rsenn/lc-meter/images/photos/DSC03275.png

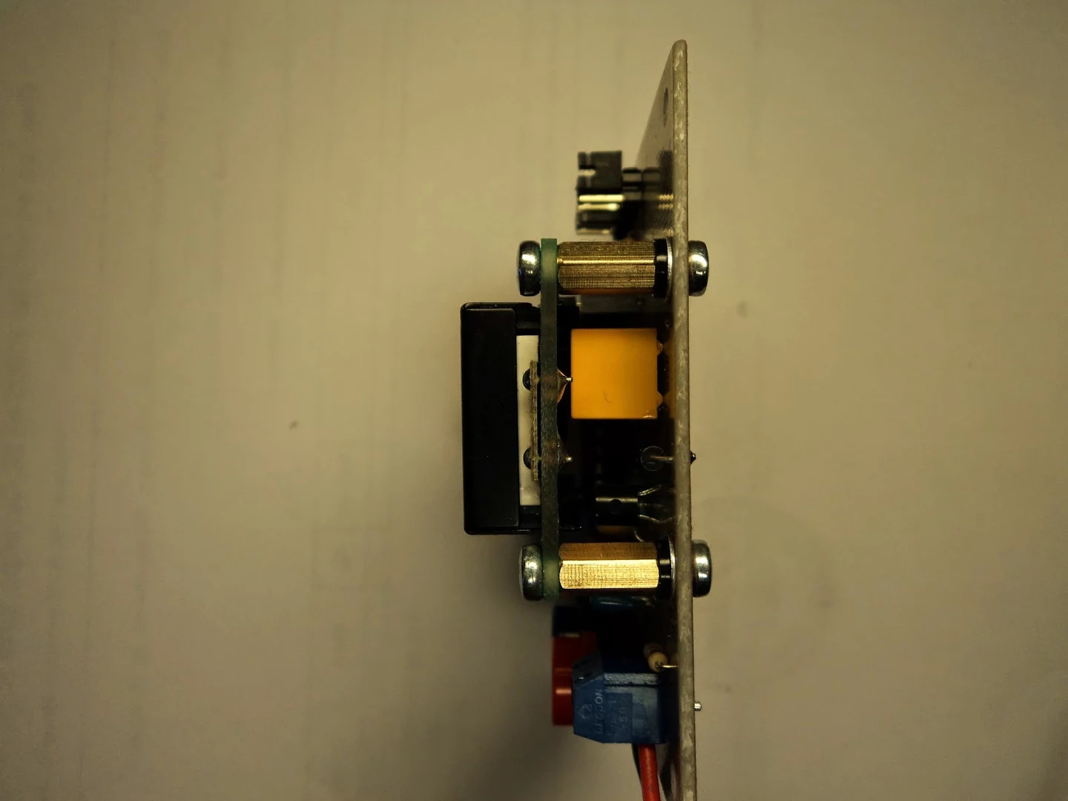
images/photos/DSC03275.png
