rsenn/lc-meter/images/lc-meter/Cardboard_Elsie_LC_meter.jpg

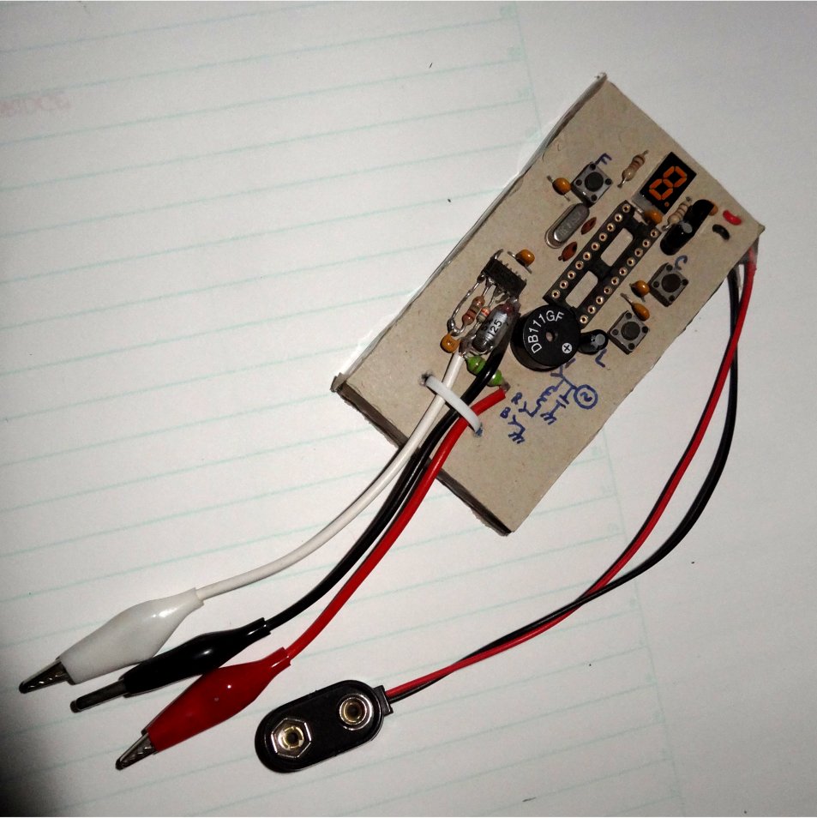
images/lc-meter/Cardboard_Elsie_LC_meter.jpg
