rsenn/lc-meter/807_lc_meter/pictures/P9010032_.JPG

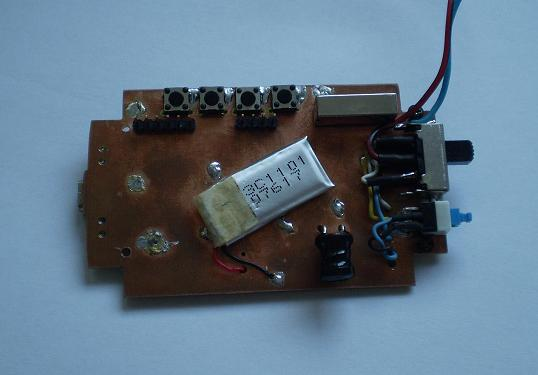
807_lc_meter/pictures/P9010032_.JPG
