rsenn/lc-meter/807_lc_meter/pictures/P9010042_.JPG

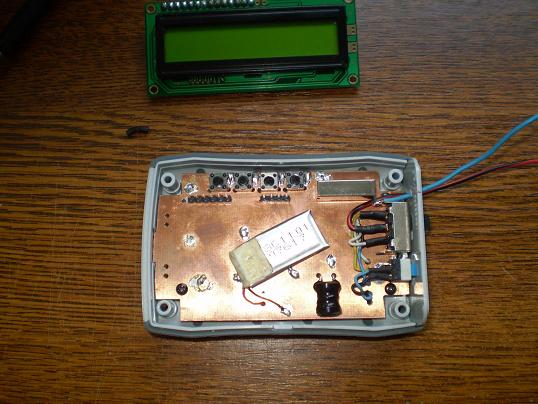
807_lc_meter/pictures/P9010042_.JPG
