rsenn/lc-meter/807_lc_meter/pictures/P9010051_.JPG

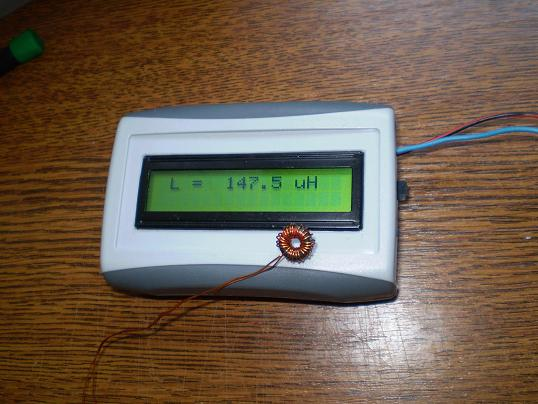
807_lc_meter/pictures/P9010051_.JPG
