rsenn/lc-meter/807_lc_meter/pictures/P9150070_.JPG

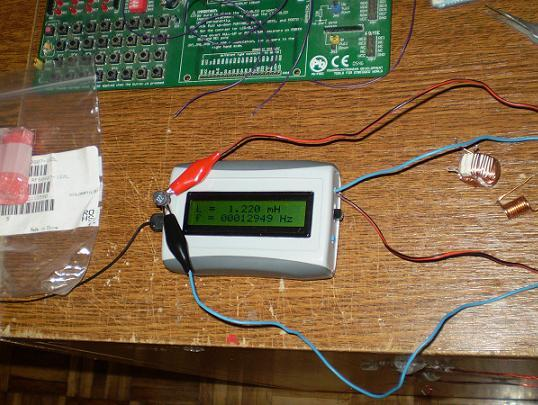
807_lc_meter/pictures/P9150070_.JPG
