rsenn/lc-meter/807_lc_meter/schematics-pcb/pcb.png

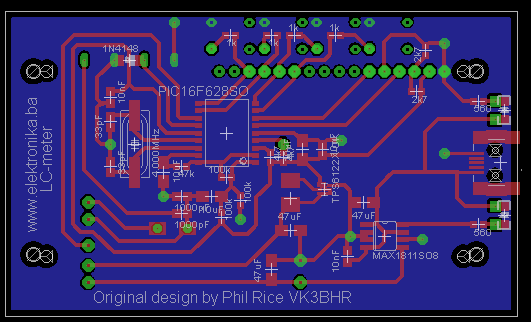
807_lc_meter/schematics-pcb/pcb.png
