rsenn/lc-meter/807_lc_meter/schematics-pcb/shema.png

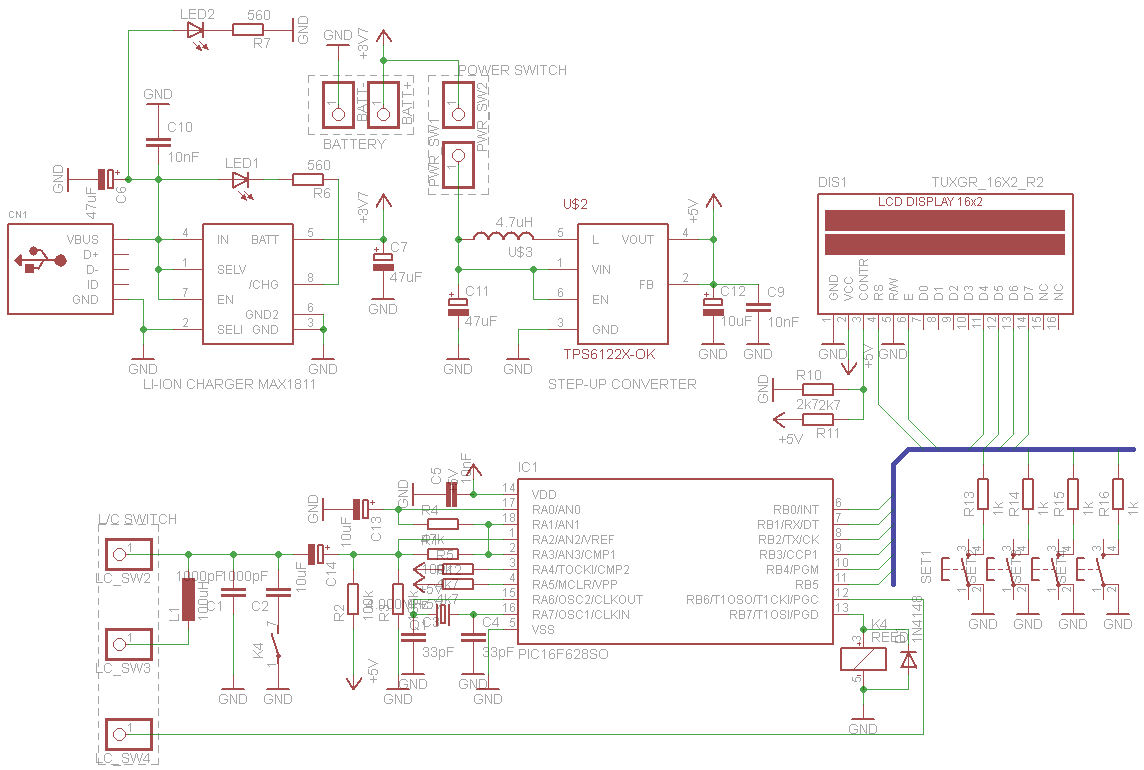
807_lc_meter/schematics-pcb/shema.png
