rsenn/lc-meter/doc/Bildschirmfoto_2019-12-28_08-31-02.png

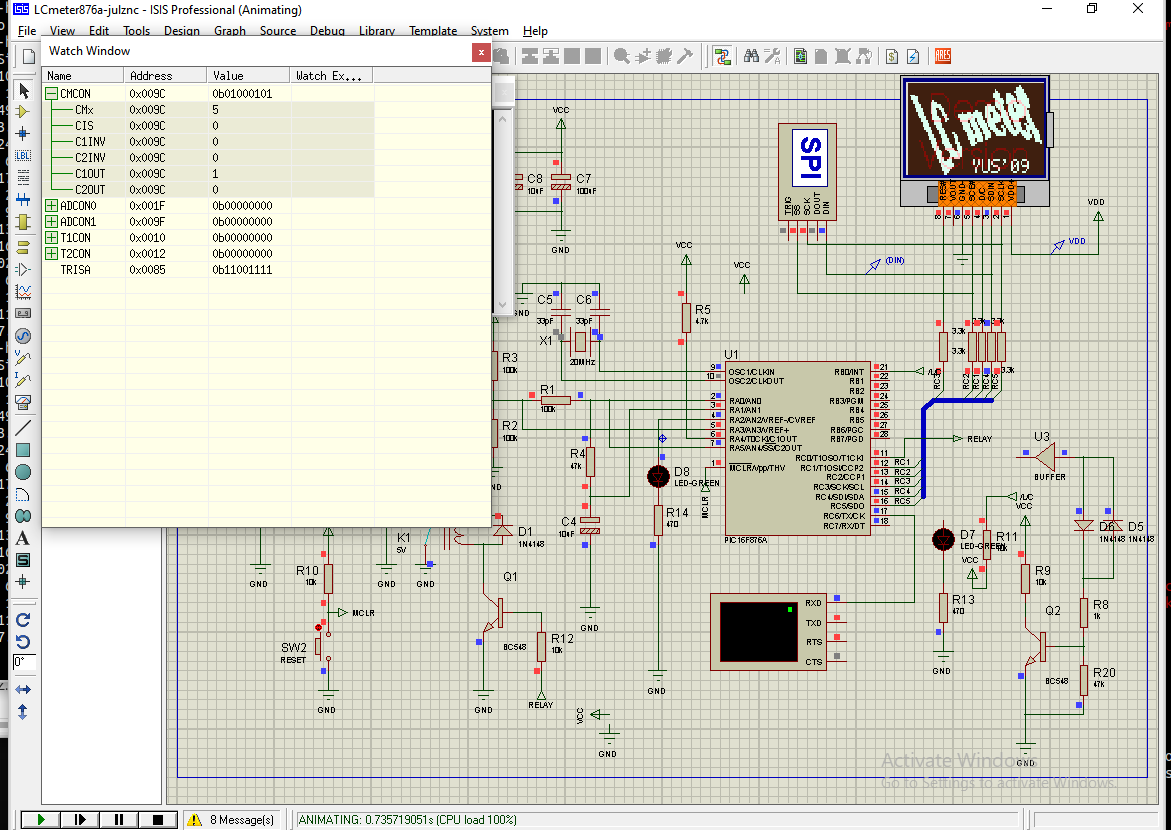
doc/Bildschirmfoto_2019-12-28_08-31-02.png
