rsenn/lc-meter/doc/Bildschirmfoto_2019-12-28_08-32-24.png

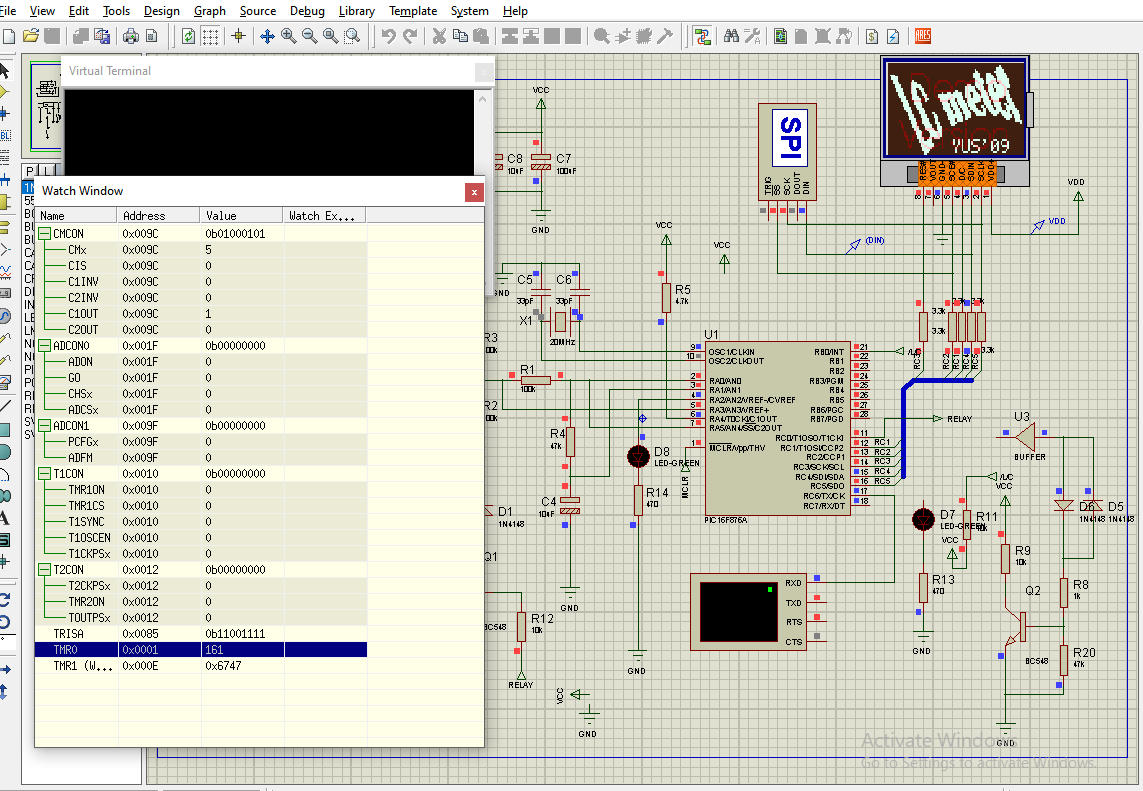
doc/Bildschirmfoto_2019-12-28_08-32-24.png
