rsenn/lc-meter/doc/LC meter pic16f876A (diagram and source code).jpg

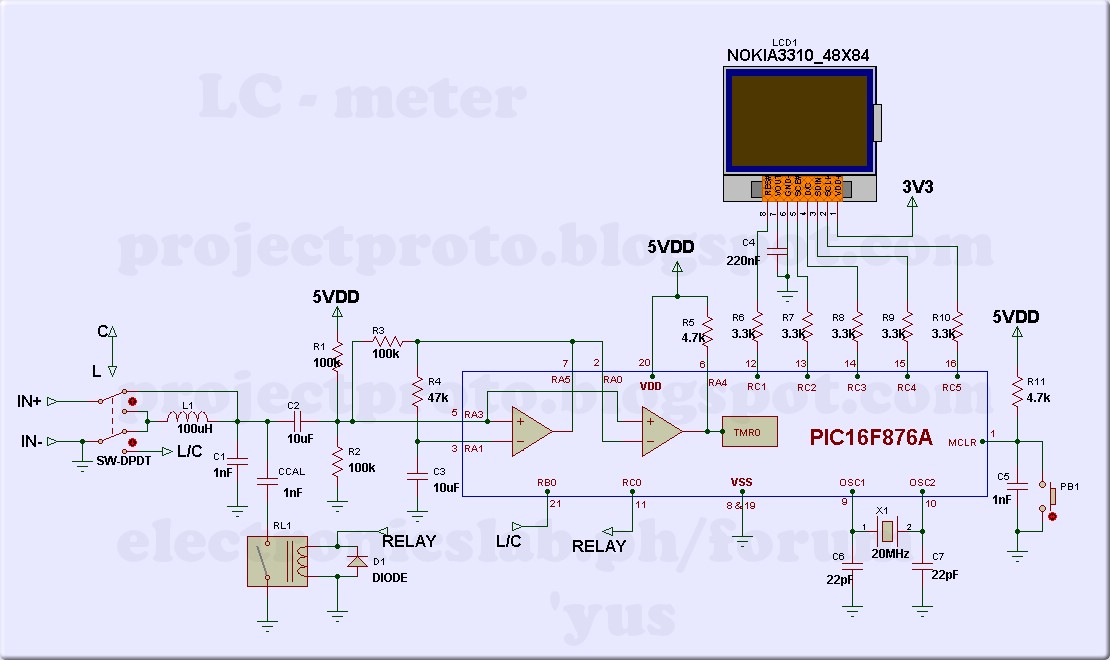
doc/LC meter pic16f876A (diagram and source code).jpg
