rsenn/lc-meter/doc/LC-meter-PCB.png

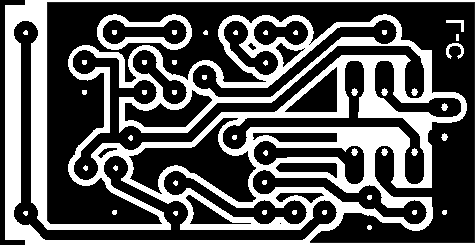
doc/LC-meter-PCB.png
