rsenn/lc-meter/doc/LCM_schematic.png

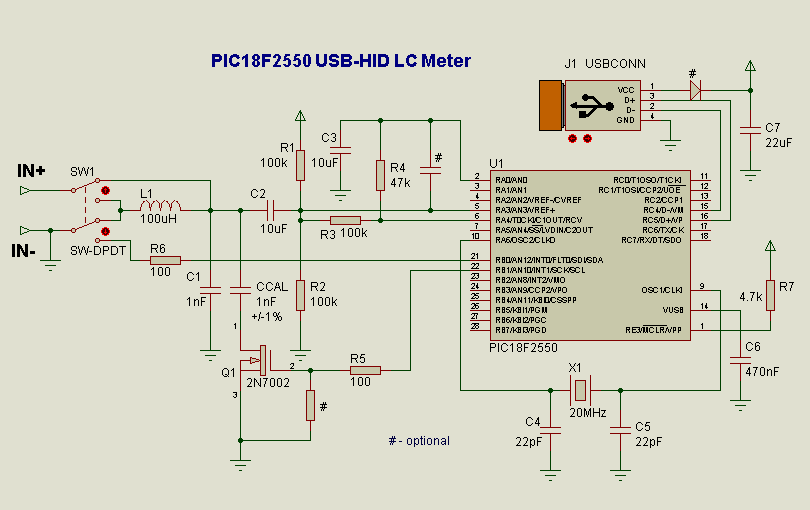
doc/LCM_schematic.png
