rsenn/lc-meter/doc/Main Board-LO.png

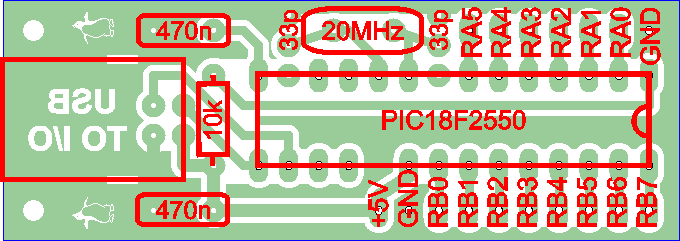
doc/Main Board-LO.png
