rsenn/lc-meter/doc/Main Board-PCB.png

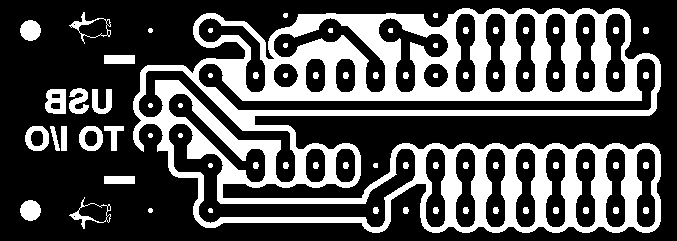
doc/Main Board-PCB.png
