rsenn/lc-meter/doc/nokia5510/Clipboard02.png

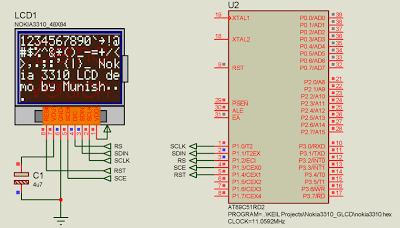
doc/nokia5510/Clipboard02.png
