rsenn/lc-meter/doc/nokia5510/microcontroller-based-true-rms-mains-voltage-frequency-mter-6.jpg

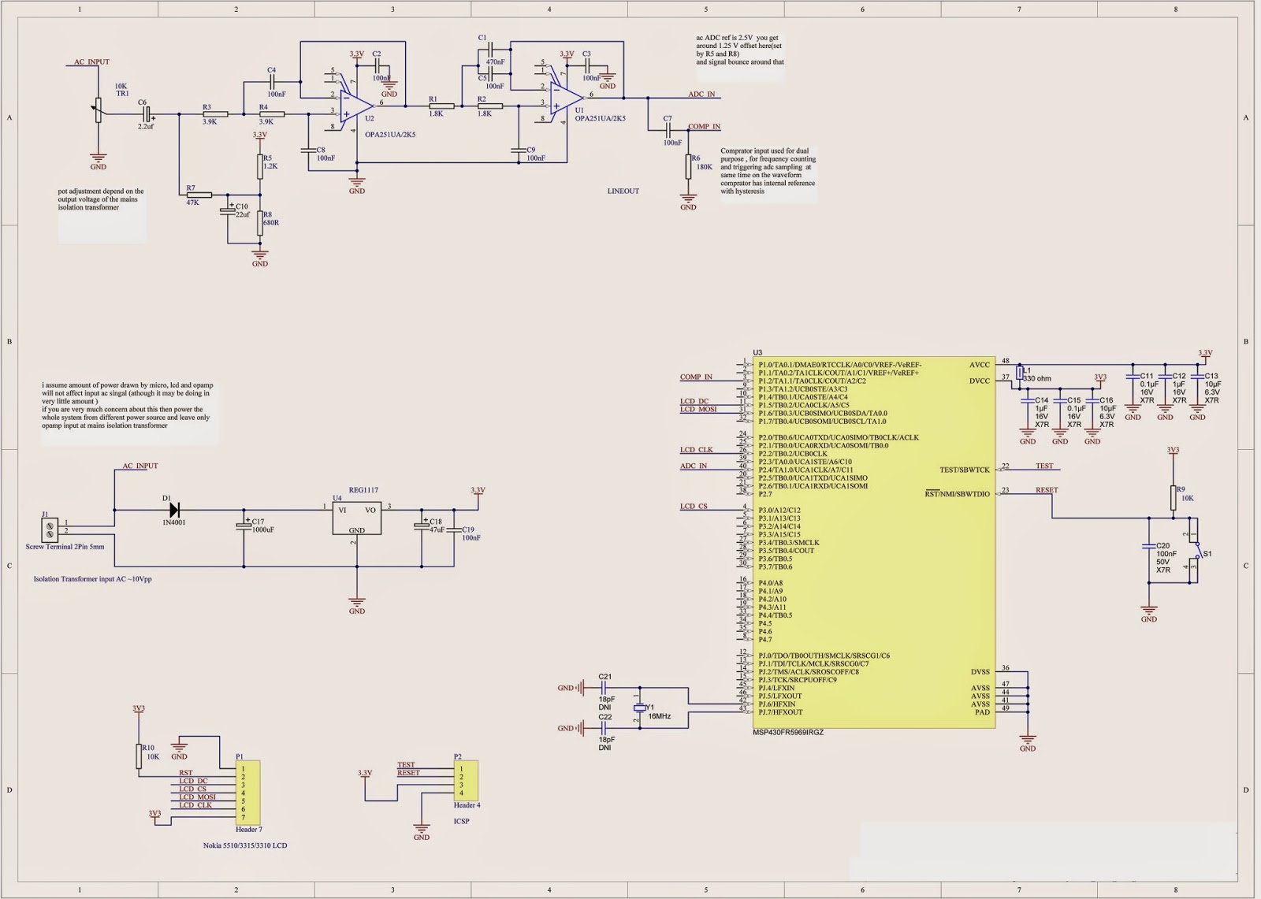
doc/nokia5510/microcontroller-based-true-rms-mains-voltage-frequency-mter-6.jpg
