rsenn/lc-meter/doc/nokia5510/Nokia 3315 3310 lcd interfaceing microcontroller.jpg

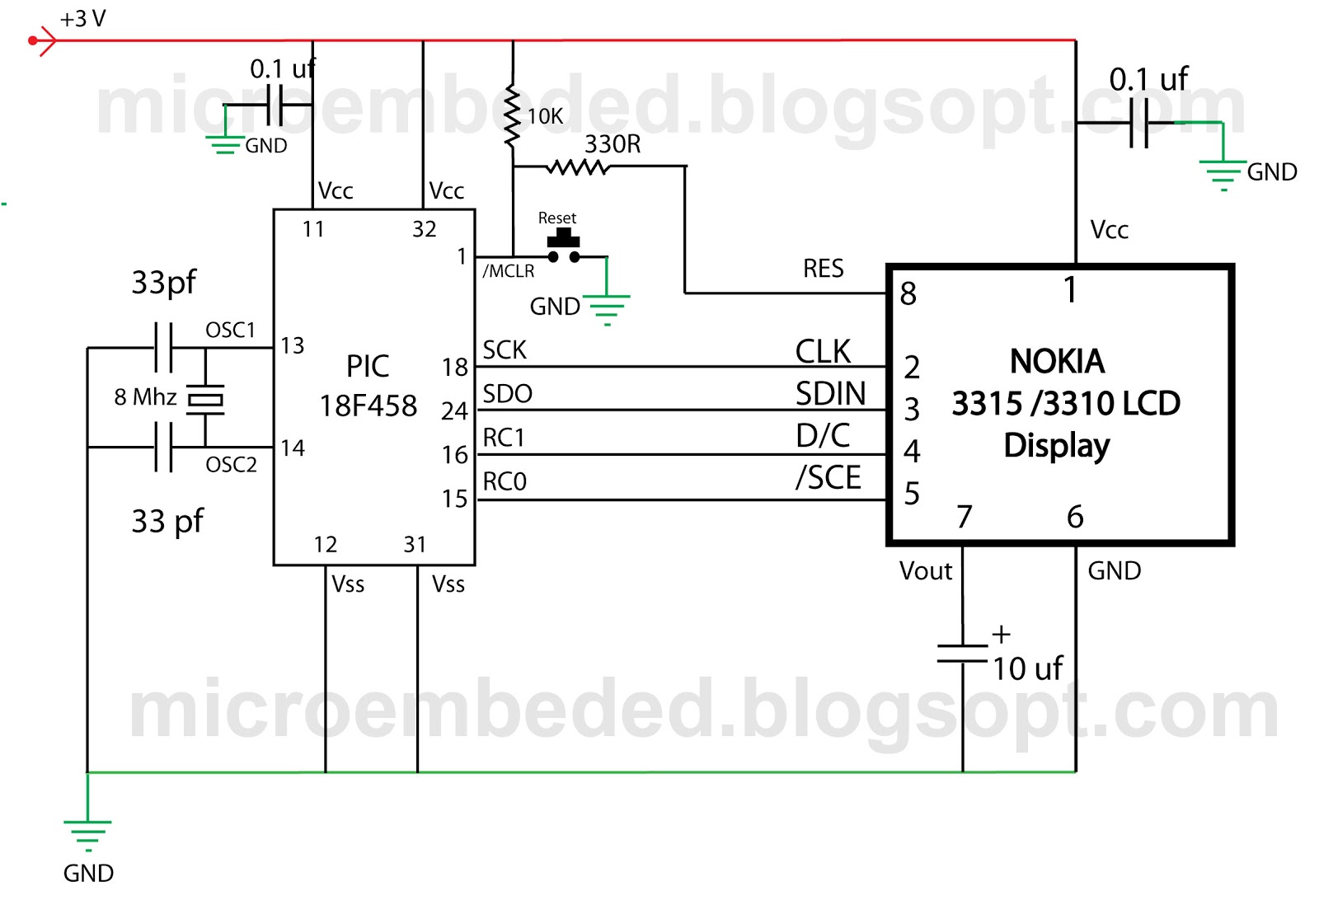
doc/nokia5510/Nokia 3315 3310 lcd interfaceing microcontroller.jpg
