rsenn/lc-meter/doc/nokia5510/Nokia-5110-LCD-Arduino-3-wire-control-fit-499x192.jpg

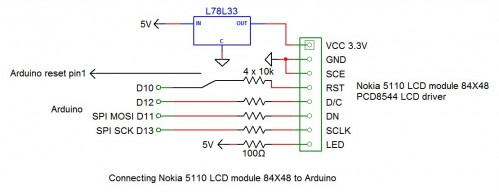
doc/nokia5510/Nokia-5110-LCD-Arduino-3-wire-control-fit-499x192.jpg
