rsenn/lc-meter/doc/nokia5510/nokia_pin.bmp

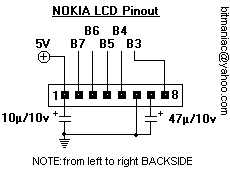
doc/nokia5510/nokia_pin.bmp
