rsenn/lc-meter/doc/nokia5510/nokialcd1.jpg

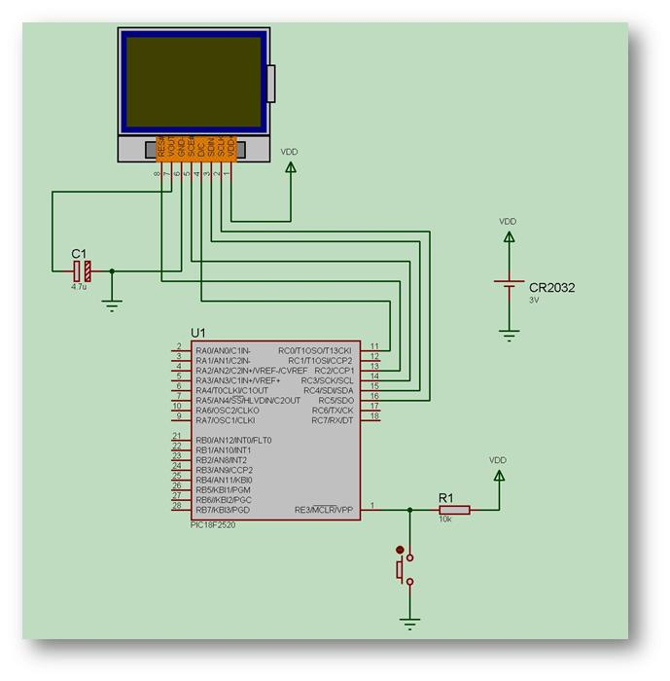
doc/nokia5510/nokialcd1.jpg
