rsenn/lc-meter/doc/nokia5510/pinout_5110.jpg

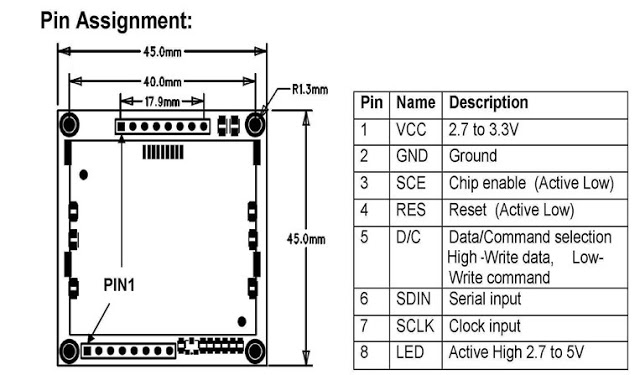
doc/nokia5510/pinout_5110.jpg
