rsenn/lc-meter/doc/nokia5510/schematic.JPG

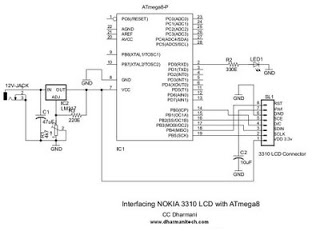
doc/nokia5510/schematic.JPG
