rsenn/lc-meter/doc/state-julznc.png

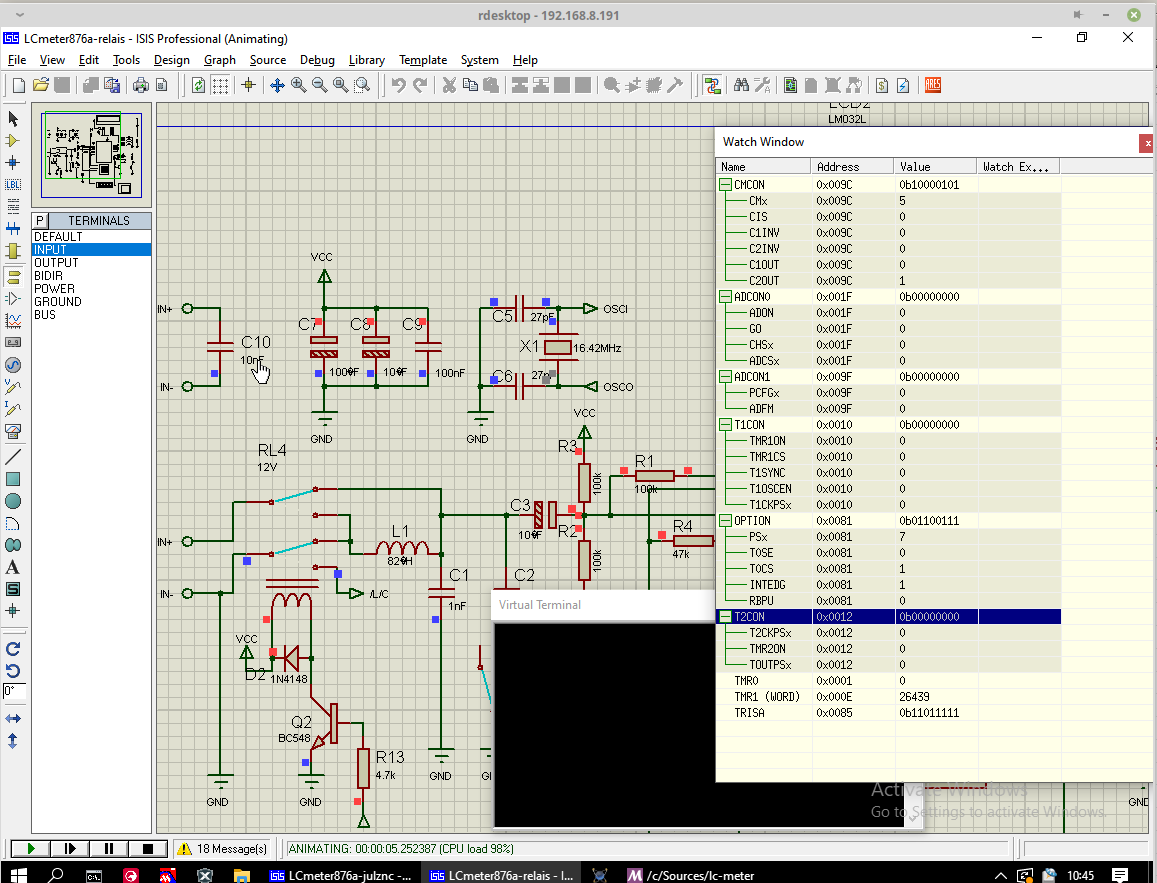
doc/state-julznc.png
