rsenn/lc-meter/doc/state-mylcmeter.png

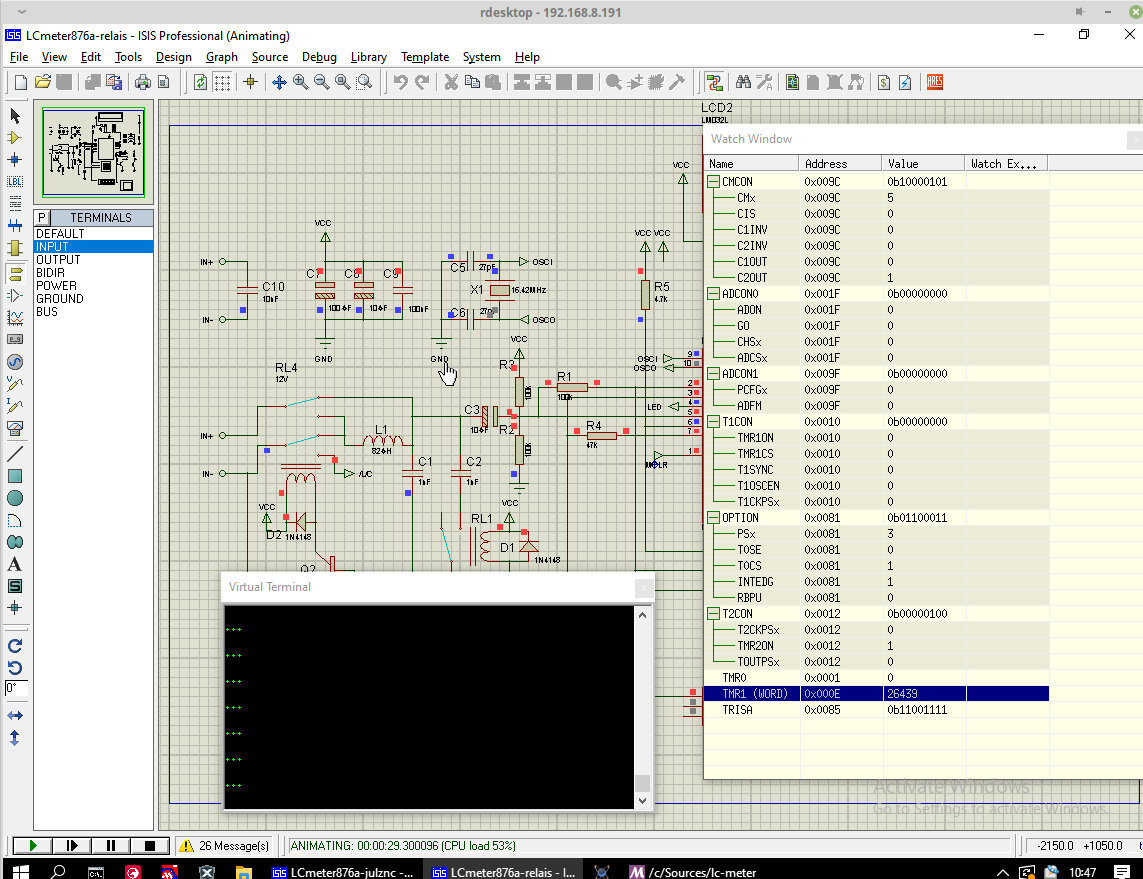
doc/state-mylcmeter.png
