rsenn/lc-meter/images/diagram_876A.jpg

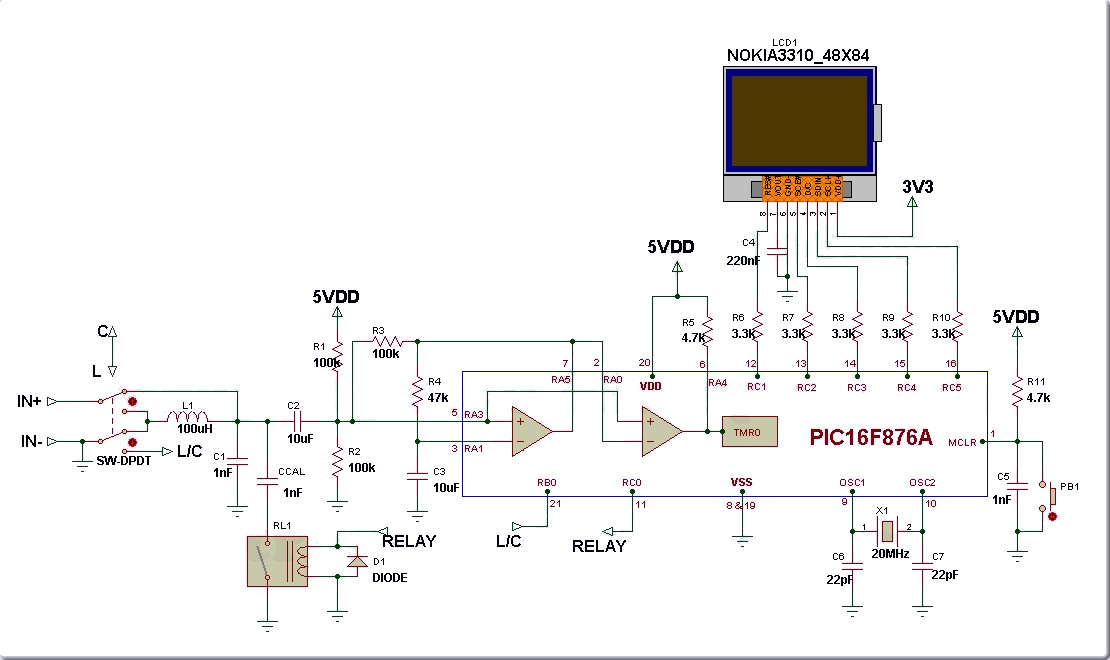
images/diagram_876A.jpg
