rsenn/lc-meter/images/Eqs.JPG

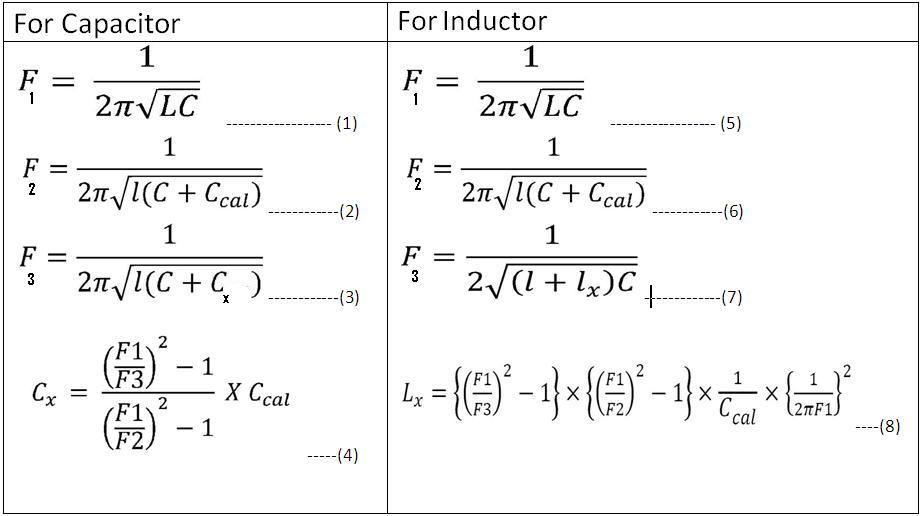
images/Eqs.JPG
