rsenn/lc-meter/images/lc-meter/75_1338304507_thumb.jpg

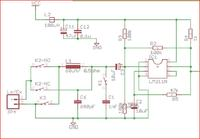
images/lc-meter/75_1338304507_thumb.jpg
