rsenn/lc-meter/images/lc-meter/315d69d17d779b38c8db49fd7d542553.png

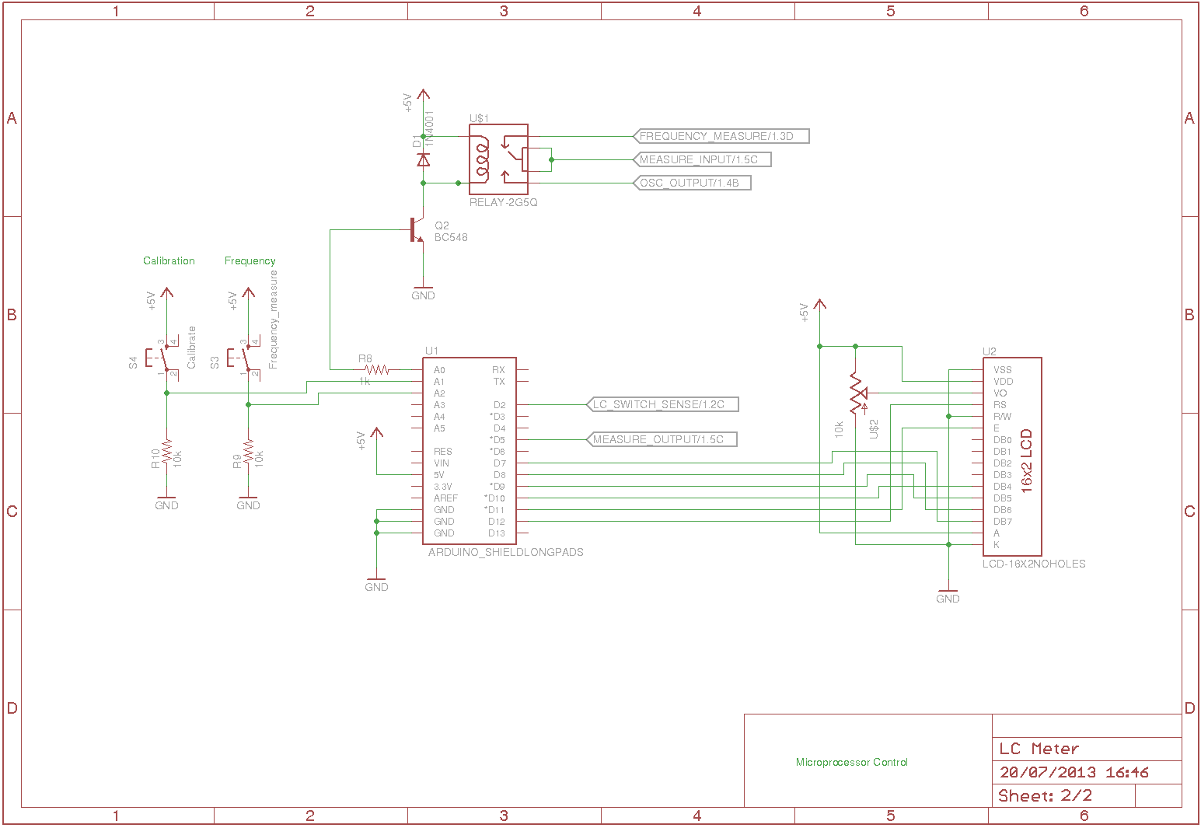
images/lc-meter/315d69d17d779b38c8db49fd7d542553.png
