rsenn/lc-meter/images/lc-meter/1310820125_20897_FT49373_diagram.png

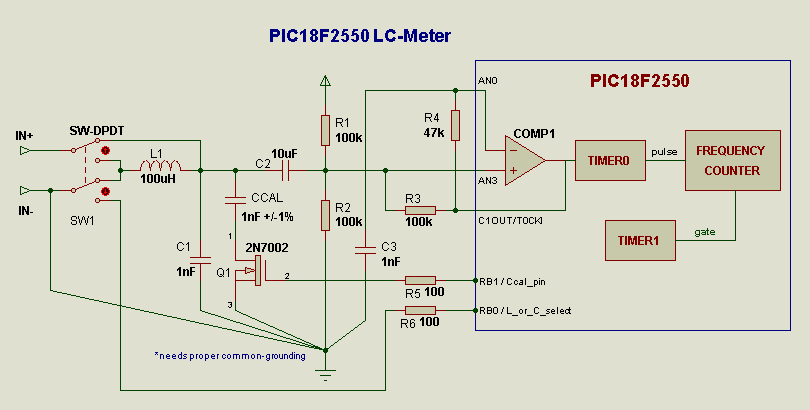
images/lc-meter/1310820125_20897_FT49373_diagram.png
