rsenn/lc-meter/images/lc-meter/3660040649_gPn5AtaT_lc-meter-4.jpg

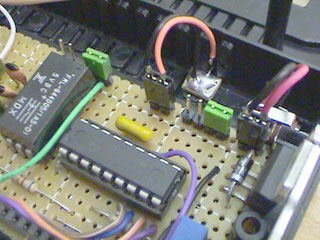
images/lc-meter/3660040649_gPn5AtaT_lc-meter-4.jpg
