rsenn/lc-meter/images/lc-meter/diagram_876A.jpg

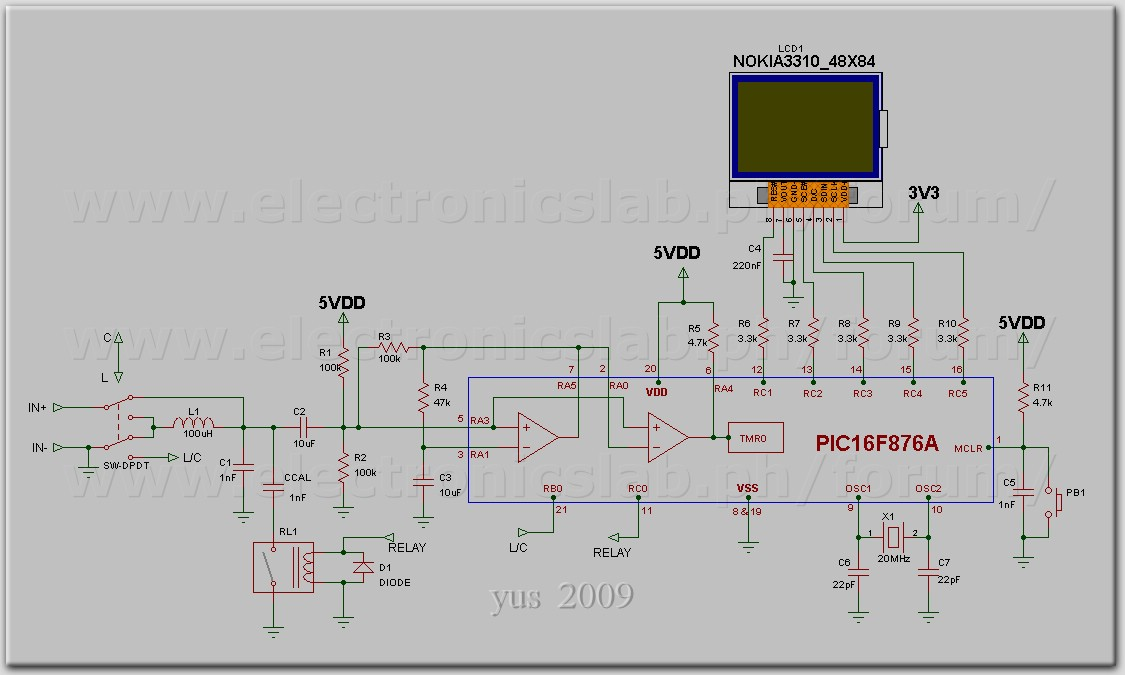
images/lc-meter/diagram_876A.jpg
