rsenn/lc-meter/images/lc-meter/Fig_2.gif

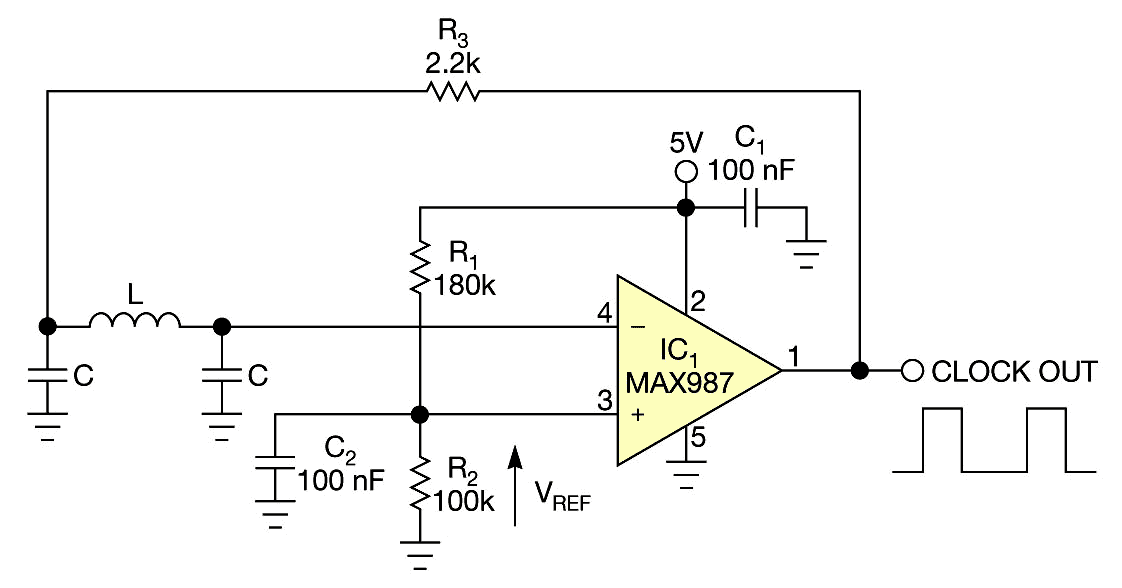
images/lc-meter/Fig_2.gif
