rsenn/lc-meter/images/lc-meter/form5.png

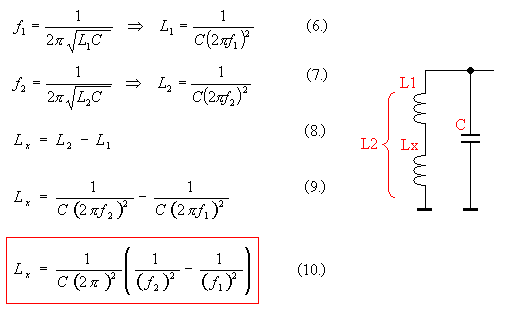
images/lc-meter/form5.png
