rsenn/lc-meter/images/lc-meter/foto3.jpg

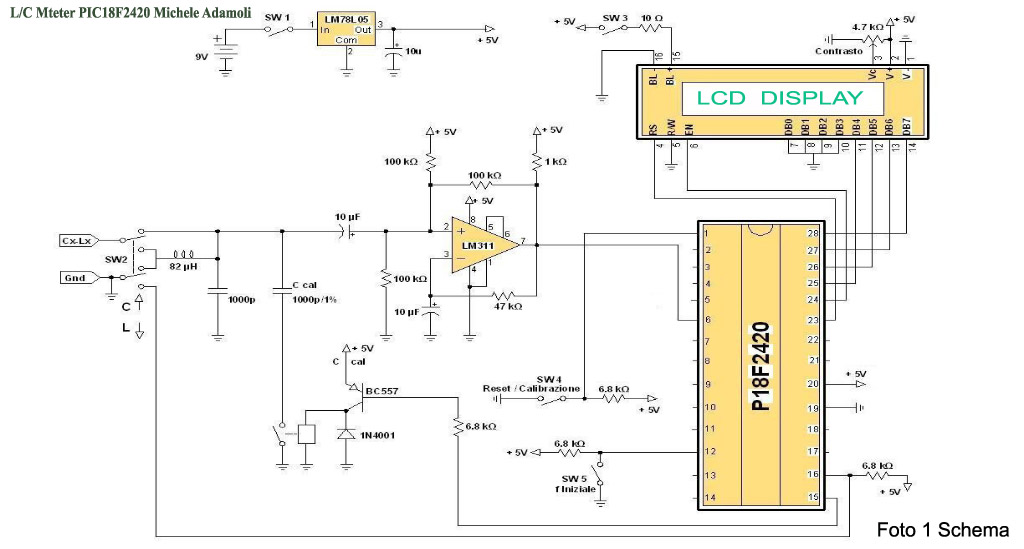
images/lc-meter/foto3.jpg
