rsenn/lc-meter/images/lc-meter/images.png

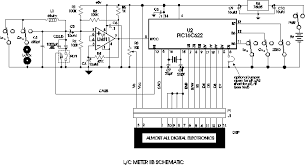
images/lc-meter/images.png
