rsenn/lc-meter/images/lc-meter/LC meter analogue section.png

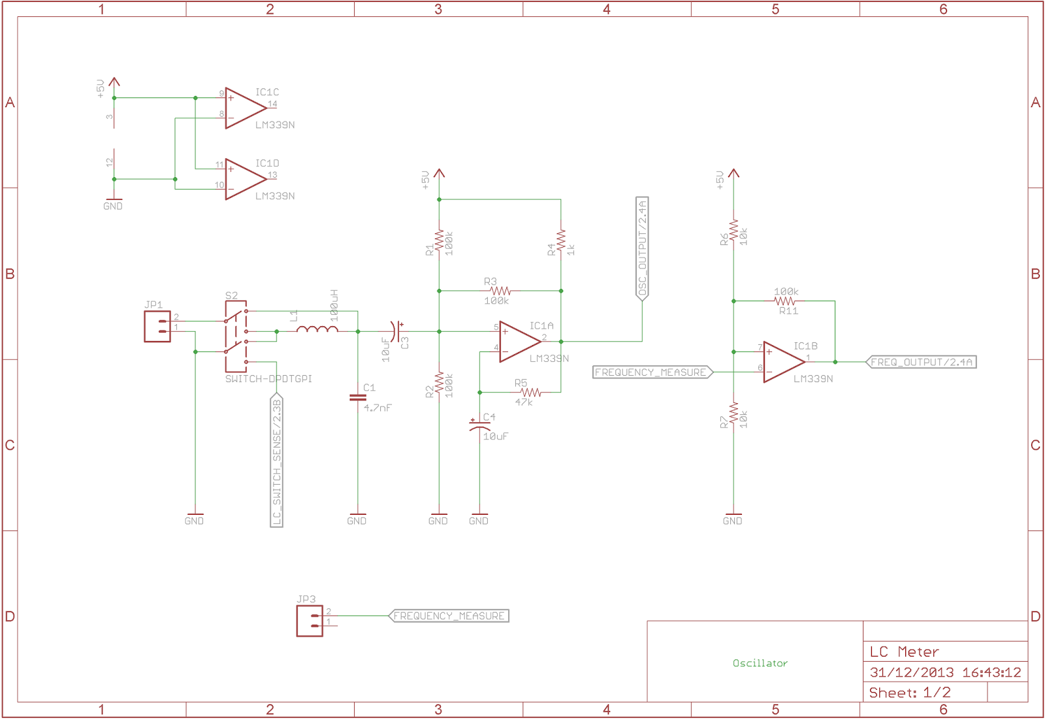
images/lc-meter/LC meter analogue section.png
