rsenn/lc-meter/images/lc-meter/LC Meter Sheet.jpg

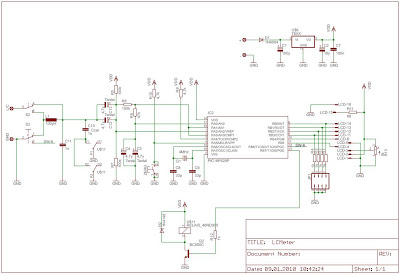
images/lc-meter/LC Meter Sheet.jpg
