rsenn/lc-meter/images/lc-meter/lc-meter-circuit.jpg

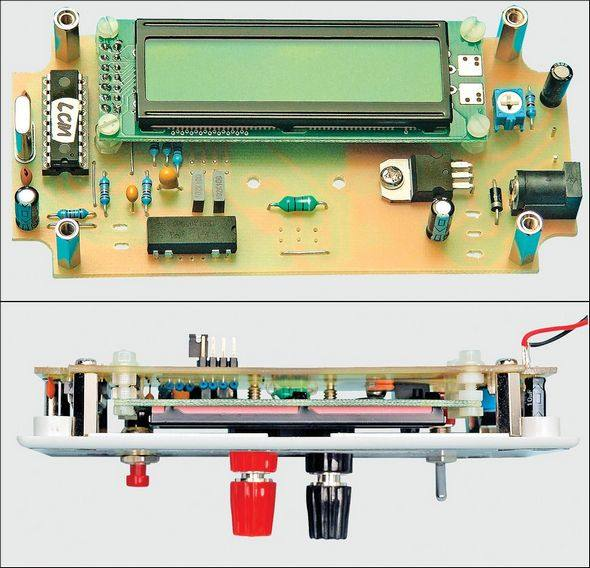
images/lc-meter/lc-meter-circuit.jpg
