rsenn/lc-meter/images/lc-meter/LC-meter-LO.png

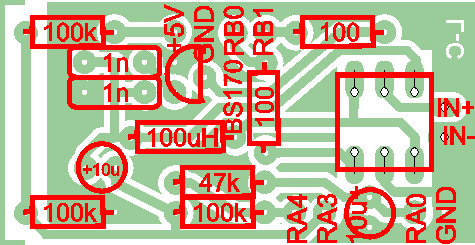
images/lc-meter/LC-meter-LO.png
