rsenn/lc-meter/images/lc-meter/LCM3 (schem).png

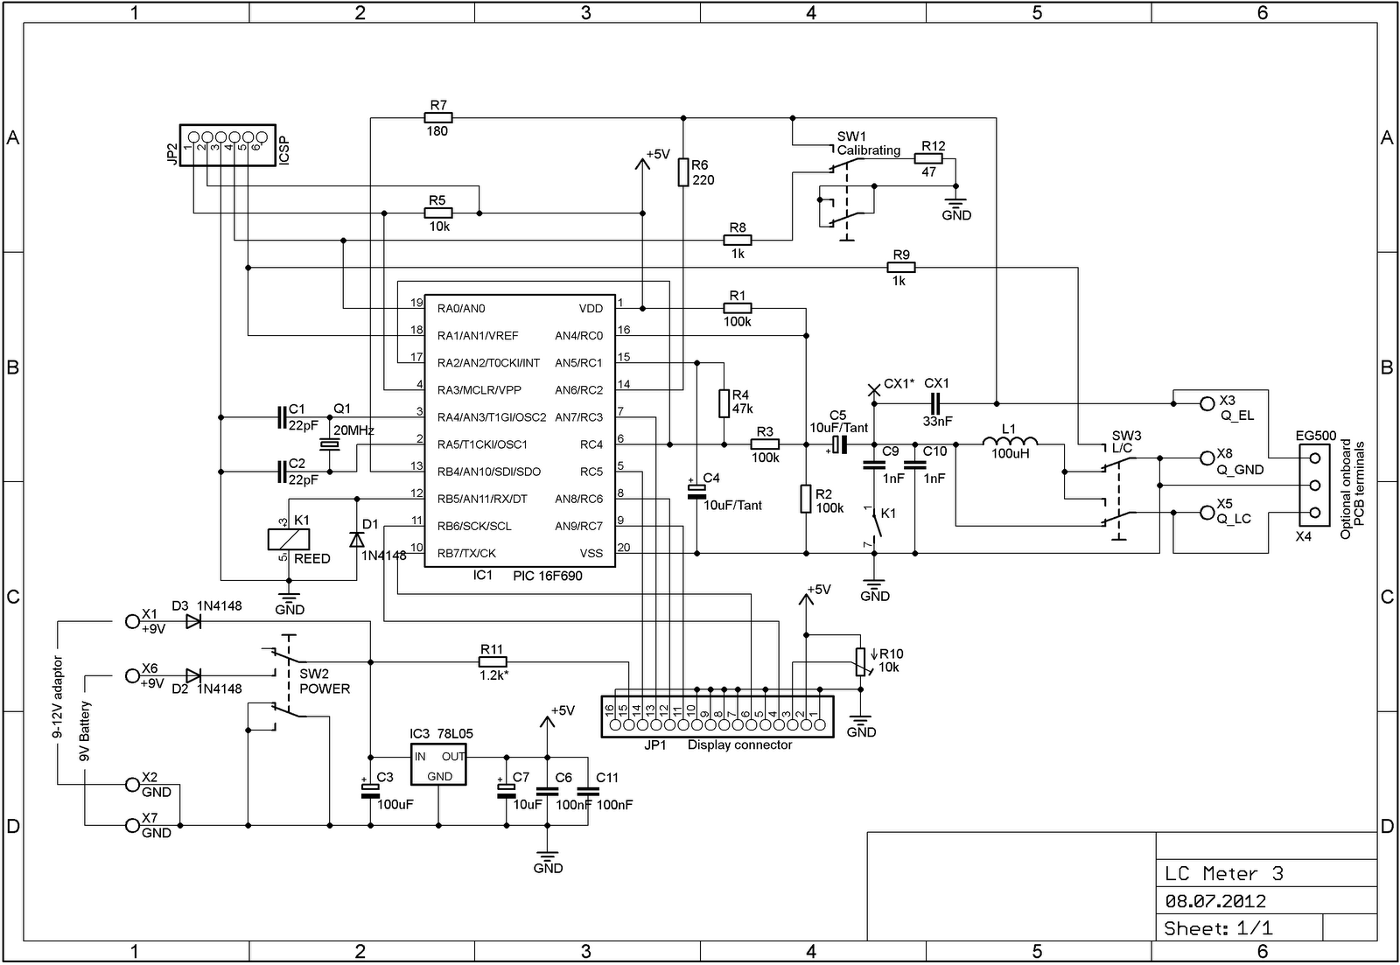
images/lc-meter/LCM3 (schem).png
