rsenn/lc-meter/images/lc-meter/lcm-fig1.gif

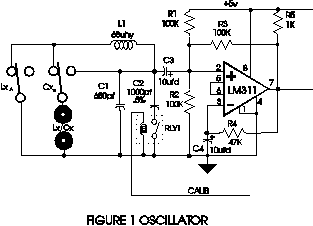
images/lc-meter/lcm-fig1.gif
