rsenn/lc-meter/images/lc-meter/LCmeter0.png

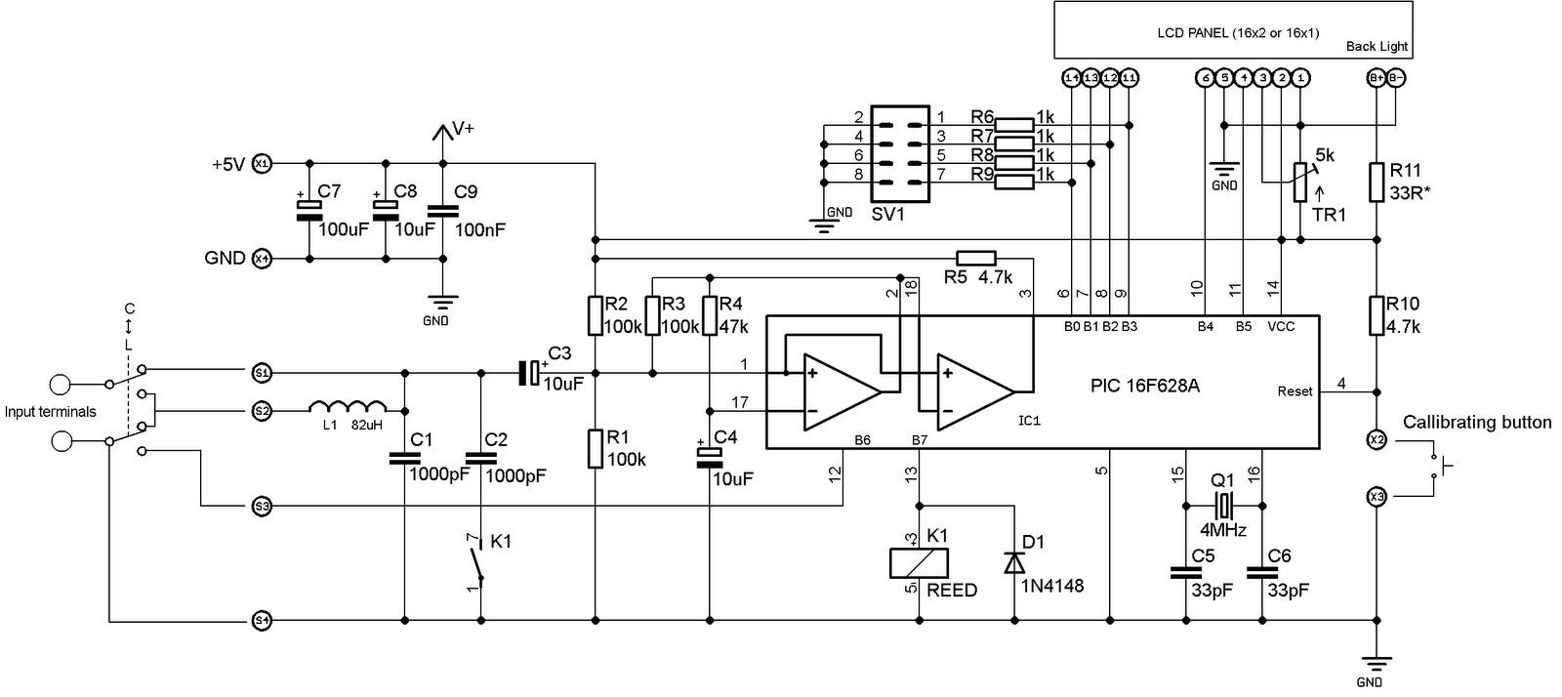
images/lc-meter/LCmeter0.png
