rsenn/lc-meter/images/lc-meter/lcmeter1-3.jpeg

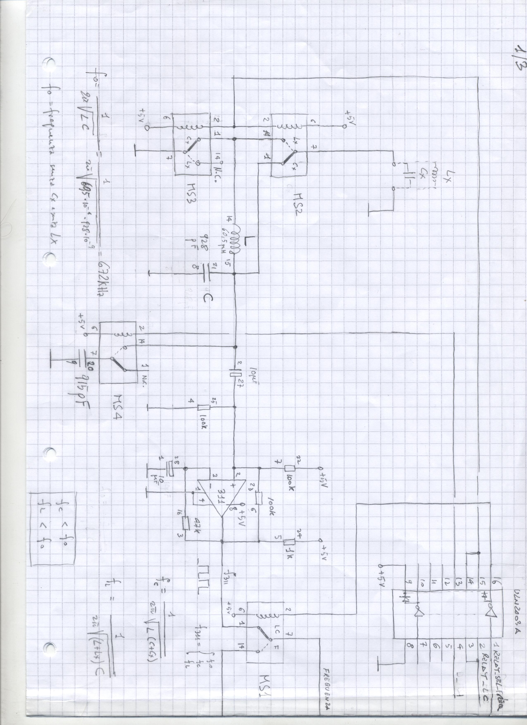
images/lc-meter/lcmeter1-3.jpeg
