rsenn/lc-meter/images/lc-meter/lcmeter.gif

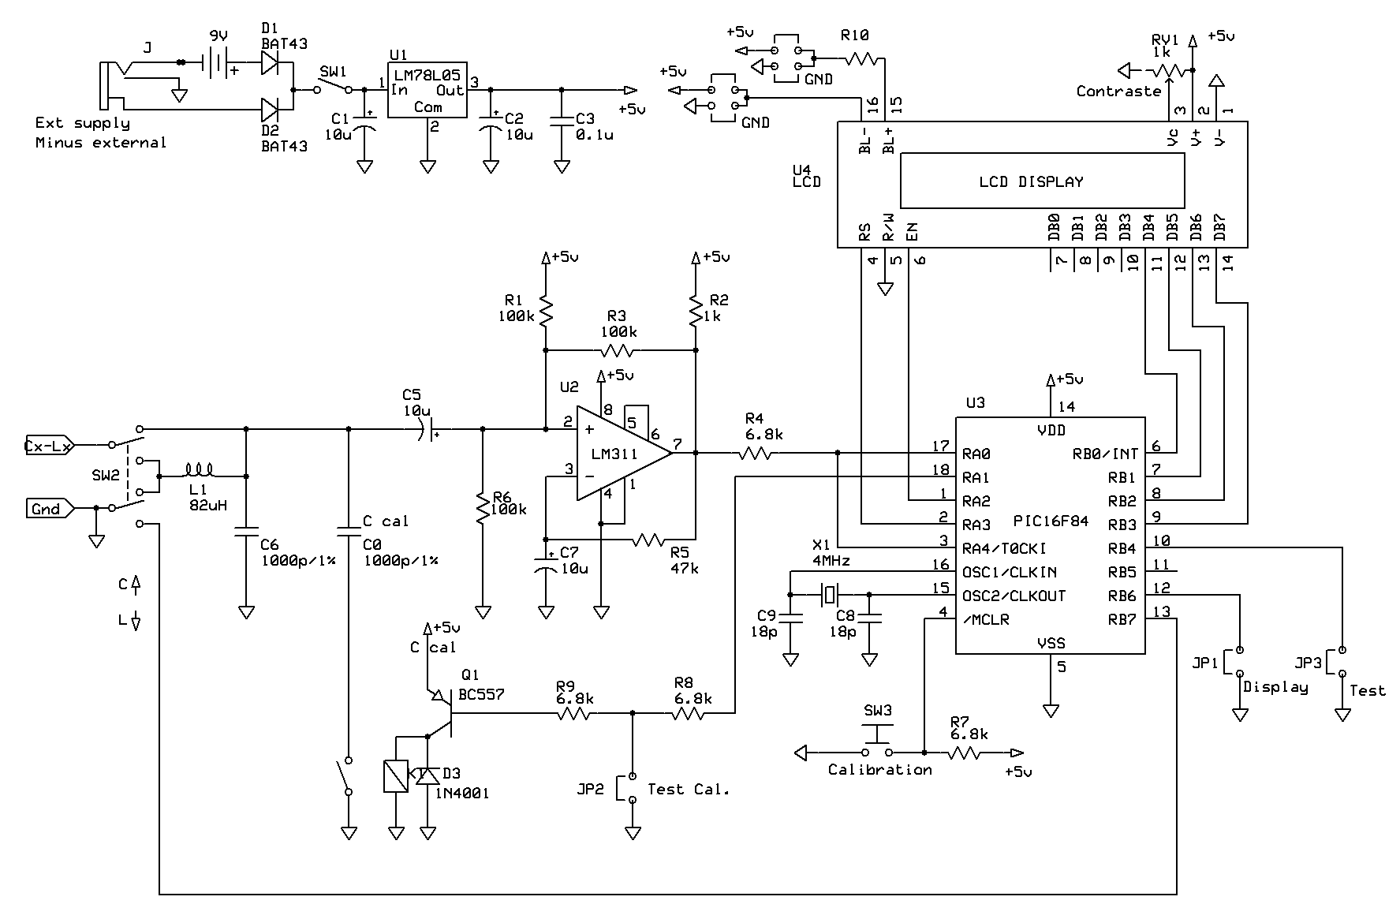
images/lc-meter/lcmeter.gif
