rsenn/lc-meter/images/lc-meter/lcmeter_schematic-465x236.jpg

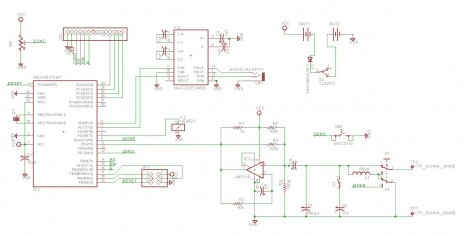
images/lc-meter/lcmeter_schematic-465x236.jpg
