rsenn/lc-meter/images/lc-meter/Lmeter_schem.gif

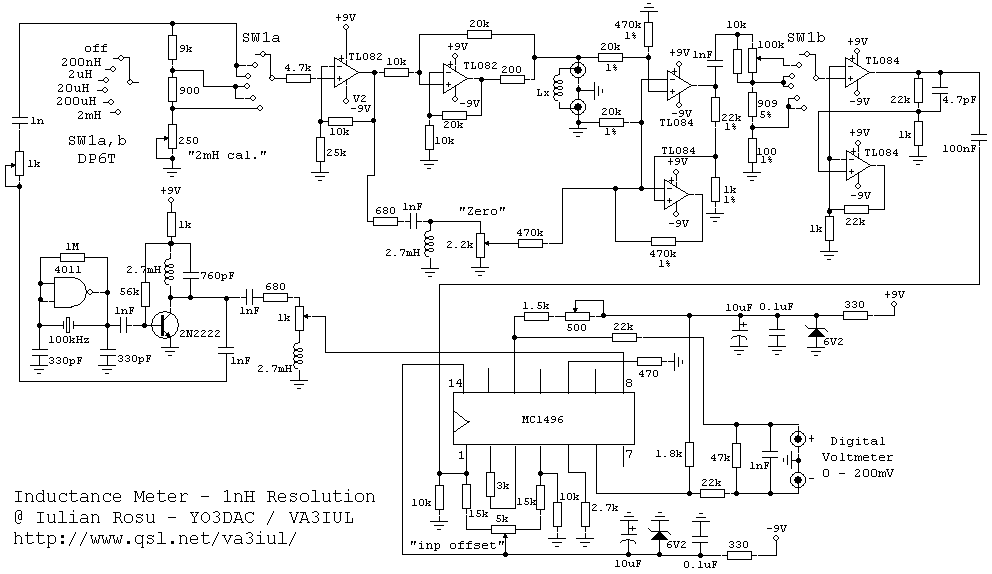
images/lc-meter/Lmeter_schem.gif
