rsenn/lc-meter/images/lc-meter/mg_1146.jpg

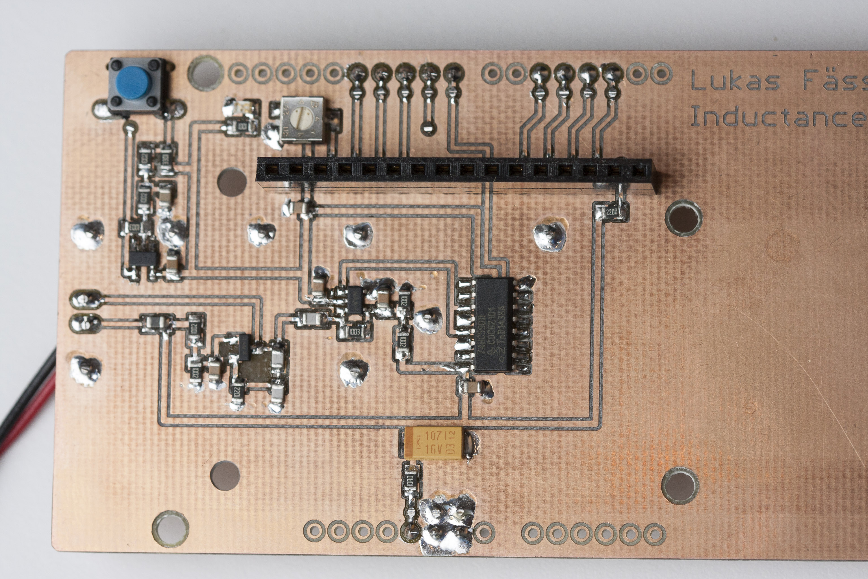
images/lc-meter/mg_1146.jpg
