rsenn/lc-meter/images/lc-meter/mg_1183-600.jpg

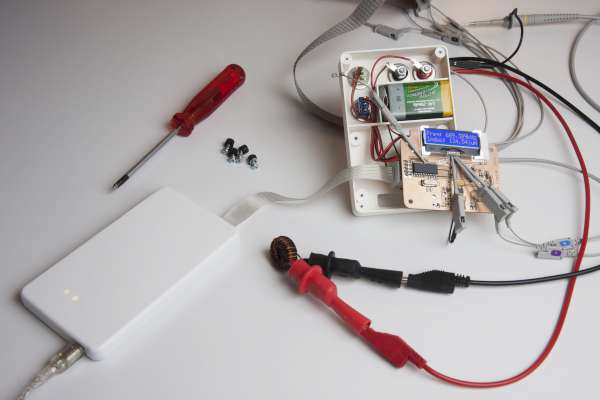
images/lc-meter/mg_1183-600.jpg
