rsenn/lc-meter/images/lc-meter/My_LC_meter.png

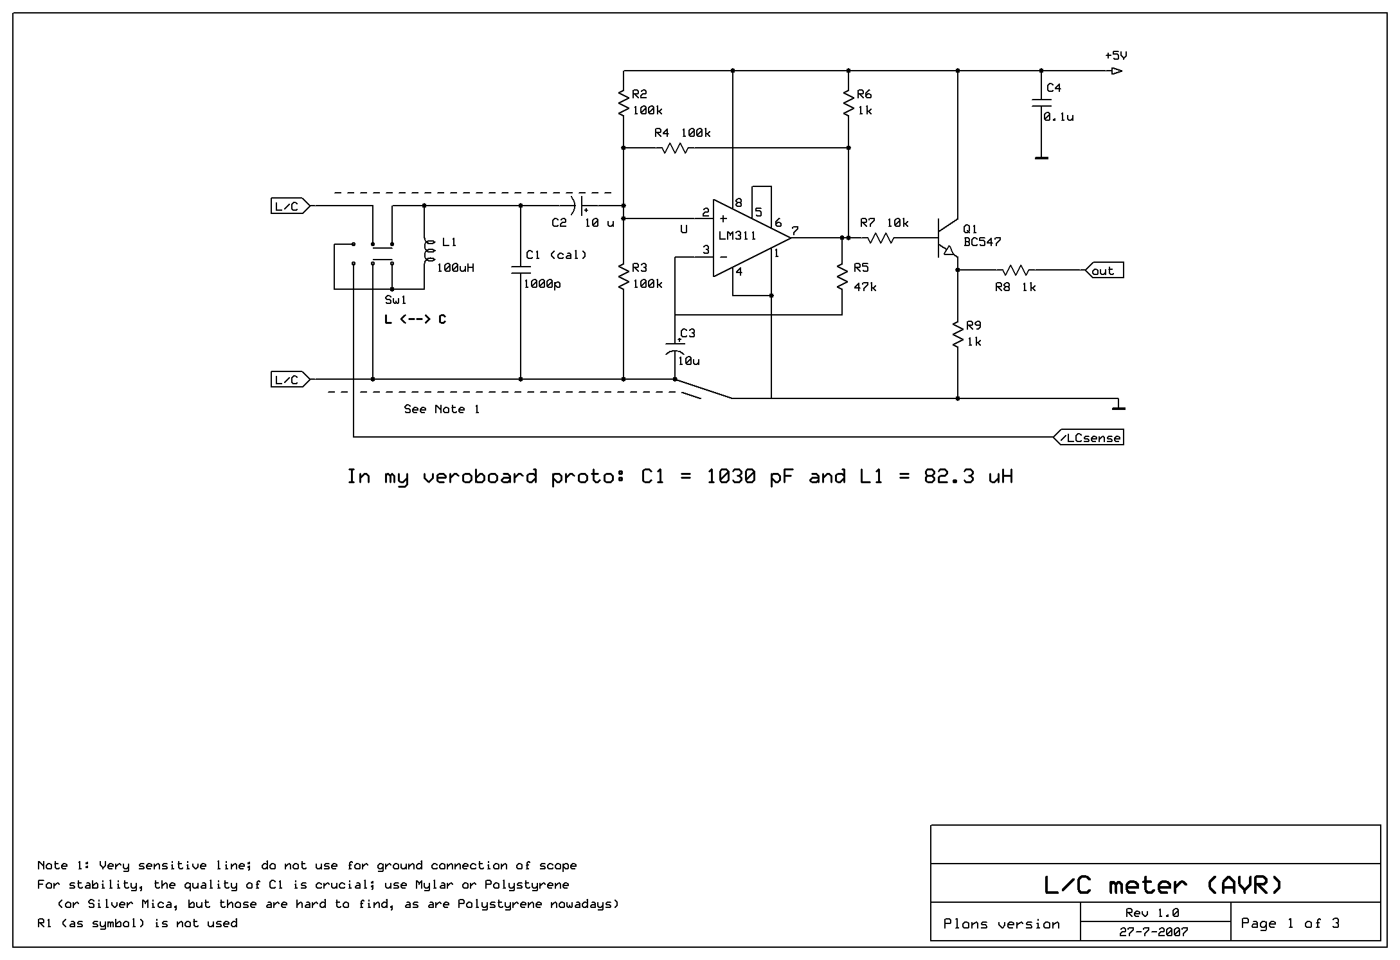
images/lc-meter/My_LC_meter.png
