rsenn/lc-meter/images/lc-meter/MyPCB-LC-Chematic.jpg

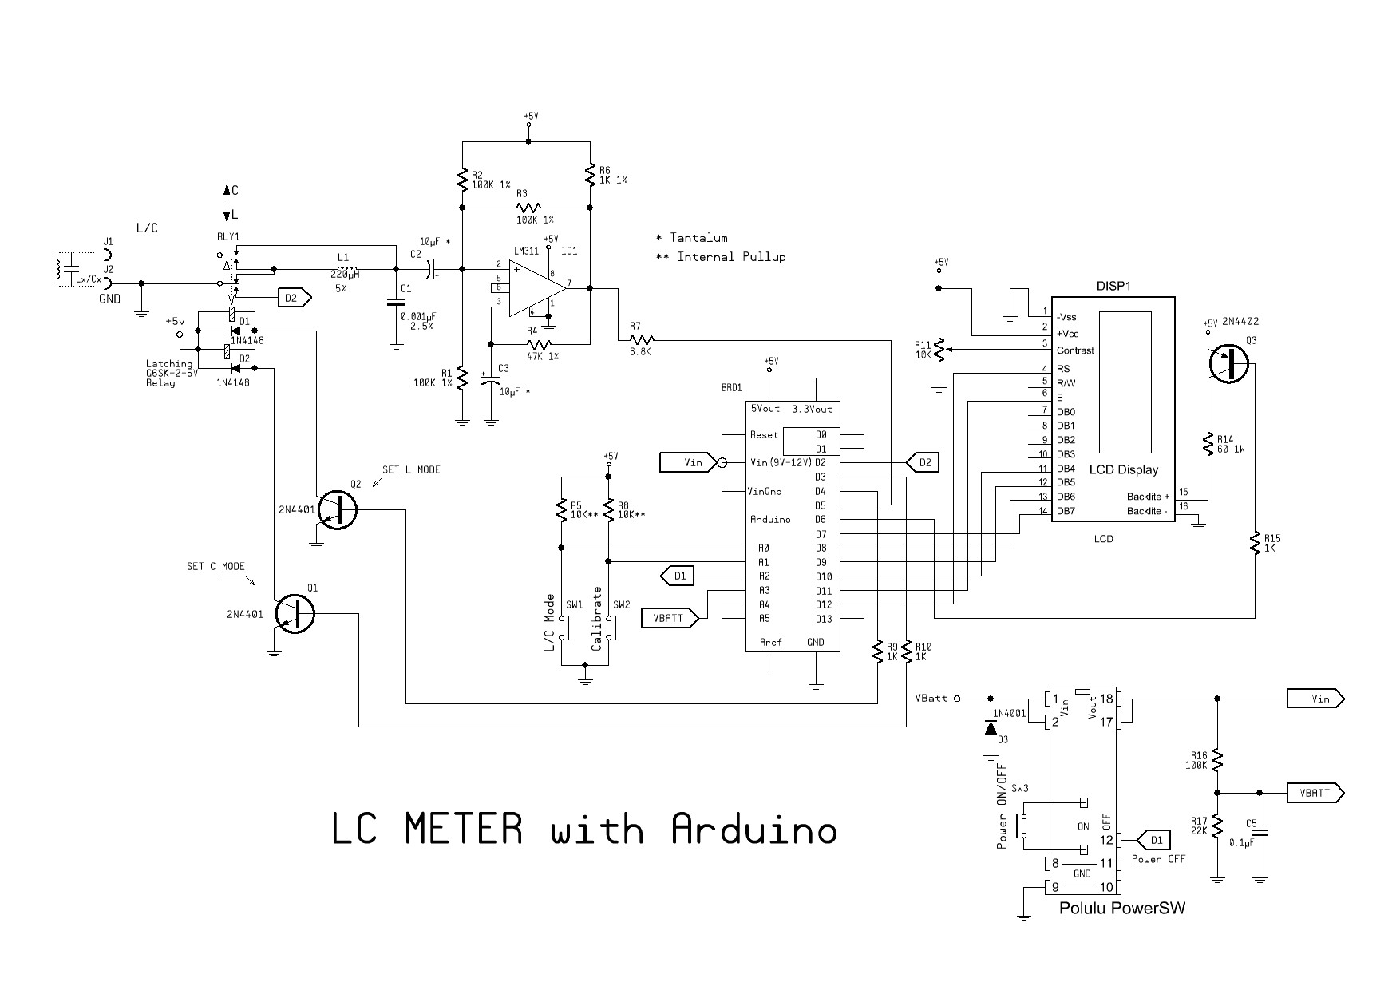
images/lc-meter/MyPCB-LC-Chematic.jpg
