rsenn/lc-meter/images/lc-meter/nH-meter-circuit.jpg

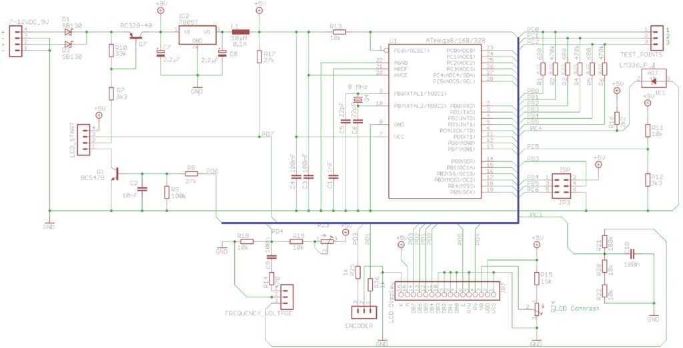
images/lc-meter/nH-meter-circuit.jpg
