rsenn/lc-meter/images/lc-meter/p121-f4.gif

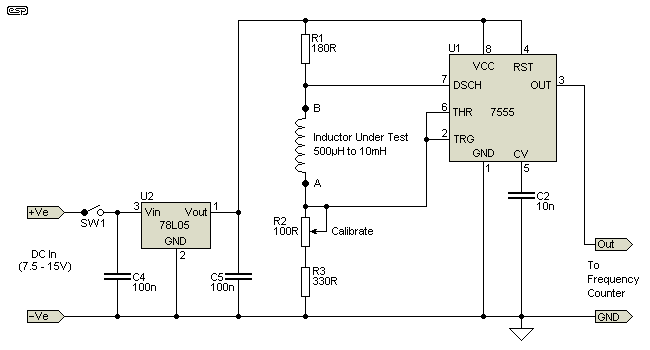
images/lc-meter/p121-f4.gif
