rsenn/lc-meter/images/lc-meter/p3030450.jpg

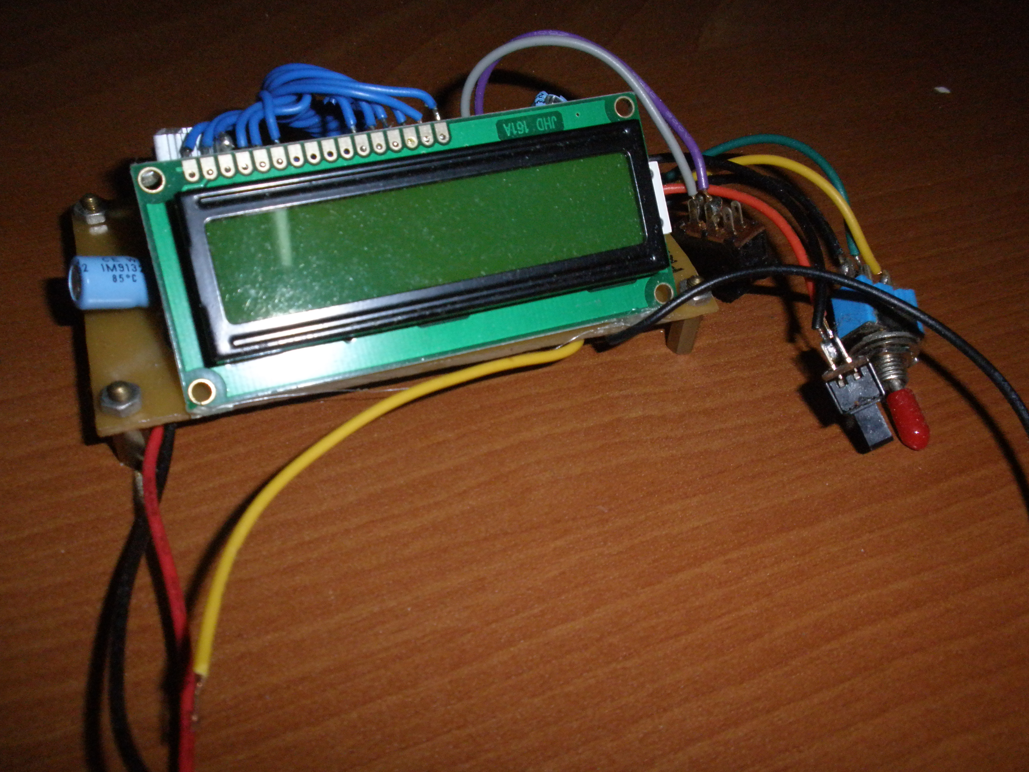
images/lc-meter/p3030450.jpg
