rsenn/lc-meter/images/lc-meter/PIC18F%A4%F2%BB%C8%A4%C3%A4%BFLC%A5%E1%A1%BC%A5%BF%A1%BC%A4%CE%C0%BD%BA%EE.pic18f%5Flc%2Dmeter%5Fpcbe.png

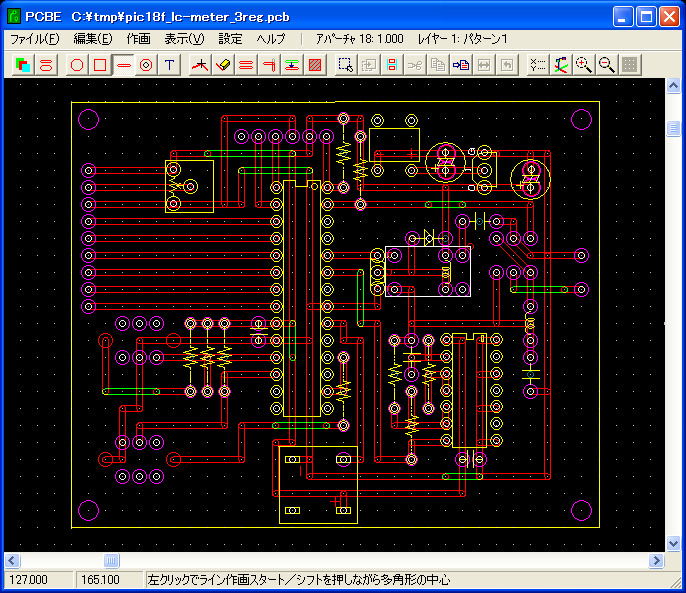
images/lc-meter/PIC18F%A4%F2%BB%C8%A4%C3%A4%BFLC%A5%E1%A1%BC%A5%BF%A1%BC%A4%CE%C0%BD%BA%EE.pic18f%5Flc%2Dmeter%5Fpcbe.png
