rsenn/lc-meter/images/lc-meter/pic-cookbook.jpg

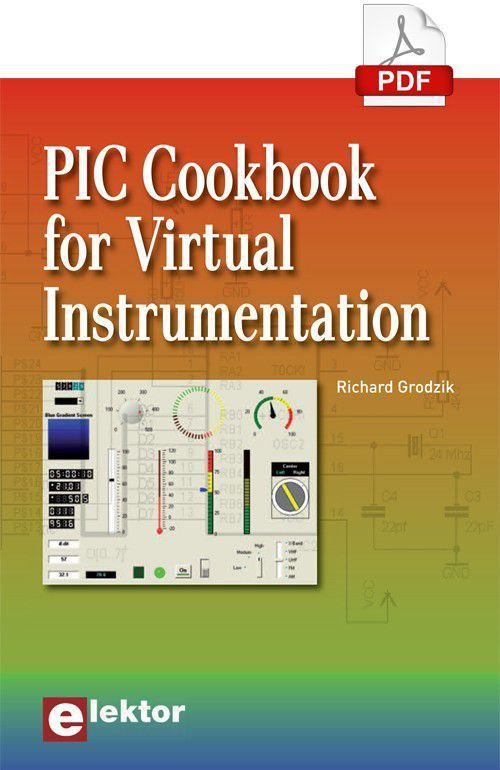
images/lc-meter/pic-cookbook.jpg
