rsenn/lc-meter/images/lc-meter/Schaltplan-LCM-V2-klein.jpg

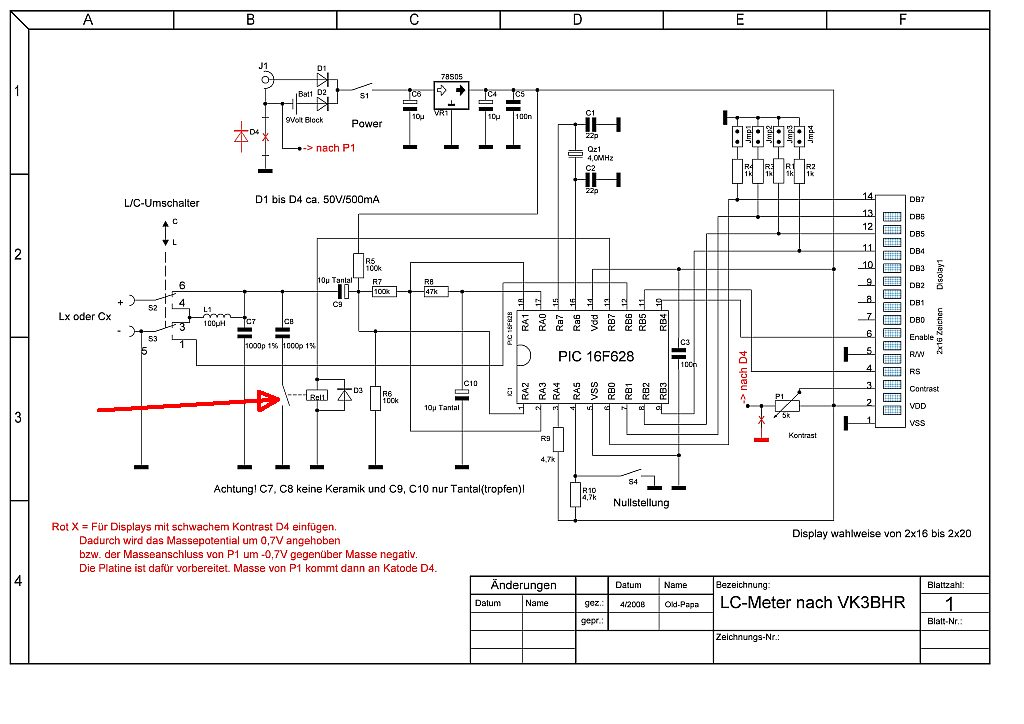
images/lc-meter/Schaltplan-LCM-V2-klein.jpg
