rsenn/lc-meter/images/lc-meter/Very-Accurate-LC-Meter-based-on-PIC16F628A-schematich-150x150.jpg

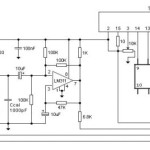
images/lc-meter/Very-Accurate-LC-Meter-based-on-PIC16F628A-schematich-150x150.jpg
