rsenn/lc-meter/images/LC-PANELG.gif

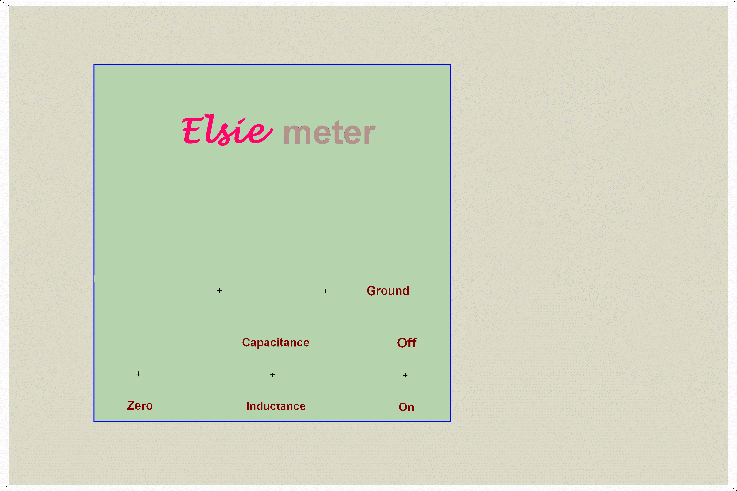
images/LC-PANELG.gif
