rsenn/lc-meter/images/LC-PCB2.bmp

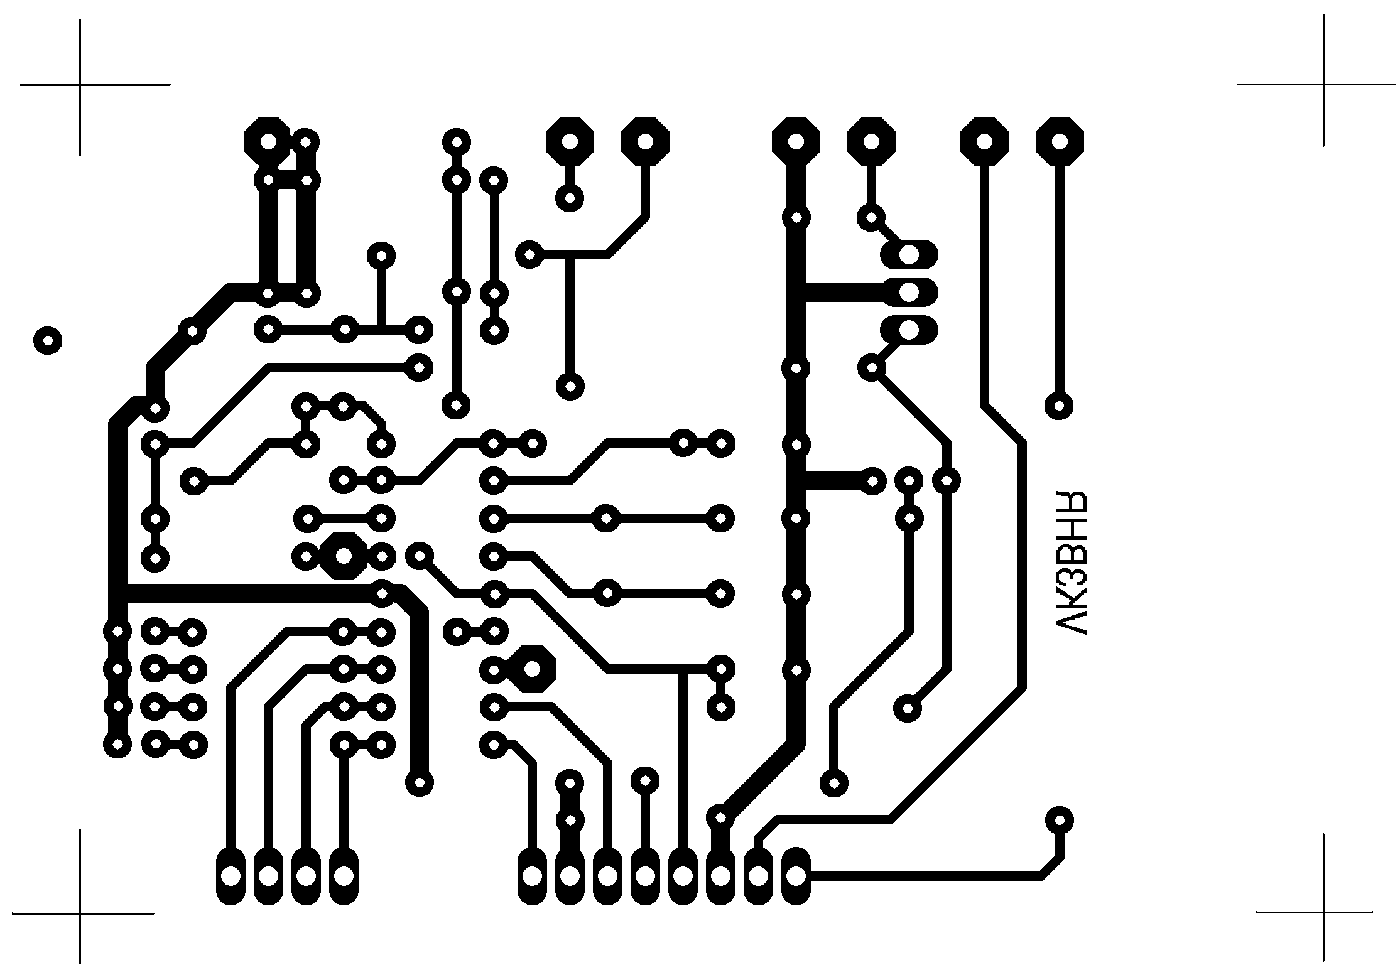
images/LC-PCB2.bmp
