rsenn/lc-meter/images/lcmetre.JPG

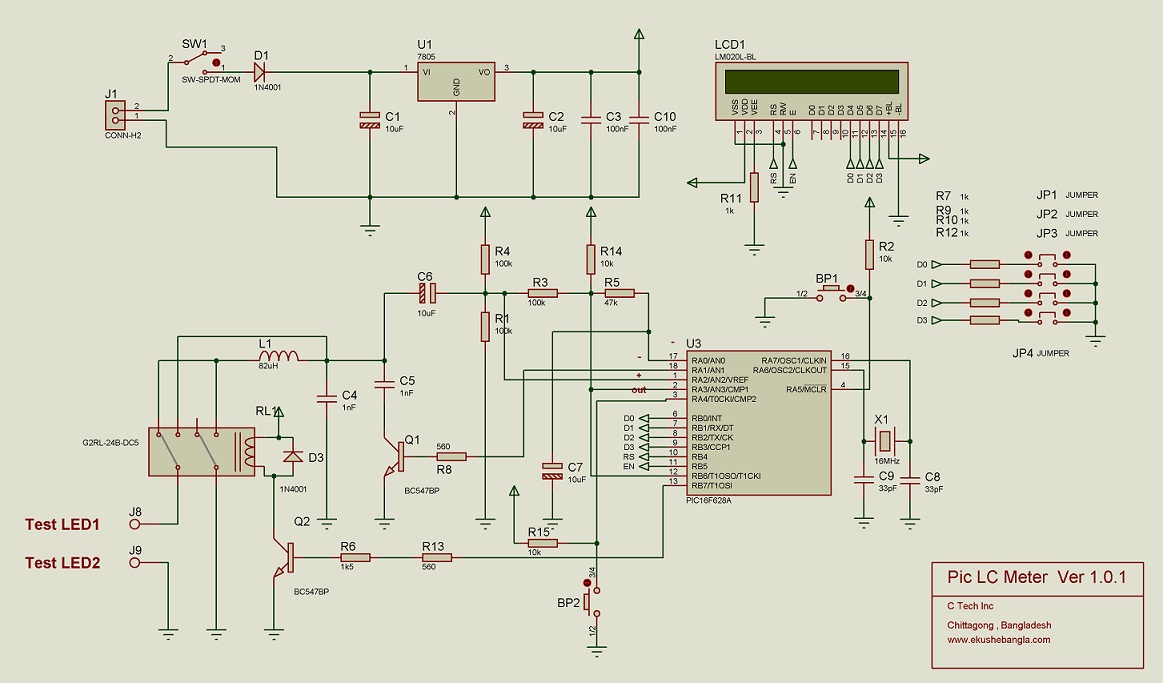
images/lcmetre.JPG
