rsenn/lc-meter/images/photos/DSC03265.png

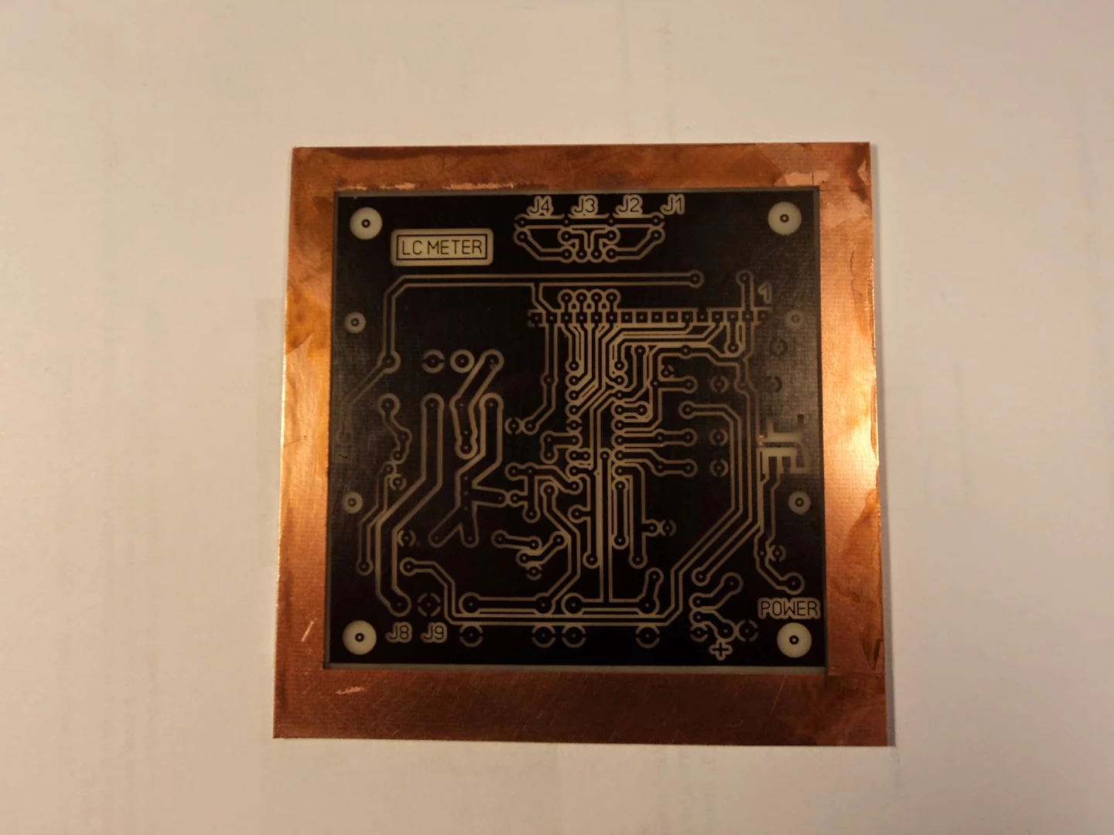
images/photos/DSC03265.png
