rsenn/lc-meter/images/photos/DSC03266.png

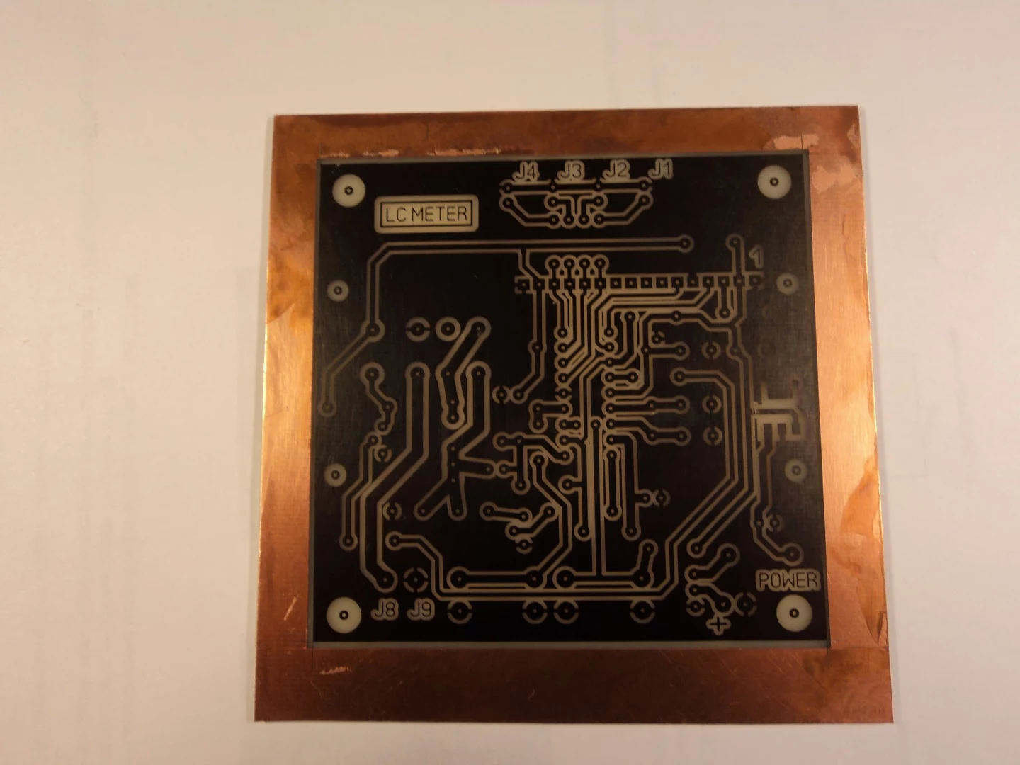
images/photos/DSC03266.png
