rsenn/lc-meter/images/photos/DSC03267.png

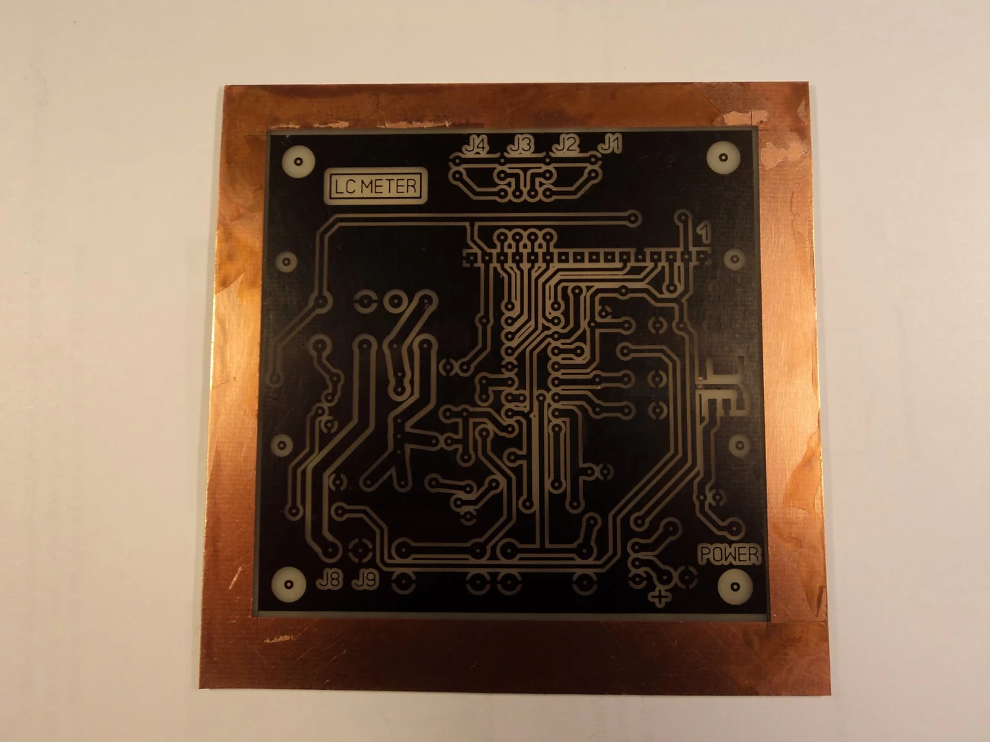
images/photos/DSC03267.png
