rsenn/lc-meter/images/photos/DSC03268.png

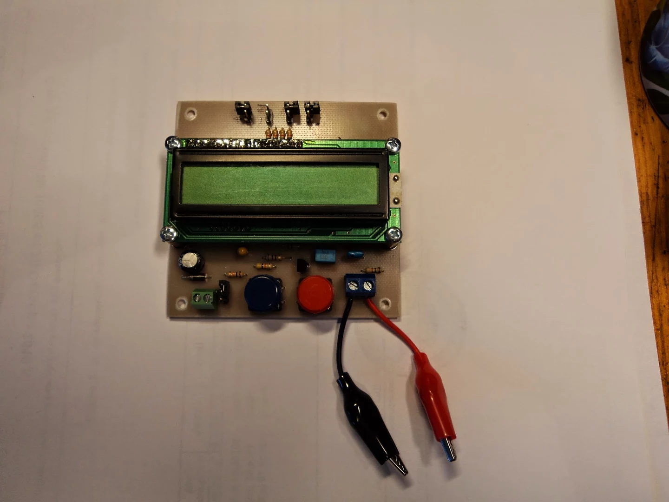
images/photos/DSC03268.png
