rsenn/lc-meter/images/photos/DSC03270.png

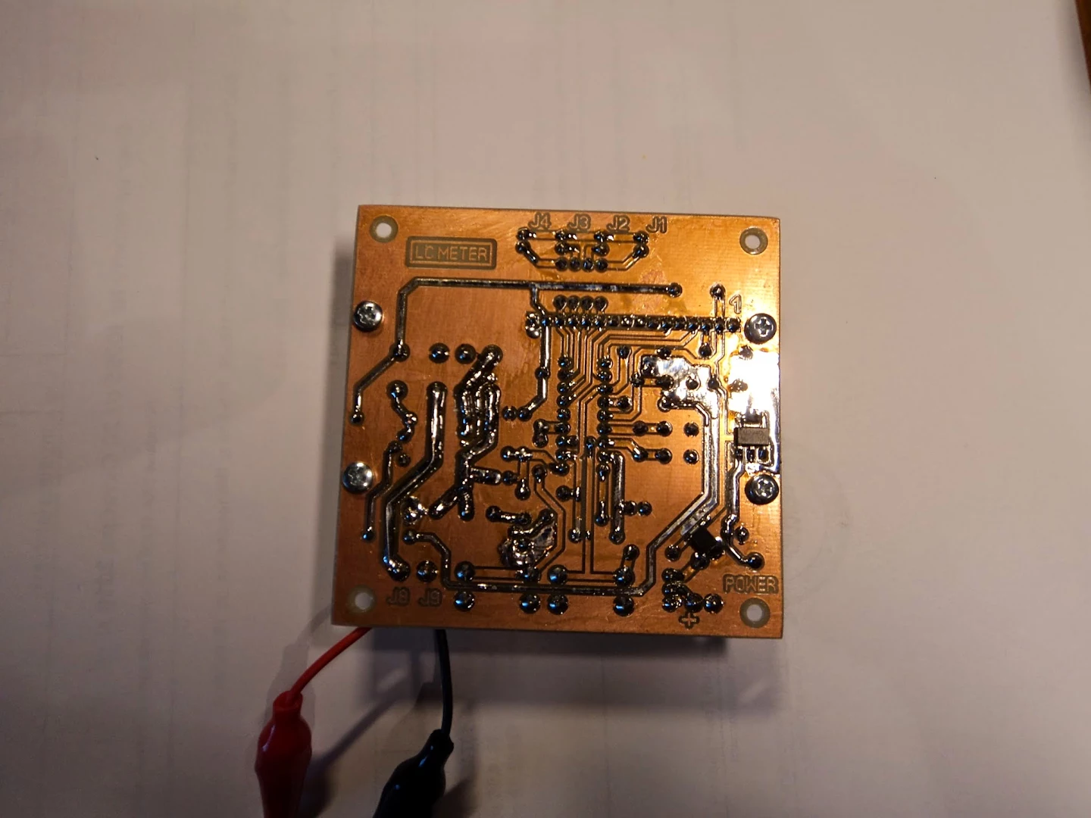
images/photos/DSC03270.png
