rsenn/lc-meter/images/photos/DSC03272.png

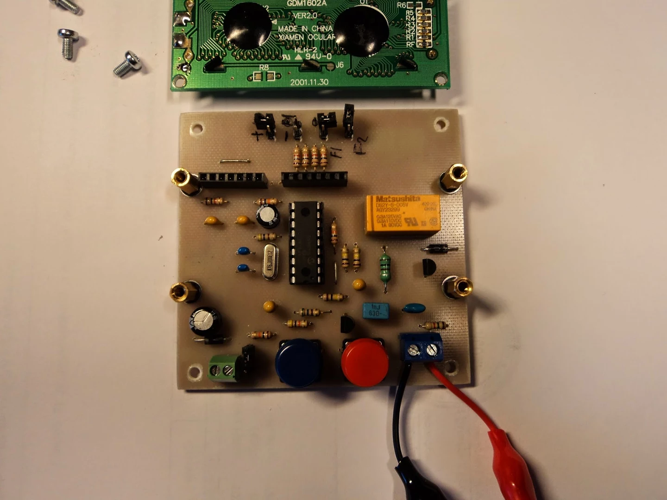
images/photos/DSC03272.png
