rsenn/lc-meter/images/photos/DSC03273.png

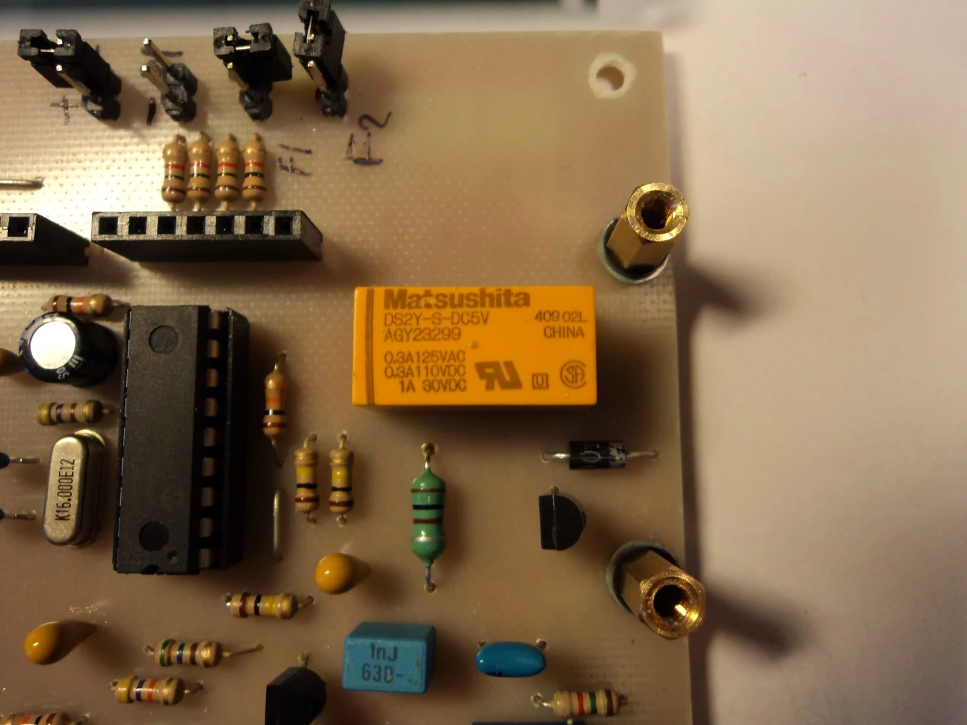
images/photos/DSC03273.png
