rsenn/lc-meter/images/photos/DSC03274.png

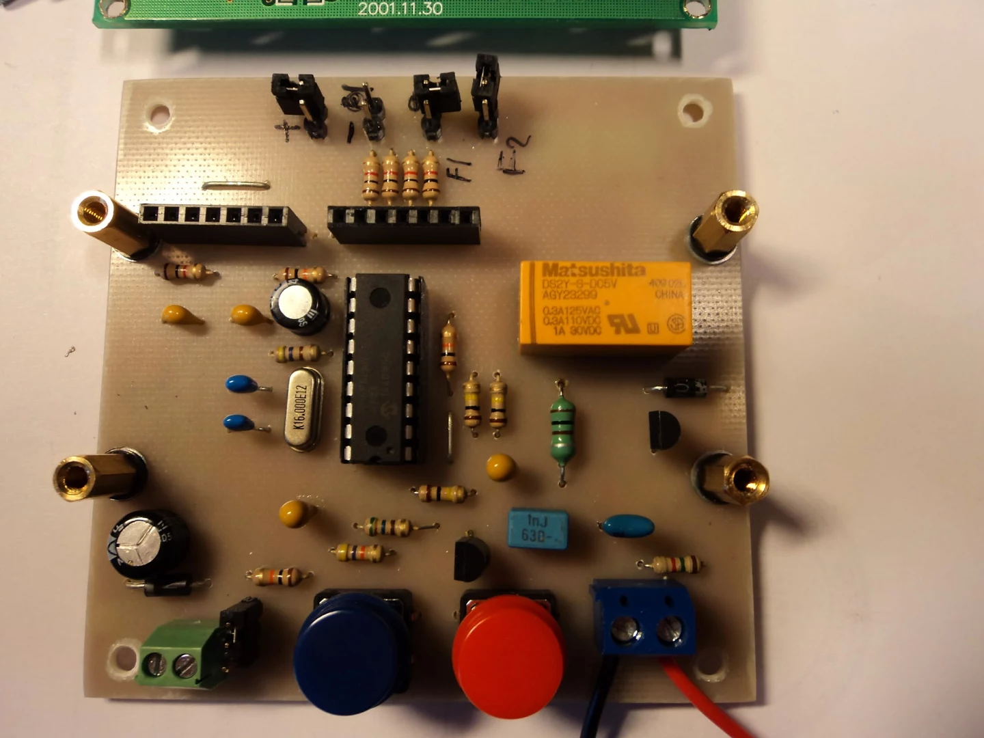
images/photos/DSC03274.png
