rsenn/lc-meter/images/photos/DSC03276.png

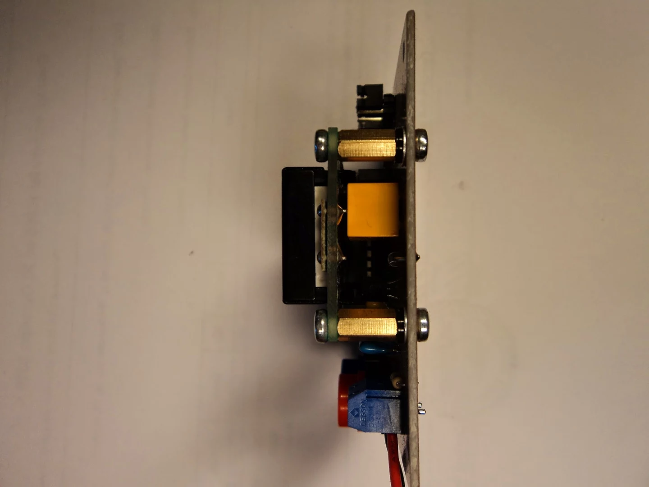
images/photos/DSC03276.png
