rsenn/lc-meter/images/photos/DSC03277.png

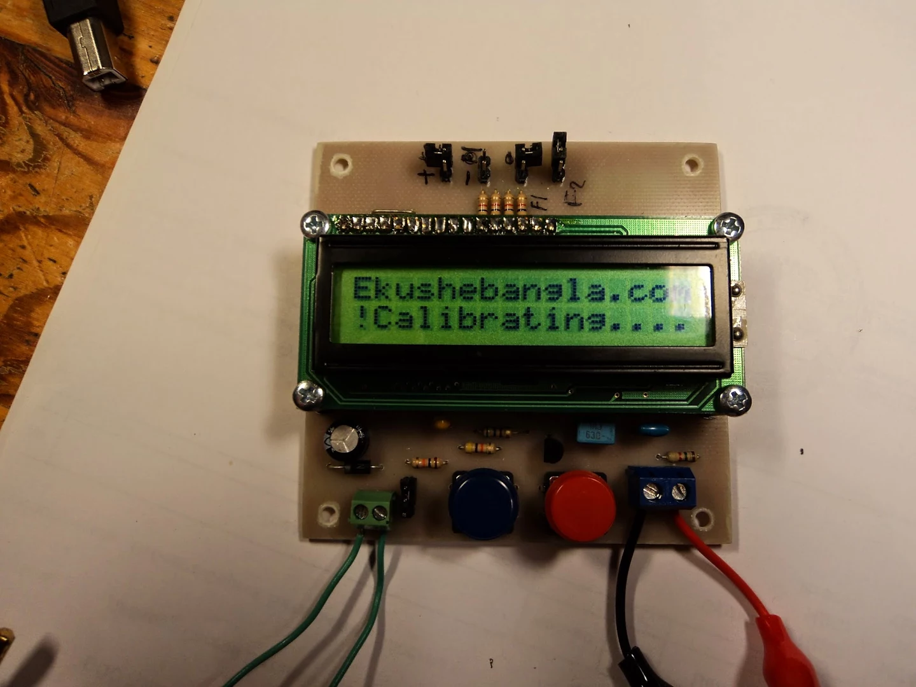
images/photos/DSC03277.png
