rsenn/lc-meter/images/photos/DSC03278.png

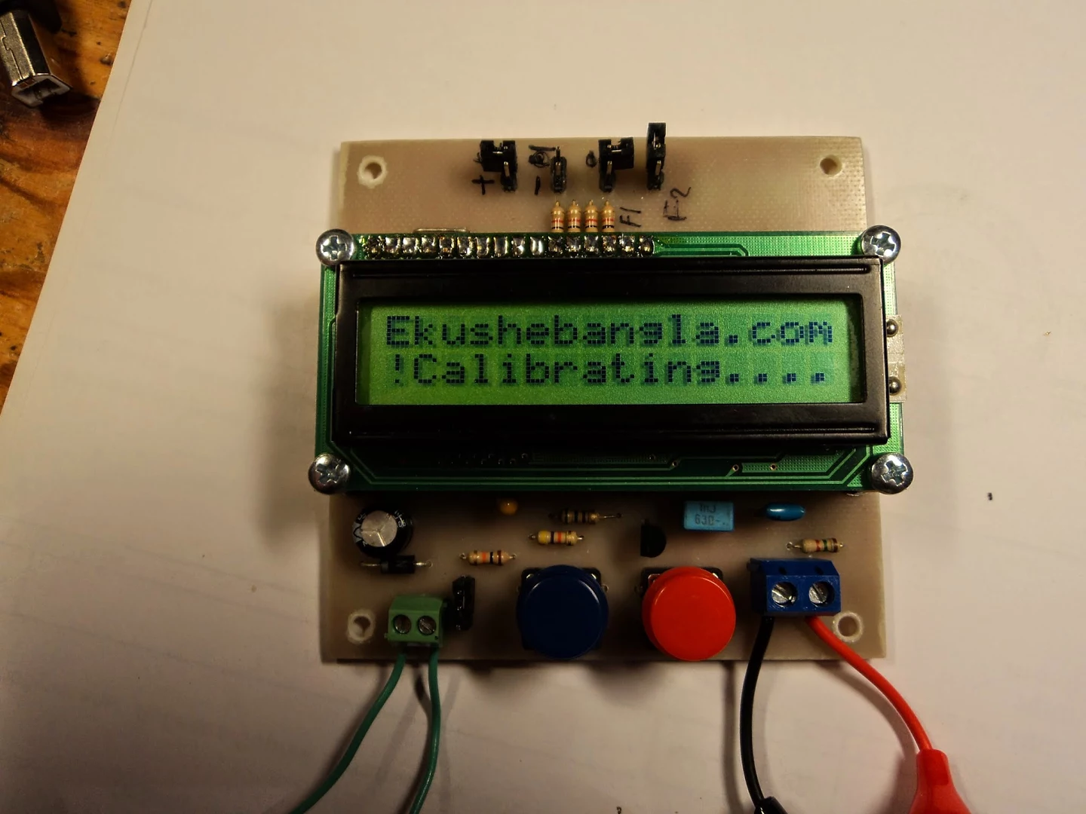
images/photos/DSC03278.png
