rsenn/lc-meter/images/photos/DSC03279.png

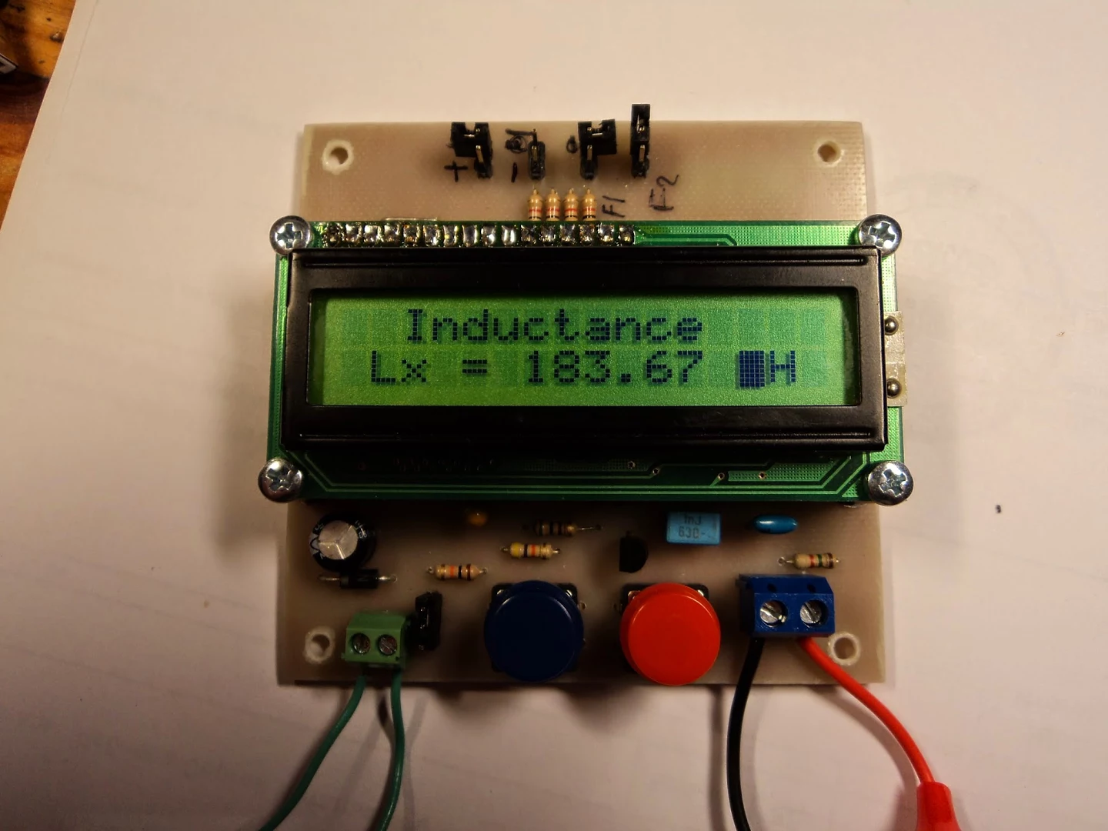
images/photos/DSC03279.png
