rsenn/lc-meter/images/photos/DSC03280.png

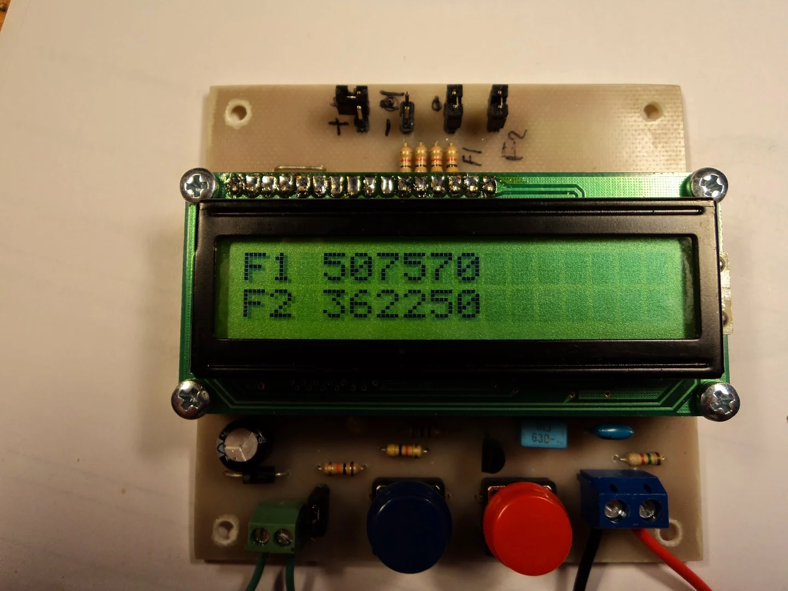
images/photos/DSC03280.png
