rsenn/lc-meter/images/photos/DSC03281.png

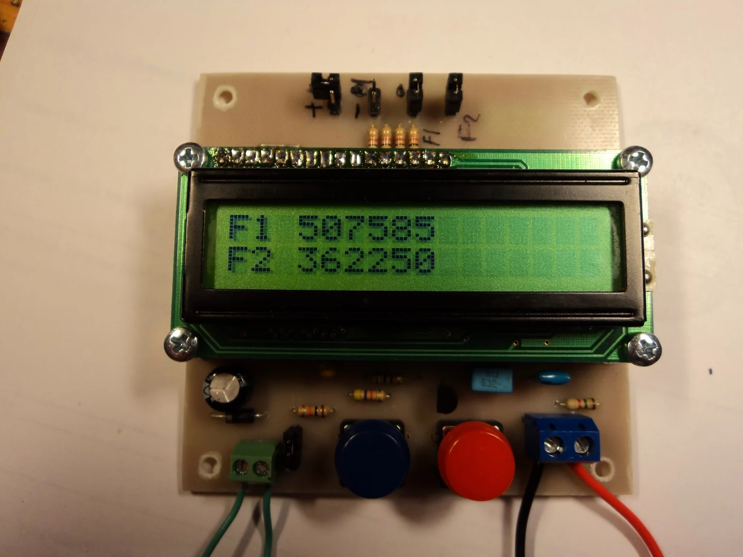
images/photos/DSC03281.png
