rsenn/lc-meter/images/photos/DSC03282.png

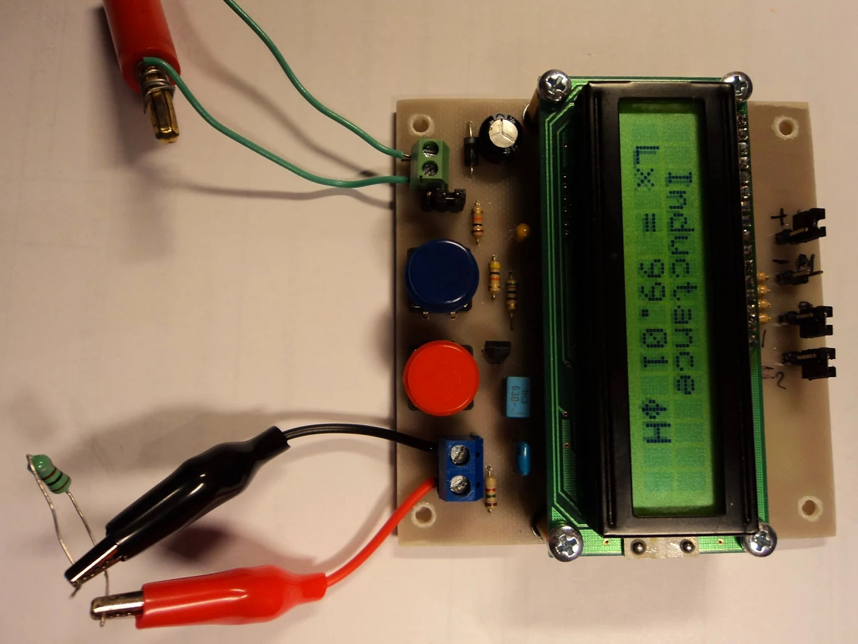
images/photos/DSC03282.png
