rsenn/lc-meter/images/photos/DSC03283.png

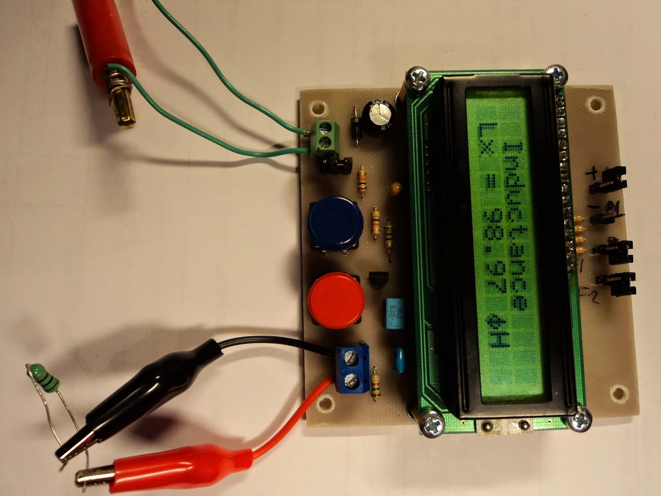
images/photos/DSC03283.png
