rsenn/lc-meter/images/photos/DSC03284.png

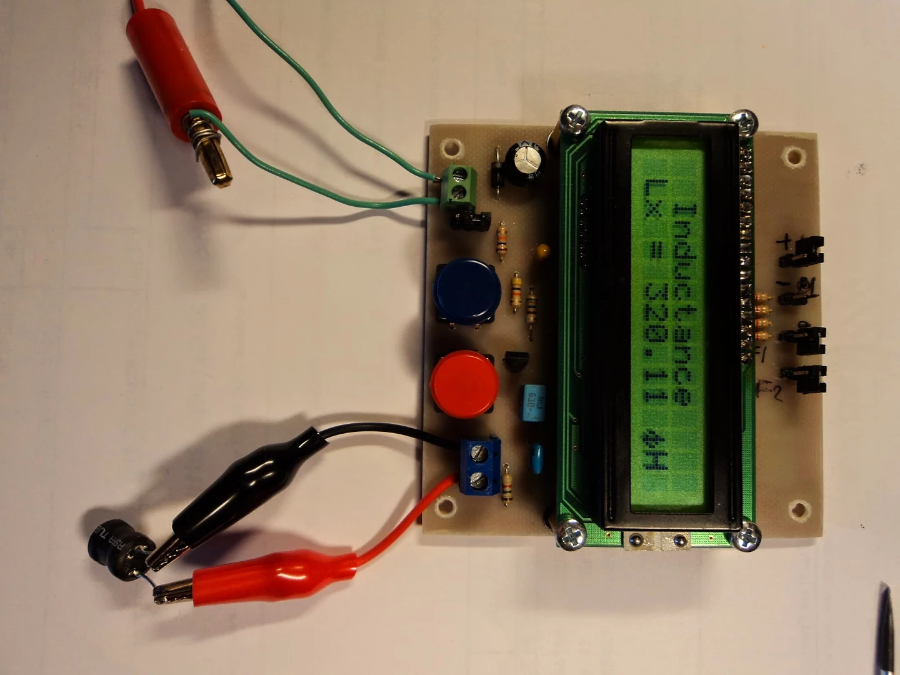
images/photos/DSC03284.png
