rsenn/lc-meter/images/photos/DSC03285.png

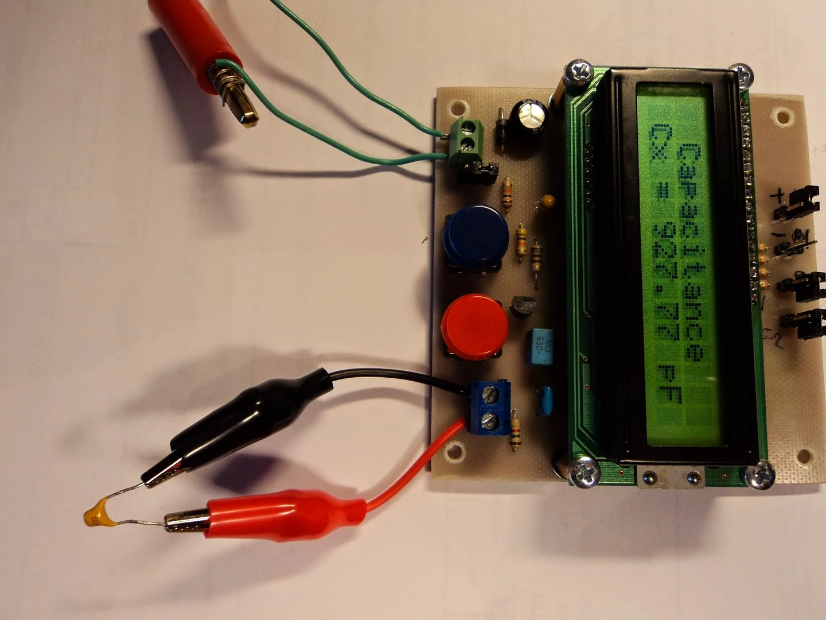
images/photos/DSC03285.png
