rsenn/lc-meter/images/photos/DSC03286.png

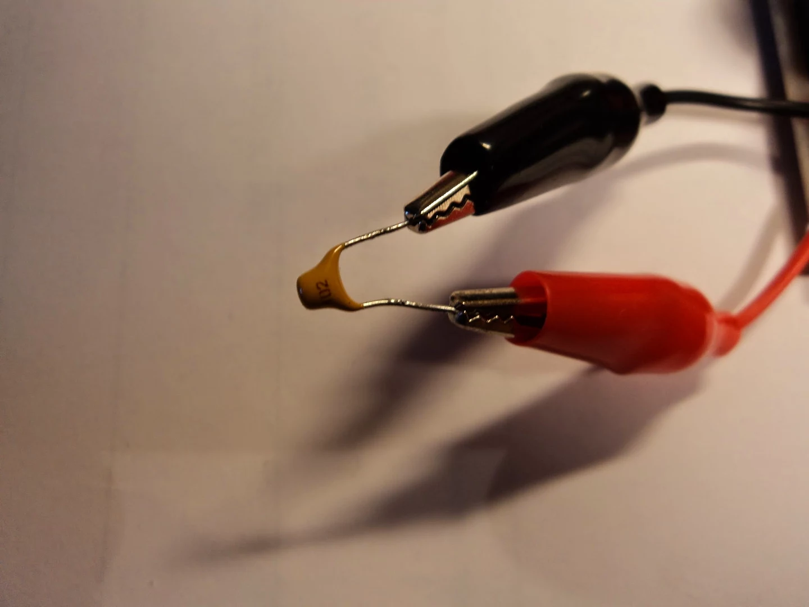
images/photos/DSC03286.png
