rsenn/lc-meter/images/photos/DSC03287.png

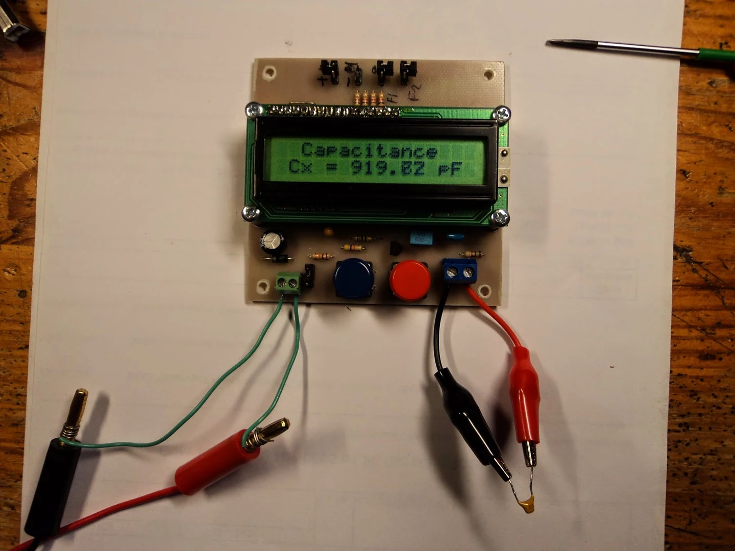
images/photos/DSC03287.png
