rsenn/lc-meter/images/photos/DSC03288.png

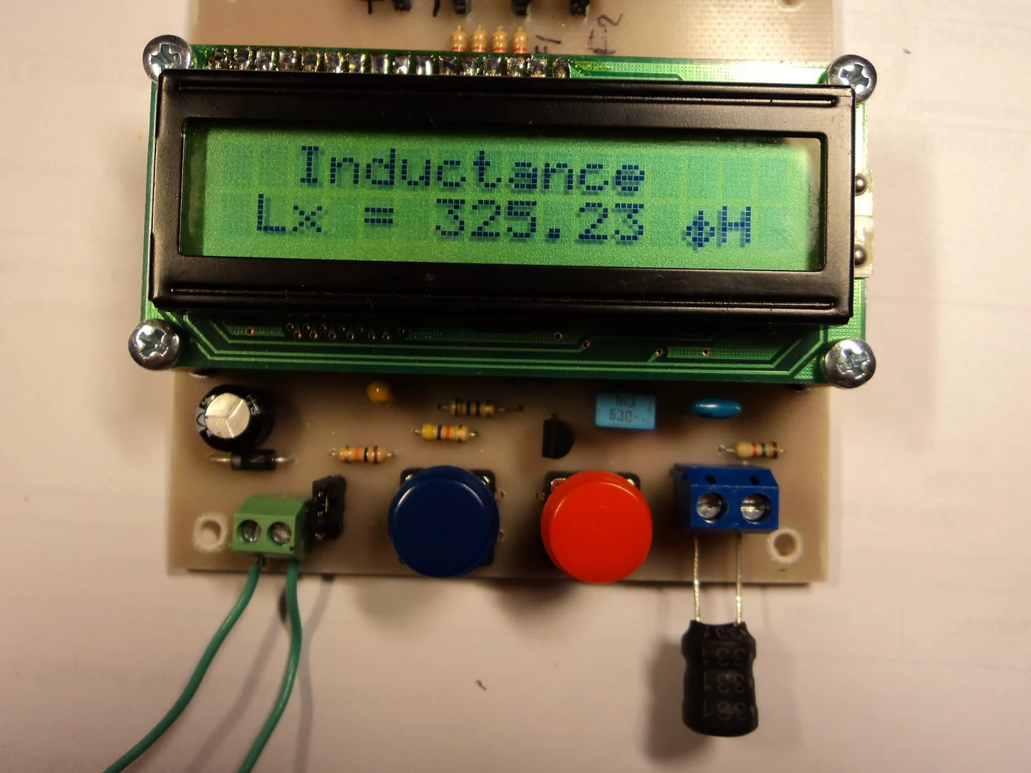
images/photos/DSC03288.png
