rsenn/lc-meter/images/photos/DSC03289.png

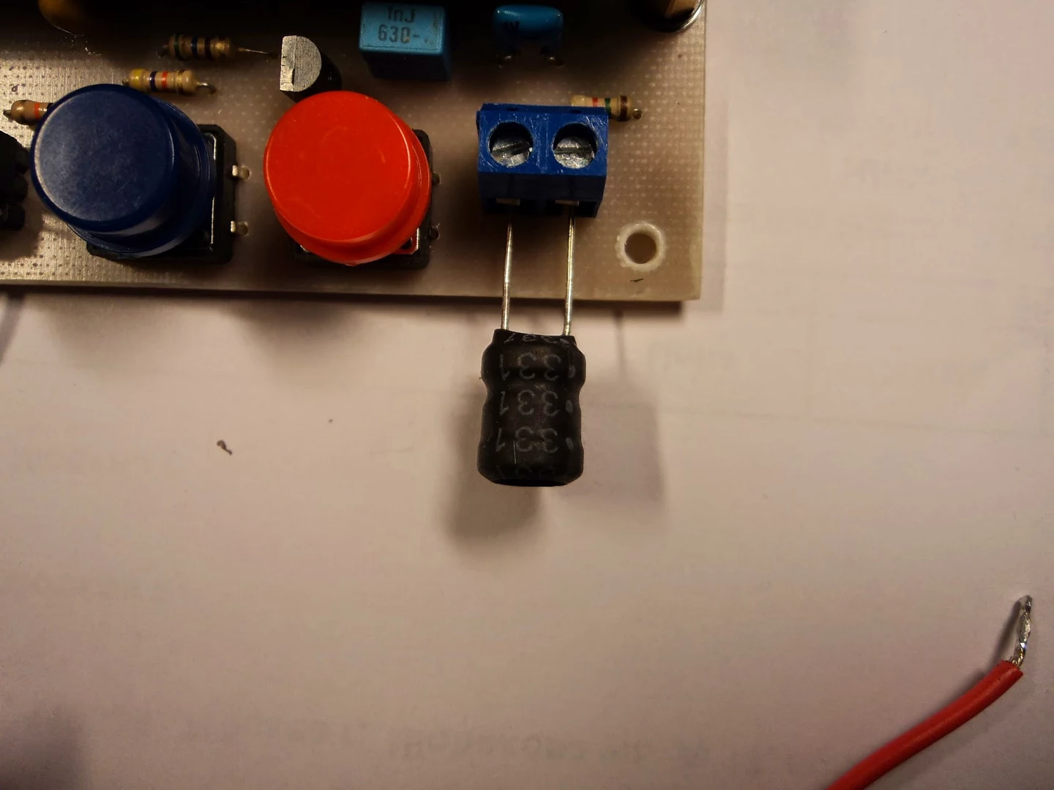
images/photos/DSC03289.png
