rsenn/lc-meter/images/photos/DSC03290.png

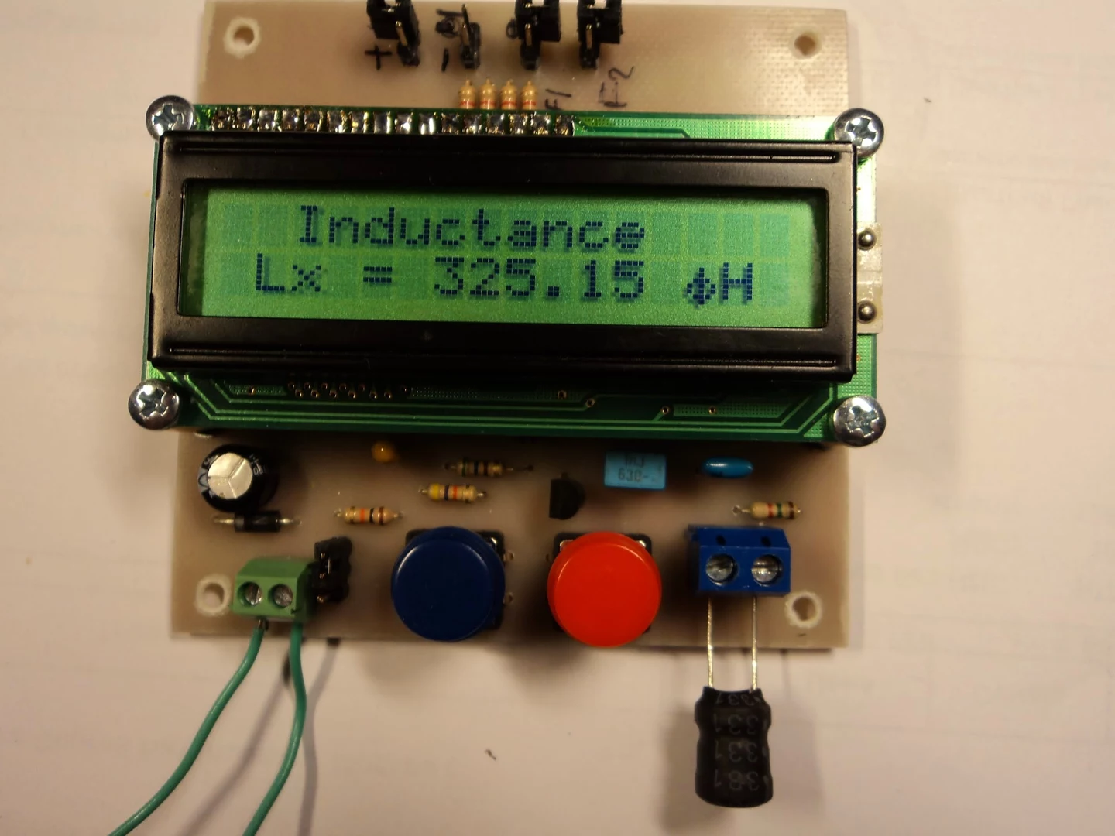
images/photos/DSC03290.png
