rsenn/lc-meter/images/photos/IMG_0965.JPG

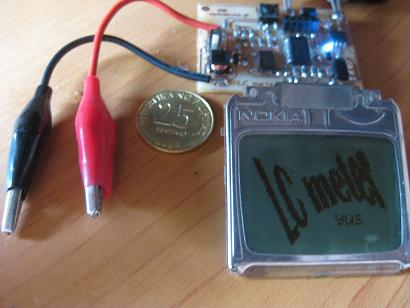
images/photos/IMG_0965.JPG
