rsenn/lc-meter/images/photos/IMG_0974.JPG

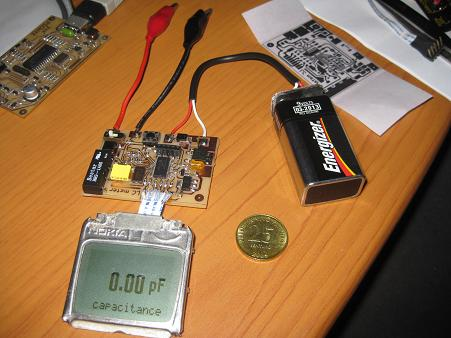
images/photos/IMG_0974.JPG
