rsenn/lc-meter/images/photos/IMG_0979.JPG

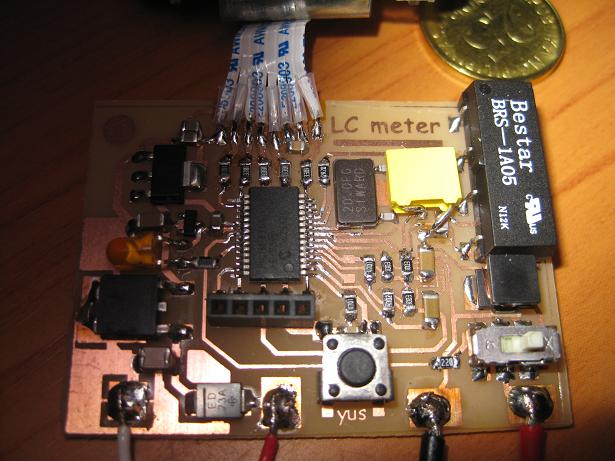
images/photos/IMG_0979.JPG
