rsenn/lc-meter/src/PIC18F2550_USB-HID_LC-Meter/lcmeter_screenshot.PNG

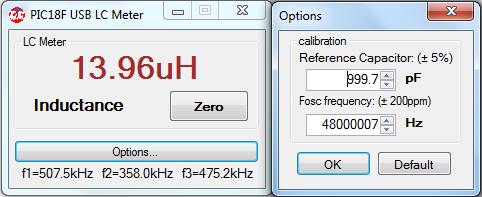
src/PIC18F2550_USB-HID_LC-Meter/lcmeter_screenshot.PNG
