rsenn/lc-meter/doc/pdf/LCmeter0-LCD-mounted-PIC-COMP-schematic.pdf

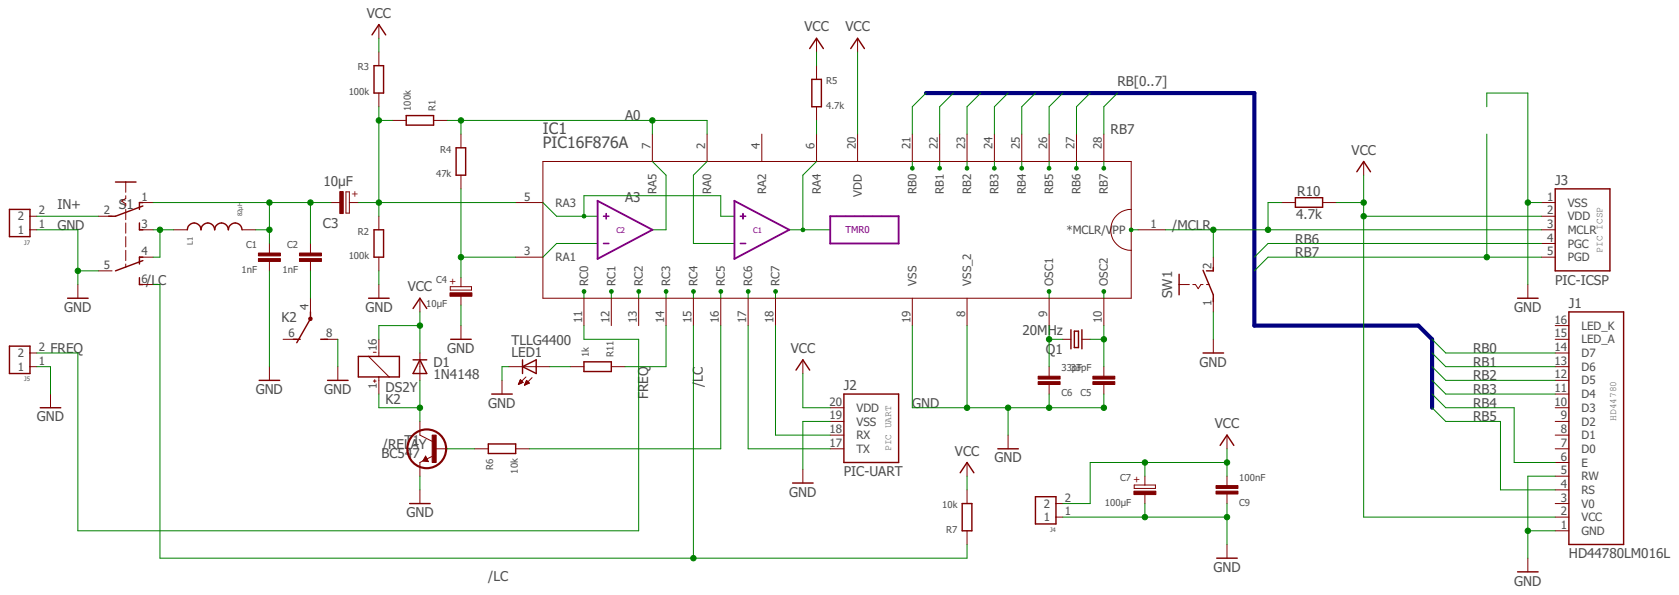
[picture p108: page 1]

PIC ICSP PIC UART HD44780 100k 100k 100k 47k 4.7k 1nF 1nF 10μF 10μF 333p3FpF 100μF 100nF GND GND GND GND 1N4148 82μH 20MHz VCC VCC GND 4.7k VCC GND DS2Y VCC BC547GND VCC GND 10k PIC-ICSP TLLG4400 GND GND PIC-UART GND VCC VCC VCC PIC16F876A 10k 1k GND GND HD44780LM016L GND R1 R2R3 R4 R10 C1 C2 C3 C4 C6 C5 C7 C9 D1 L1 Q1 R5 K2 16 1 T1 K26 8 4 2 31 5 64 S1 R7 VDD 2 VSS 1 PGC 4 PGD 5 J3MCLR 3 LED1 2 2 1 1 J4 VDD 20 VSS 19 RX 18 TX 17 J2 SW1 1 2 *MCLR/VPP 1 OSC1 9 OSC2 10 RA0 2 RA1 3 RA3 5 RA4 6 RA5 7 RB0 21 RB2 23 RB3 24 RB4 25 RB5 26 RB6 27 VDD 20 VSS 19 VSS_2 8 IC1 RC0 11 RB7 28 RC1 12 RC2 13 RC3 14 RC4 15 RC5 16 RB1 22 RC6 17 RC7 18 RA2 4 R6 R11 2 2 1 1 J7 2 2 1 1 J5 D5 12 D4 11 RS 4 GND 1 J1E 6 VCC 2 D6 13 D7 14 RW 5 V0 3 D0 7 D1 8 D2 9 D3 10 LED_A 15 LED_K 16 RB[0..7] A3A0 GND GND /LC /LC /LC /RELAY /MCLR IN+ FREQ FREQRB2 RB3 RB4 RB5 RB6 RB7 RB7 RB0 RB1 + + + C2 C1 TMR0
