rsenn/lc-meter/doc/pdf/LCMeter-LCD4BitDirect-18F2550-CMP-NoRelay-schematic.pdf

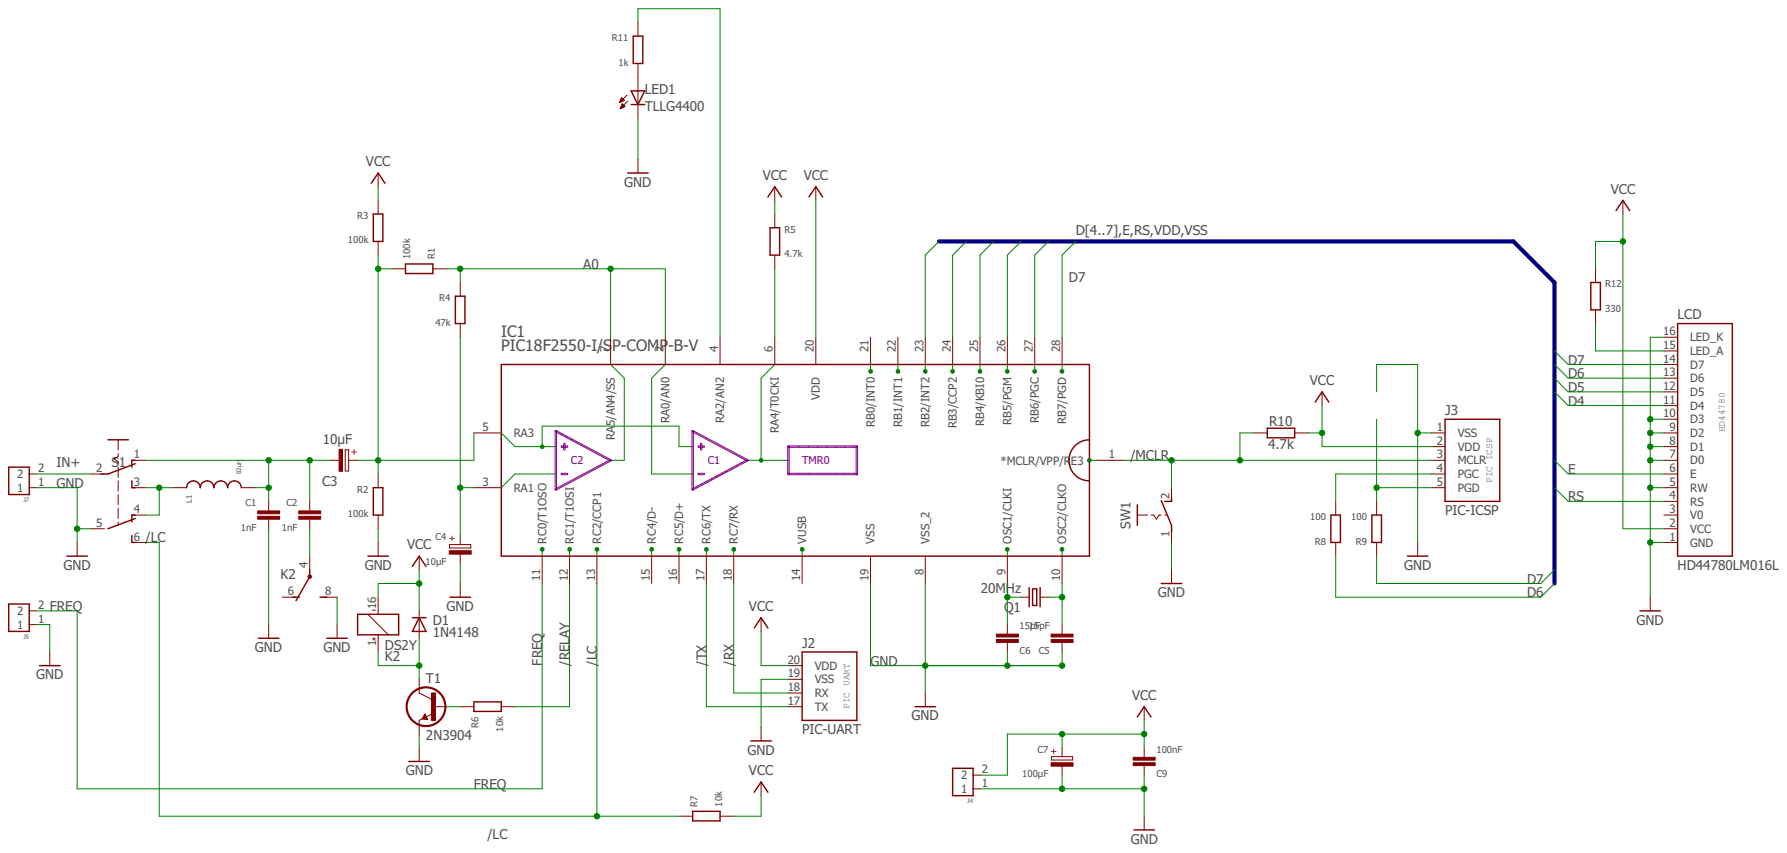
[picture p109: page 1]

PIC ICSP PIC UART HD44780 100k 100k 100k 47k 4.7k 1nF 1nF 10μF 10μF 151p5FpF 100μF 100nF GND GND GND GND 1N4148 82μH 20MHz VCC VCC GND 4.7k VCC GND DS2Y VCC GND VCC GND 10k PIC-ICSP 100 100 TLLG4400 GND GND PIC-UART GND VCC VCC VCC 10k 1k GND GND PIC18F2550-I/SP-COMP-B-V HD44780LM016L GND VCC 330 2N3904 R1 R2R3 R4 R10 C1 C2 C3 C4 C6 C5 C7 C9 D1 L1 Q1 R5 K2 16 1 K26 8 4 2 31 5 64 S1 R7 VDD 2 VSS 1 PGC 4 PGD 5 J3MCLR 3 R8 R9 LED1 2 2 1 1 J4 VDD 20 VSS 19 RX 18 TX 17 J2 SW1 1 2 R6 R11 2 2 1 1 J7 2 2 1 1 J5 *MCLR/VPP/RE3 1 OSC1/CLKI 9 OSC2/CLKO 10 RA0/AN0 2 RA1 3 RA3 5 RA4/T0CKI 6 RA5/AN4/SS 7 RB0/INT0 21 RB2/INT2 23 RB3/CCP2 24 RB4/KBI0 25 RB5/PGM 26 RB6/PGC 27 VDD 20 VSS 19 VSS_2 8 IC1 RC0/T1OSO 11 RB7/PGD 28 RC1/T1OSI 12 RC2/CCP1 13 VUSB 14 RC4/D- 15 RC5/D+ 16 RB1/INT1 22 RC6/TX 17 RC7/RX 18 RA2/AN2 4 D5 12 D4 11 RS 4 GND 1 LCDE 6 VCC 2 D6 13 D7 14 RW 5 V0 3 D0 7 D1 8 D2 9 D3 10 LED_A 15 LED_K 16 R12 T1 D[4..7],E,RS,VDD,VSS A0 GND GND D4ERS /LC /LC /LC /MCLR D5D6 D6 D7 D7 D7 IN+ FREQ FREQ FREQ /RELAY /RX /TX + + + C2 C1 TMR0
