rsenn/lc-meter/images/LCMeter_v1.2.pdf

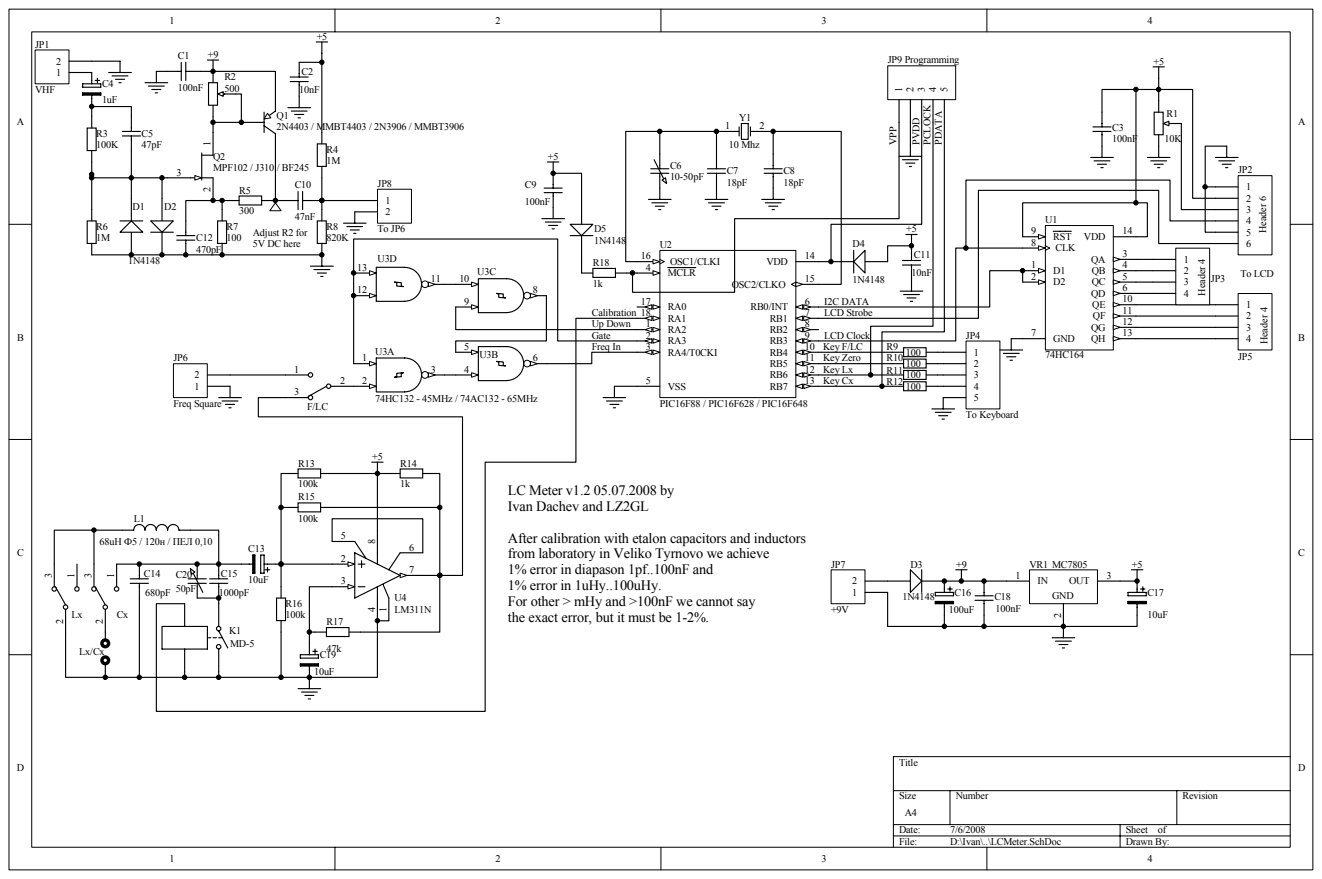
[picture p110: page 1]

+5 | JP9 Programming | +5

After calibration with etalon capacitors and inductors
from laboratory in Veliko Tyrnovo we achieve
1% error in diapason 1pf..100nF and
1% error in 1uHy..100uHy.
For other > mHy and >100nF we cannot say

Title

Size A4 | Number | | Revision

Date: 7/6/2008 | | Sheet of
File: D:\Ivan\..\LCMeter.SchDoc | | Drawn By:
