rsenn/lc-meter/doc/pdf/LCmeter0-LCD-mounted-PIC-COMP-board-mirrored.pdf

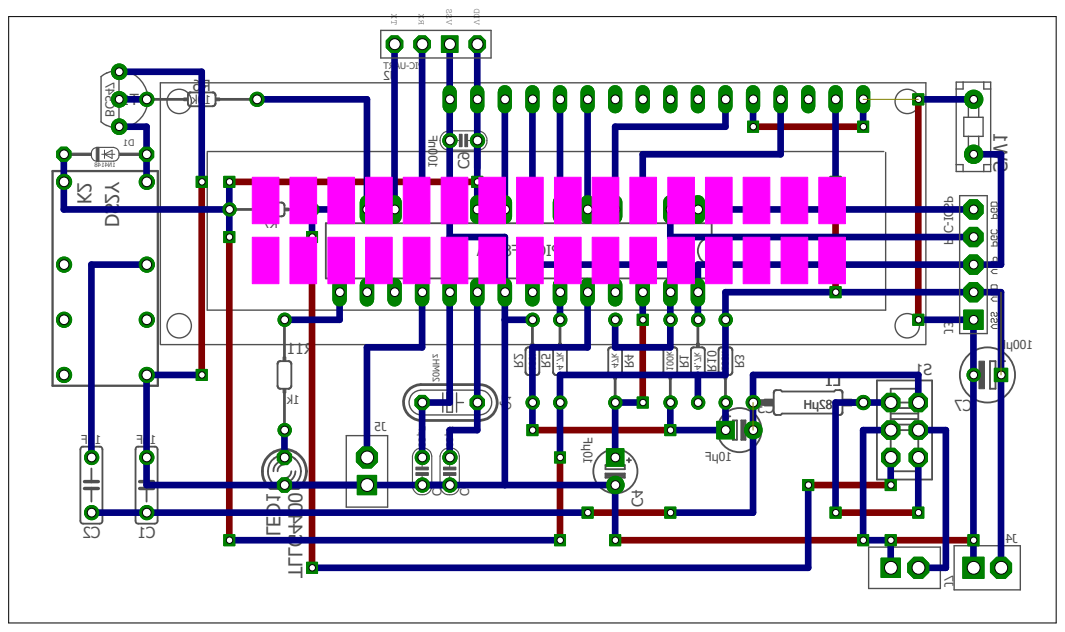
[picture p111: page 1]

Fn1 Fn1 1Fμ01 0μ33FpF 33pF Fμ001 100nF 8414N1 A678F61CI P TRAU- CI P PIC-ICSP DS2Y Hμ28 TLLG4400 20MHz 100k 4.7k k1 100k 100k 47k 4.7k k01 k01 BC547 2C 1C 3C CC45C6 7C C9 1D IC1 2J J3 4J 5J J7 K2 1L LED1 Q1 R1 R1 11R 0 R2R3R4R5 6R 7R 1S 1T TXRXVSS VDD SW1
