rsenn/lc-meter/doc/pdf/LCmeter0-LCD-mounted-PIC-COMP-board.pdf

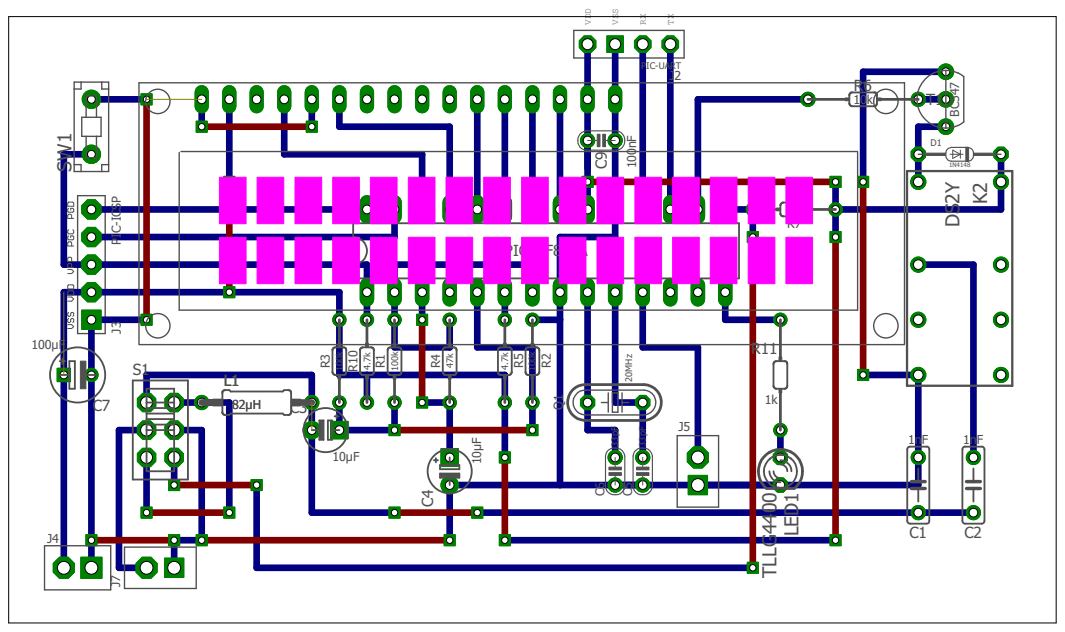
[picture p112: page 1]

TXRXVSS VDD SW1 C1 C2 C3 C4C5C6 C7 C9 D1 IC1 J2 J3 J4 J5 J7 K2 L1 LED1 Q1 R1 R10R11 R2R3R4R5 R6 R7 S1 T1 1nF 1nF 10μF 10μF33pF 33pF 100μF 100nF 1N4148 PIC16F876A PIC-UART PIC-ICSP DS2Y 82μH TLLG4400 20MHz 100k 4.7k 1k 100k 100k 47k 4.7k 10k 10k BC547
