rsenn/lc-meter/doc/pdf/LCmeter0-LCD-8pinlcd-PIC18F2550-COMP-board-mirrored.pdf

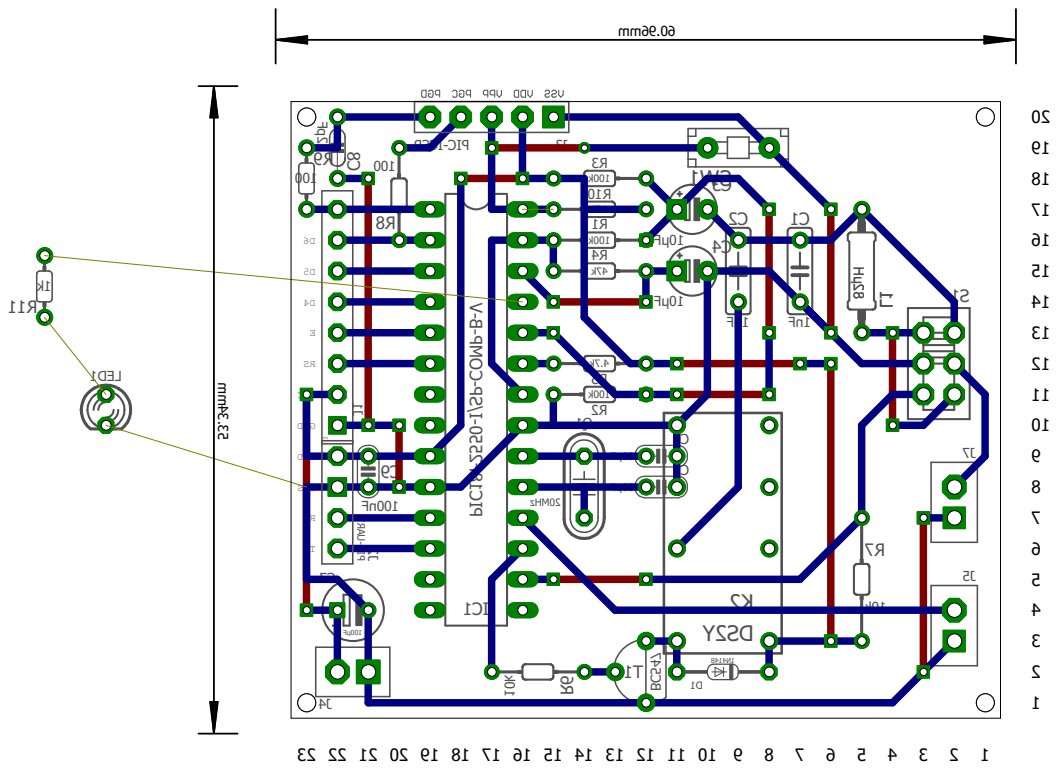
[picture p113: page 1]

Fn1 Fn1 Fμ01 Fμ01 Fp33 Fp33 Fμ001 Fn001 8414N1 82μH z HM02 k001 k7. 4 k001 k001 k74 k7. 4 Y2SD BC547 k01 PSCI- CI P 001 001 PIC-UART 10k k1 22pF PIC18F2550-I/SP-COMP-B-V 2C 1C 3C4C 5C6C 7C 9C 1D L1 1 Q1R 01R 2R3R4R5R 2K 1T 1S 7R 3J 8R 9R J1 1DEL 4J J2 R6 11R 7J5J C8 1CI DNG CCVSRE4D5D6D7DXTXR SSV DDV 1 WS 1234567890111213141516171819102 32 22 12 02 91 81 71 61 51 41 31 21 11 01 9 8 7 6 5 4 3 2 1 53.34mm mm69. 06 1
