rsenn/lc-meter/doc/pdf/CapMeter-LCD-16F628A-schematic.pdf

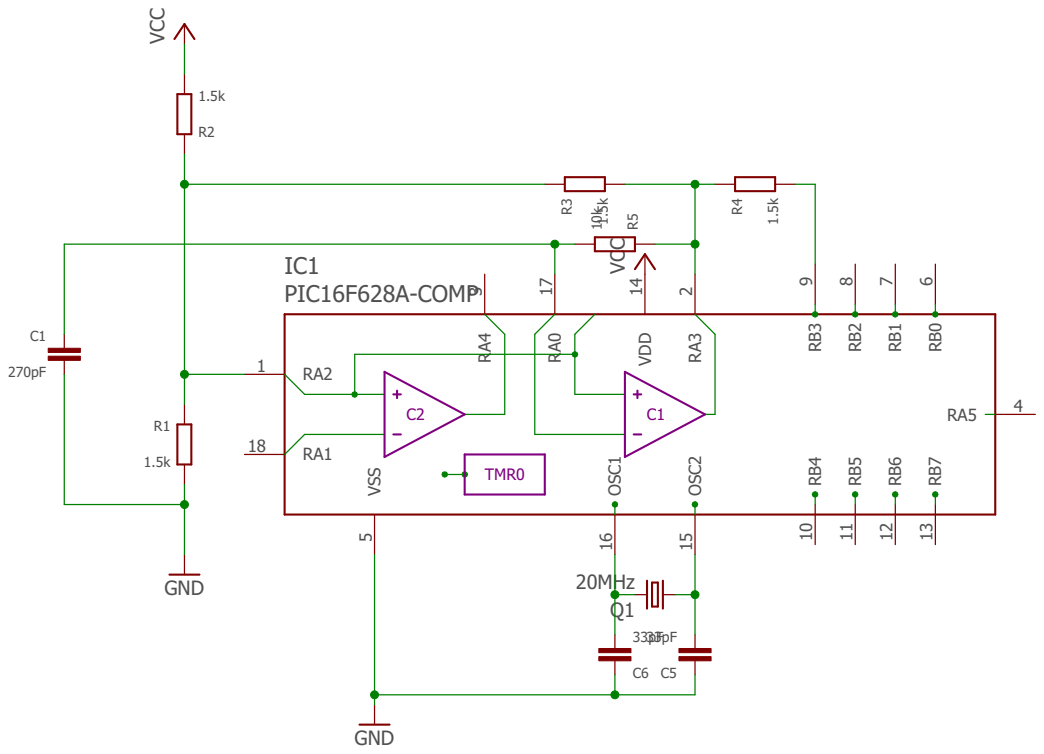
[picture p114: page 1]
