rsenn/lc-meter/doc/pdf/CapMeter-LCD-16F876A-schematic.pdf

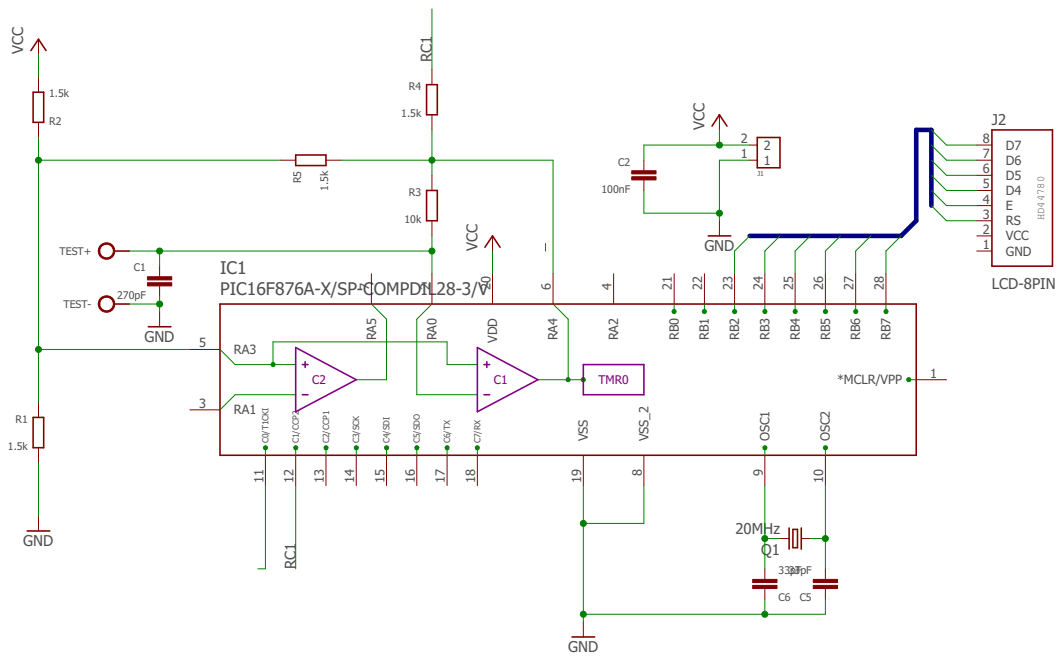
[picture p115: page 1]
