rsenn/lc-meter/doc/pdf/LCMeter-LCD4Bit-18F2550-CMP-schematic.pdf

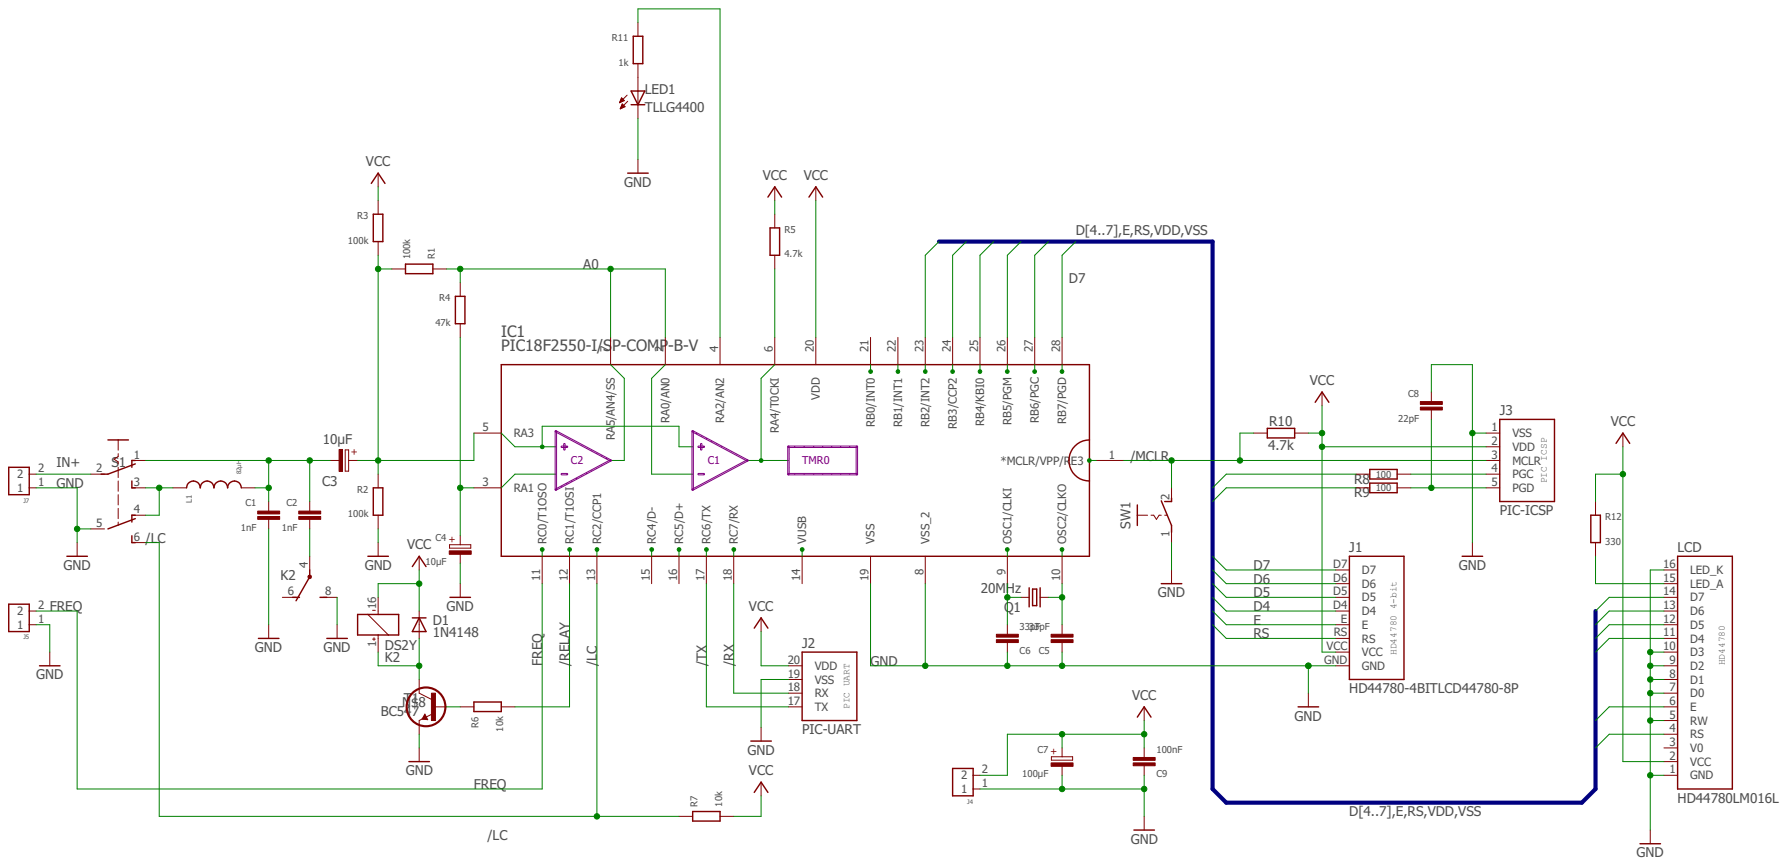
[picture p116: page 1]
