rsenn/lc-meter/doc/pdf/LCmeter0-LCD-8pinlcd-PIC18F2550-COMP-schematic.pdf

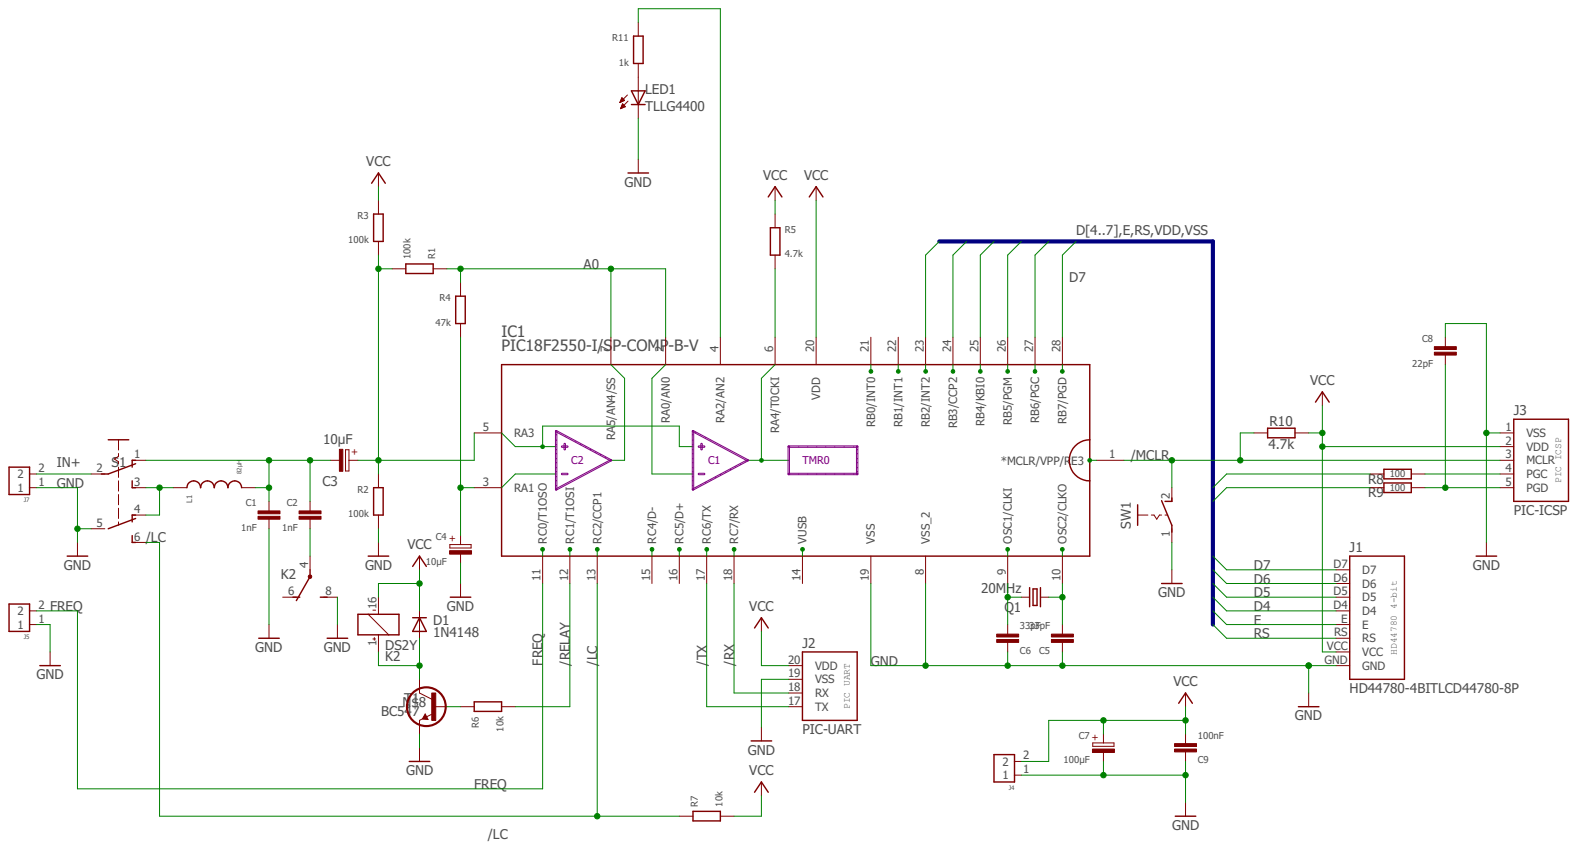
[picture p117: page 1]
