rsenn/lc-meter/doc/pdf/PIC18F2550-USB-HID-LC-Meter-schematic.pdf

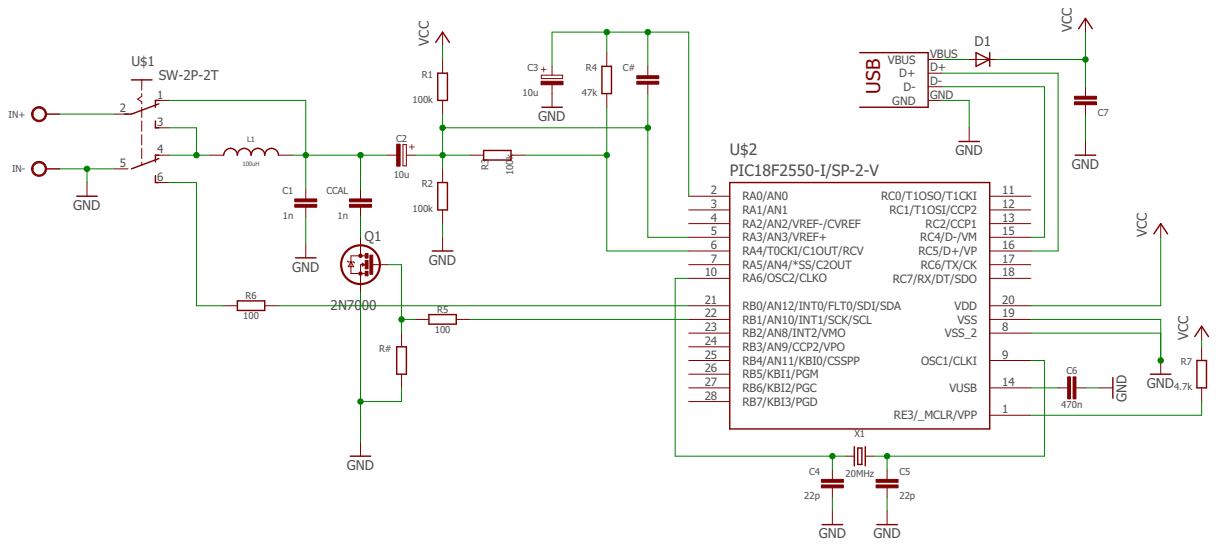
[picture p118: page 1]
