rsenn/lc-meter/doc/LCmeter0-LCD-8pinlcd-PIC_COMP.pdf

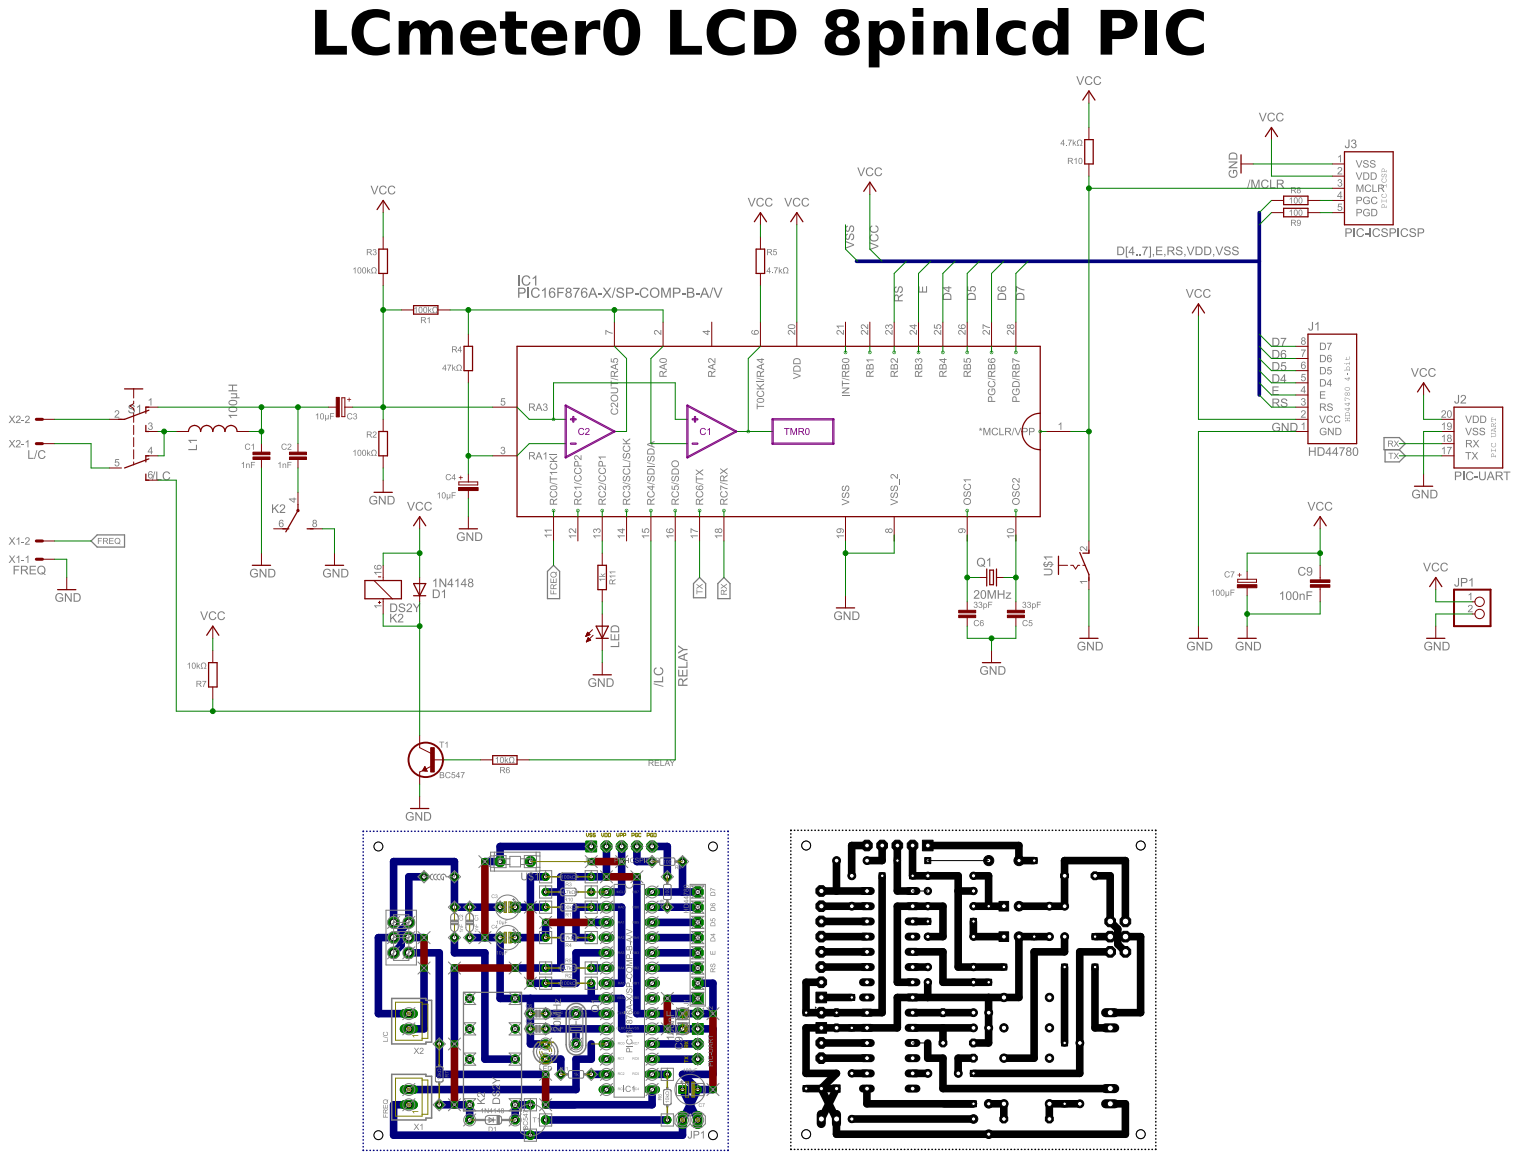
[picture p119: page 1]
