rsenn/lc-meter/images/LCMx1.pdf

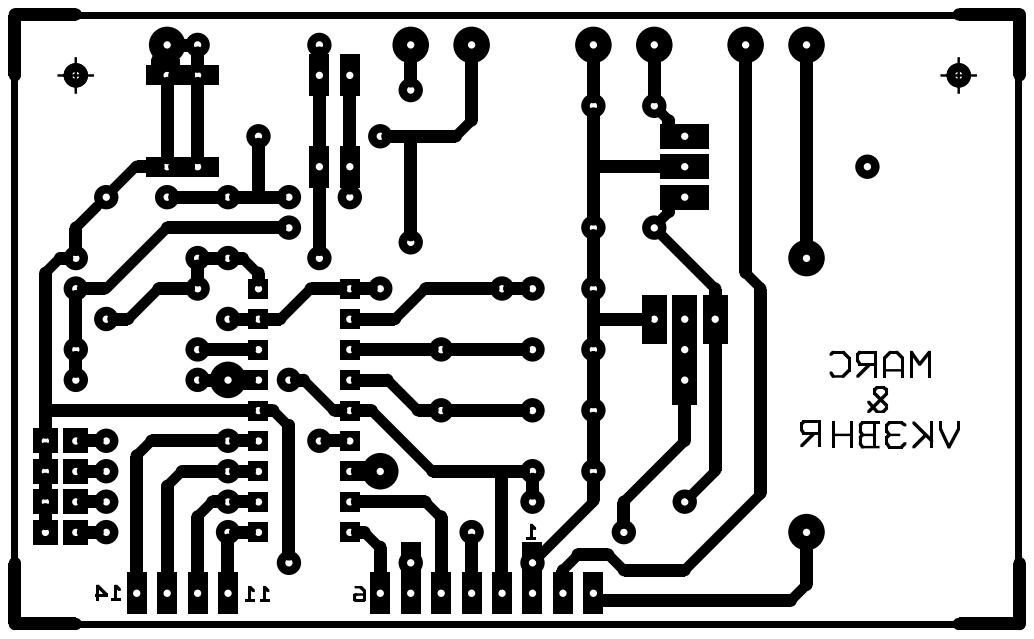
[picture p120: page 1]
