rsenn/lc-meter/doc/LCmeter876a-relais.pdf

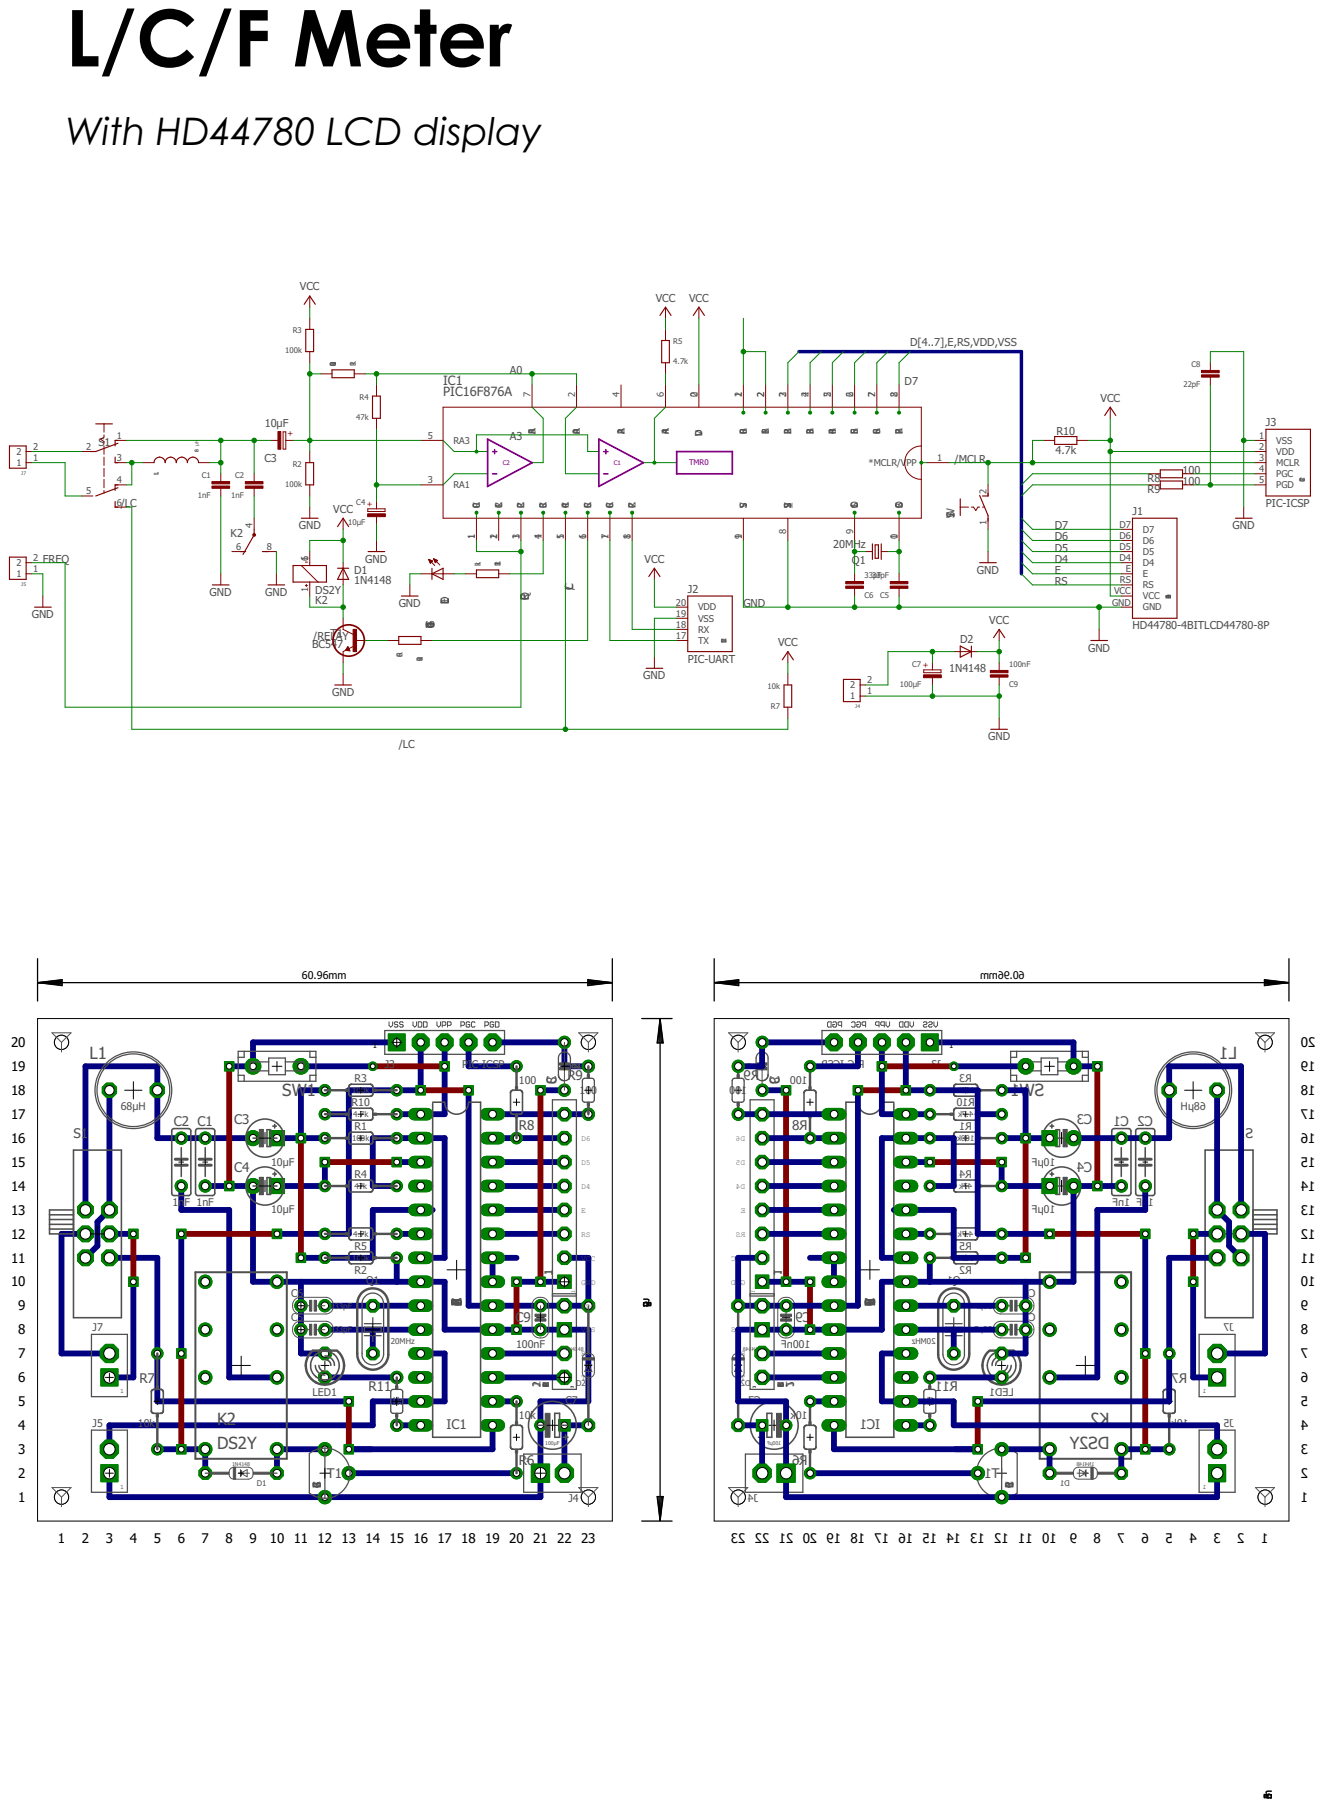
[picture p121: page 1]
