rsenn/lc-meter/images/LCmeter0.pdf

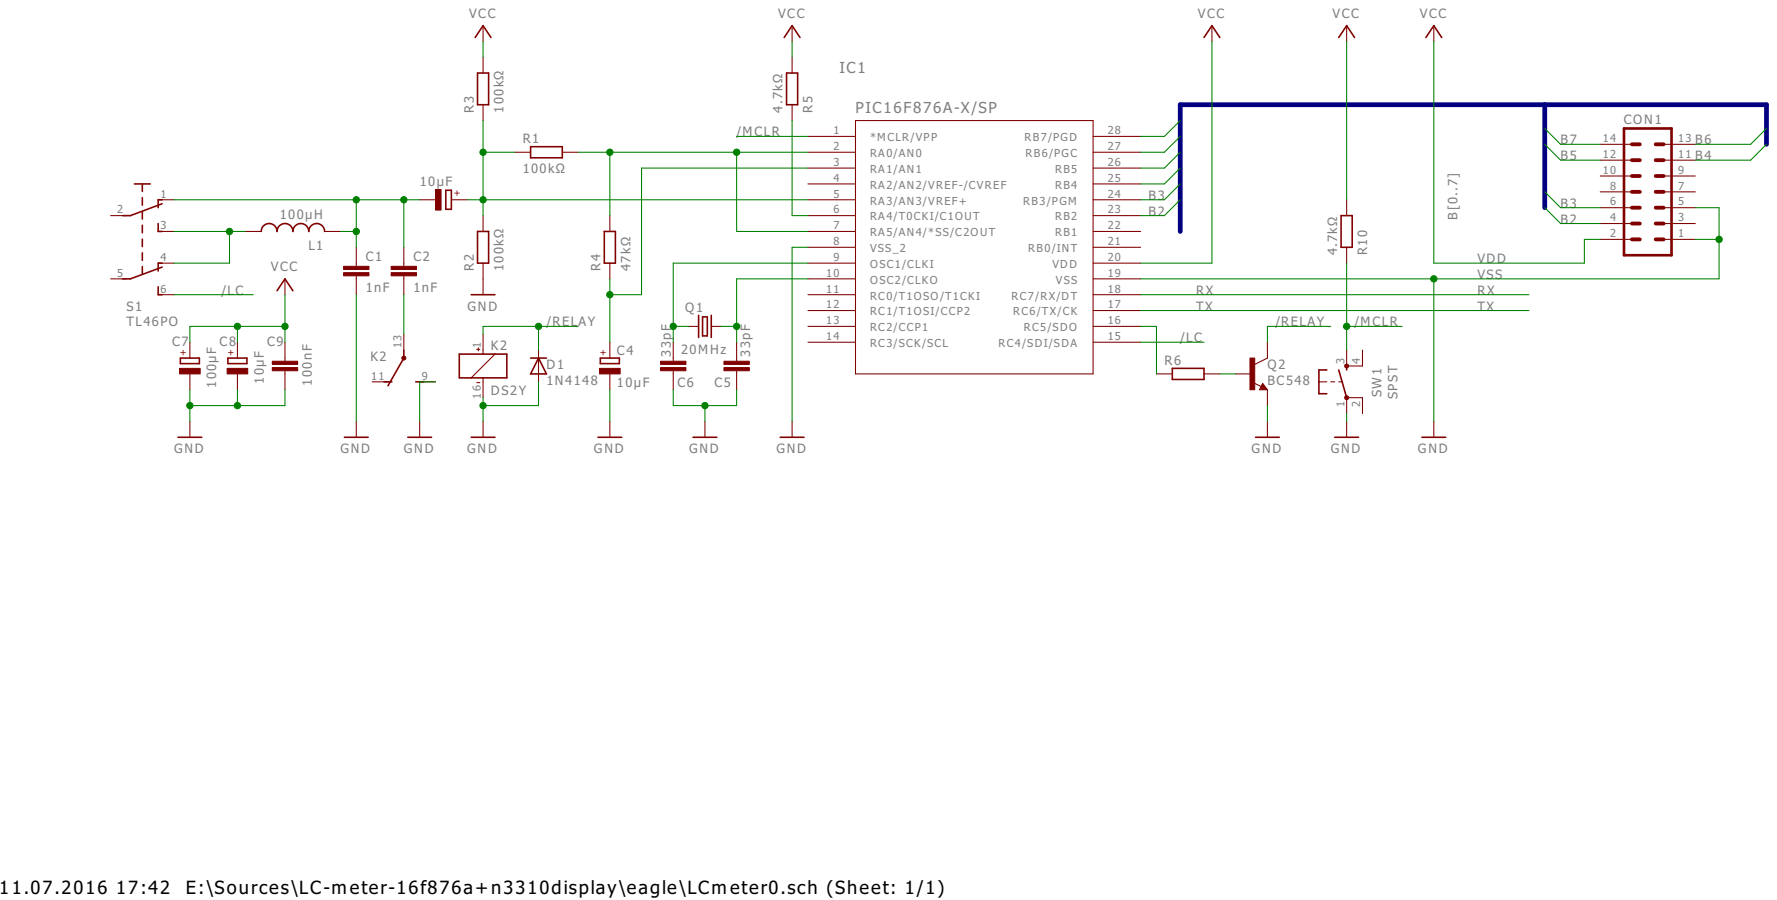
[picture p122: page 1]

11.07.2016 17:42 E:\Sources\LC-meter-16f876a+n3310display\eagle\LCmeter0.sch (Sheet: 1/1)

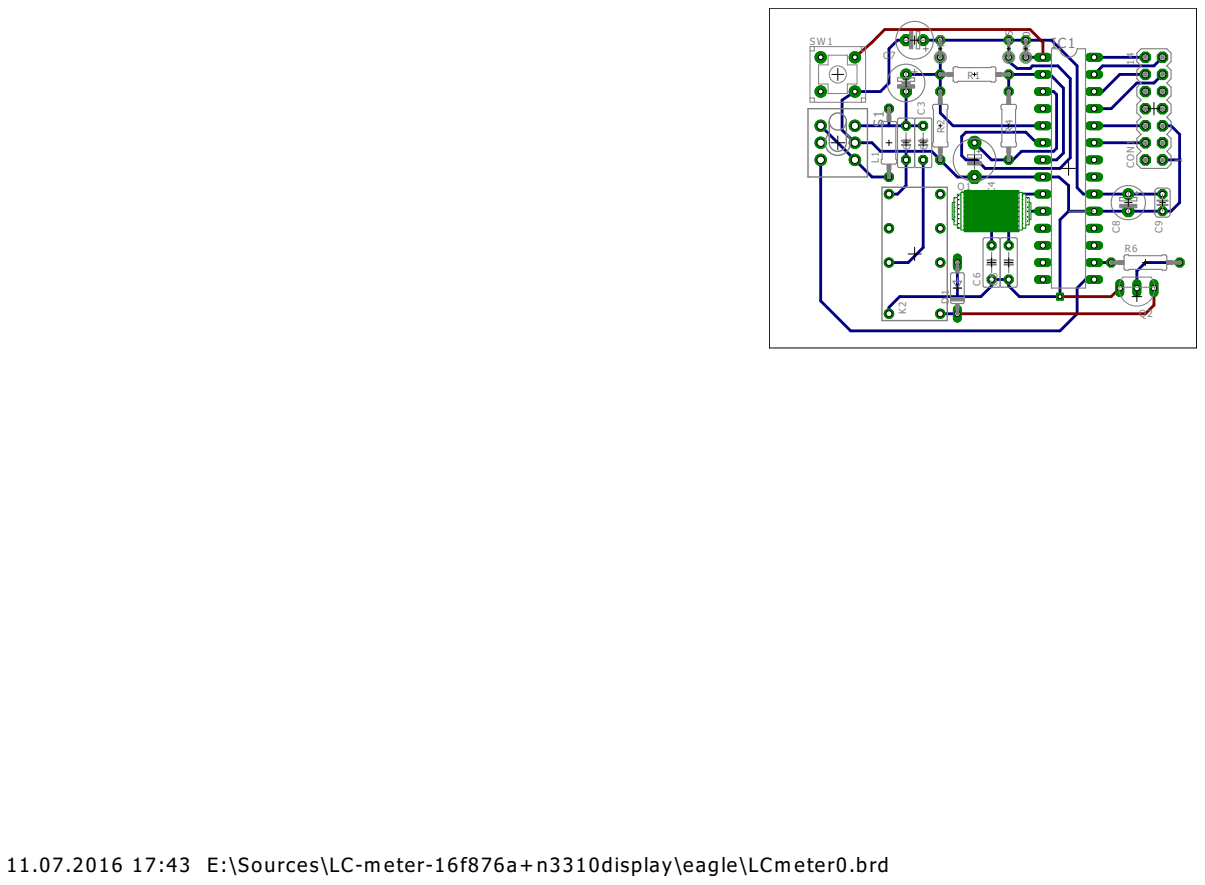
[picture p123: page 2]

11.07.2016 17:43 E:\Sources\LC-meter-16f876a+n3310display\eagle\LCmeter0.brd
