rsenn/lc-meter/doc/pdf/CapMeter-LCD-16F628A-board-mirrored.pdf

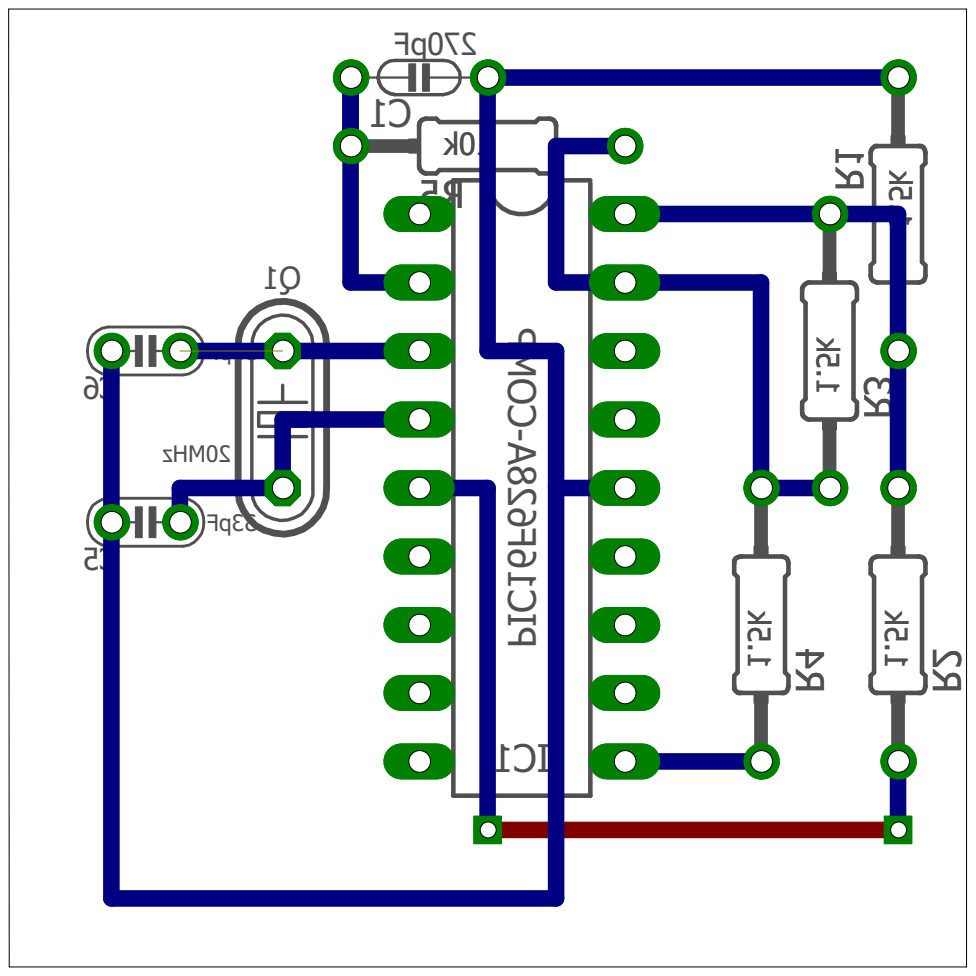
[picture p124: page 1]
