rsenn/lc-meter/doc/pdf/CapMeter-LCD-16F628A-board.pdf

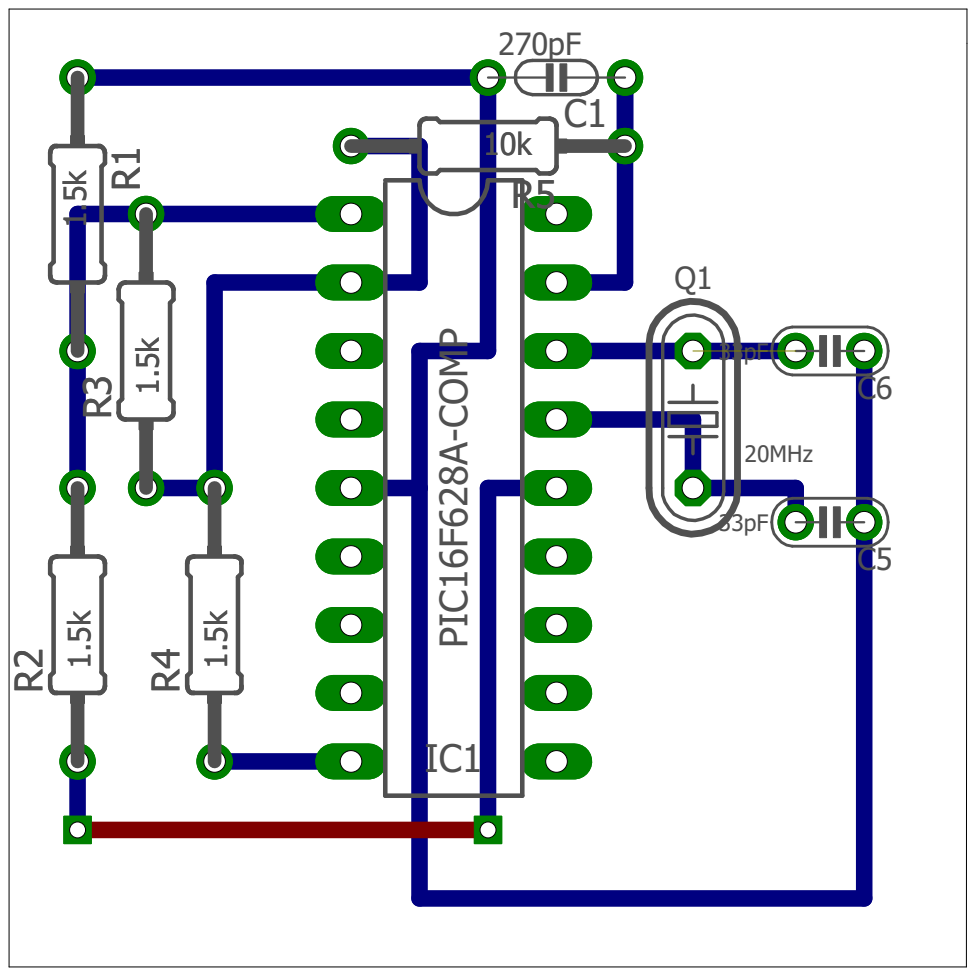
[picture p125: page 1]
