rsenn/lc-meter/doc/pdf/CapMeter-LCD-16F876A-board-mirrored.pdf

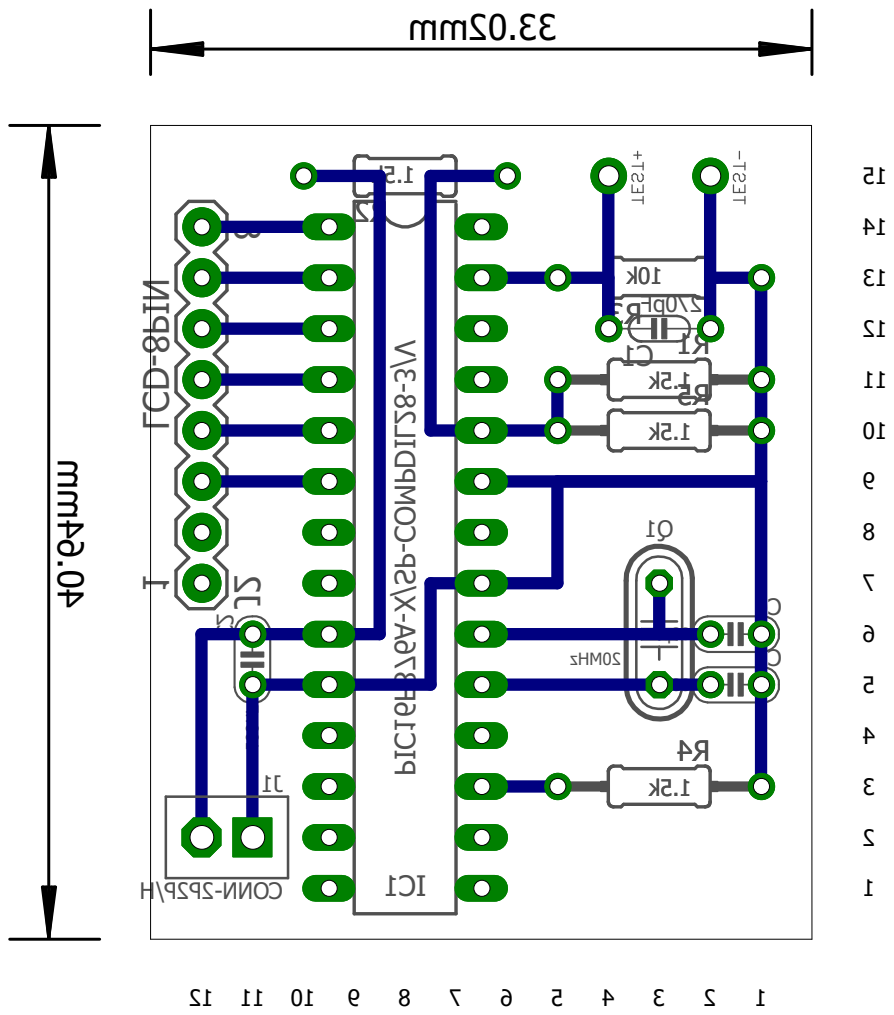
[picture p126: page 1]
