rsenn/lc-meter/doc/pdf/CapMeter-LCD-16F876A-board.pdf

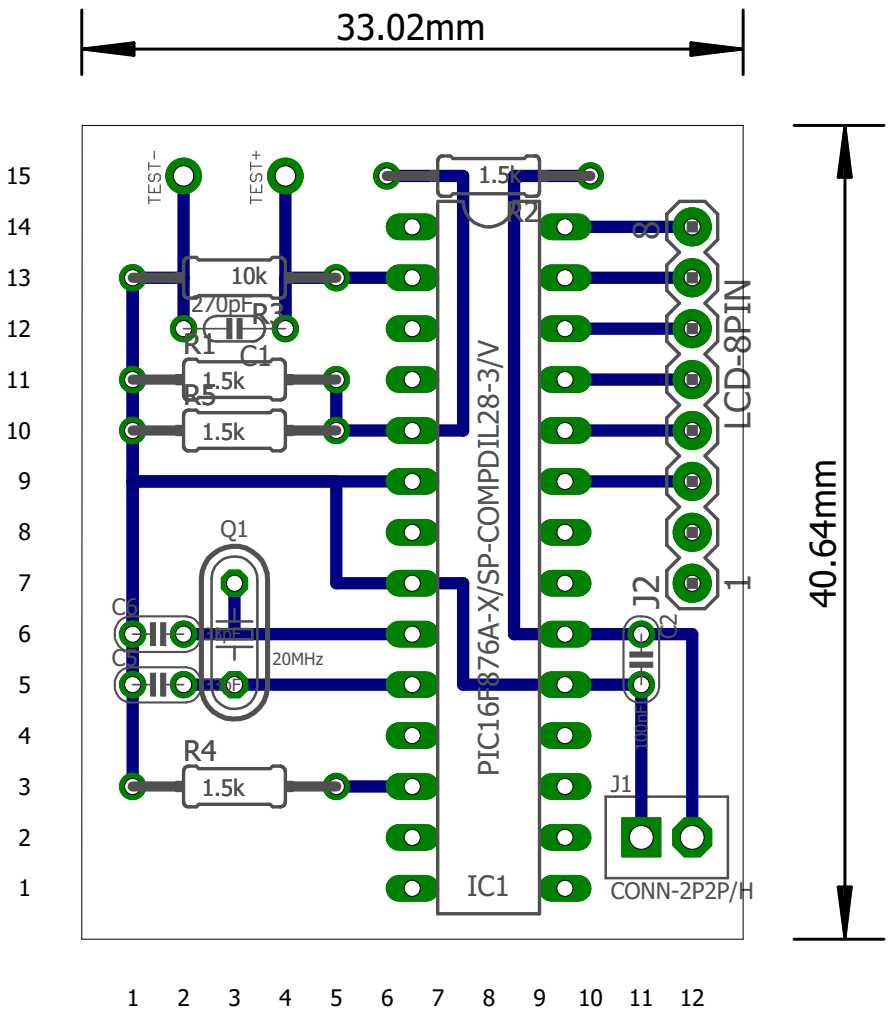
[picture p127: page 1]
