rsenn/lc-meter/doc/pdf/LCMeter-LCD4Bit-18F2550-CMP-board-mirrored.pdf

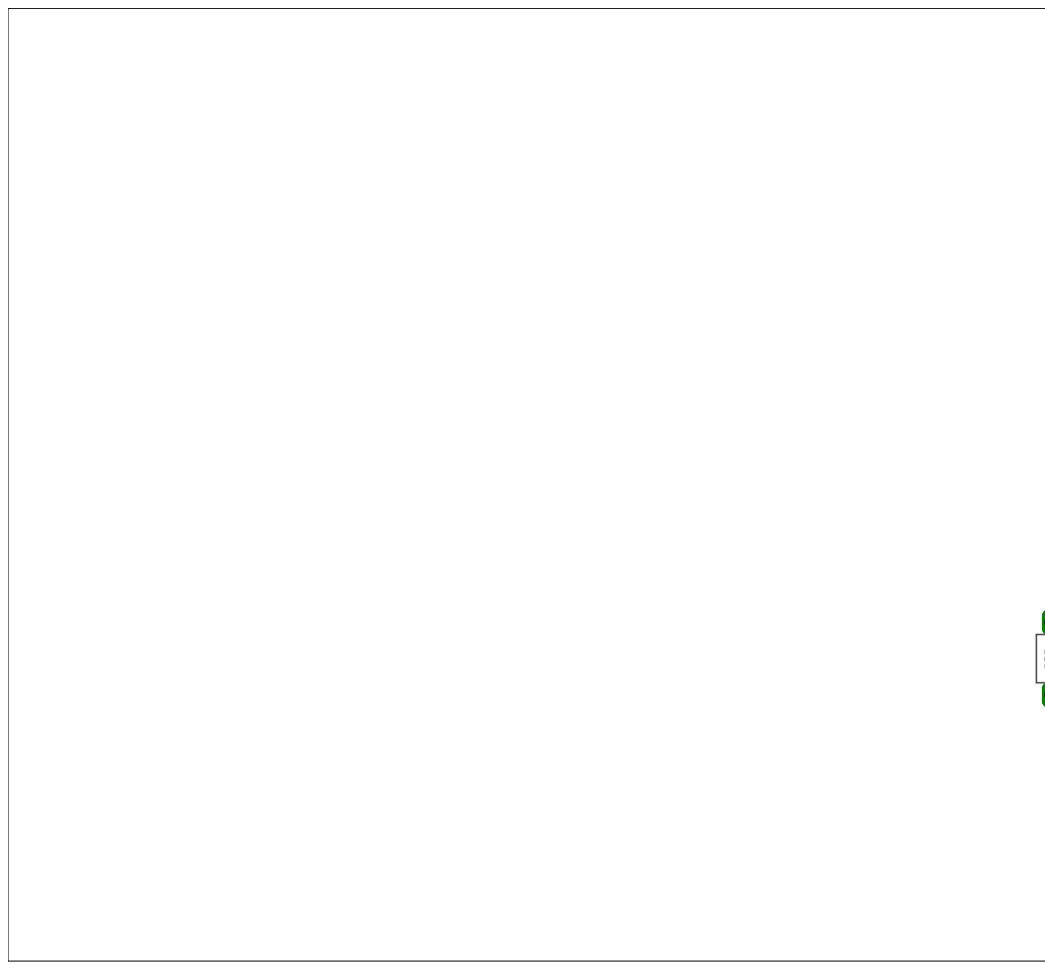
[picture p128: page 1]

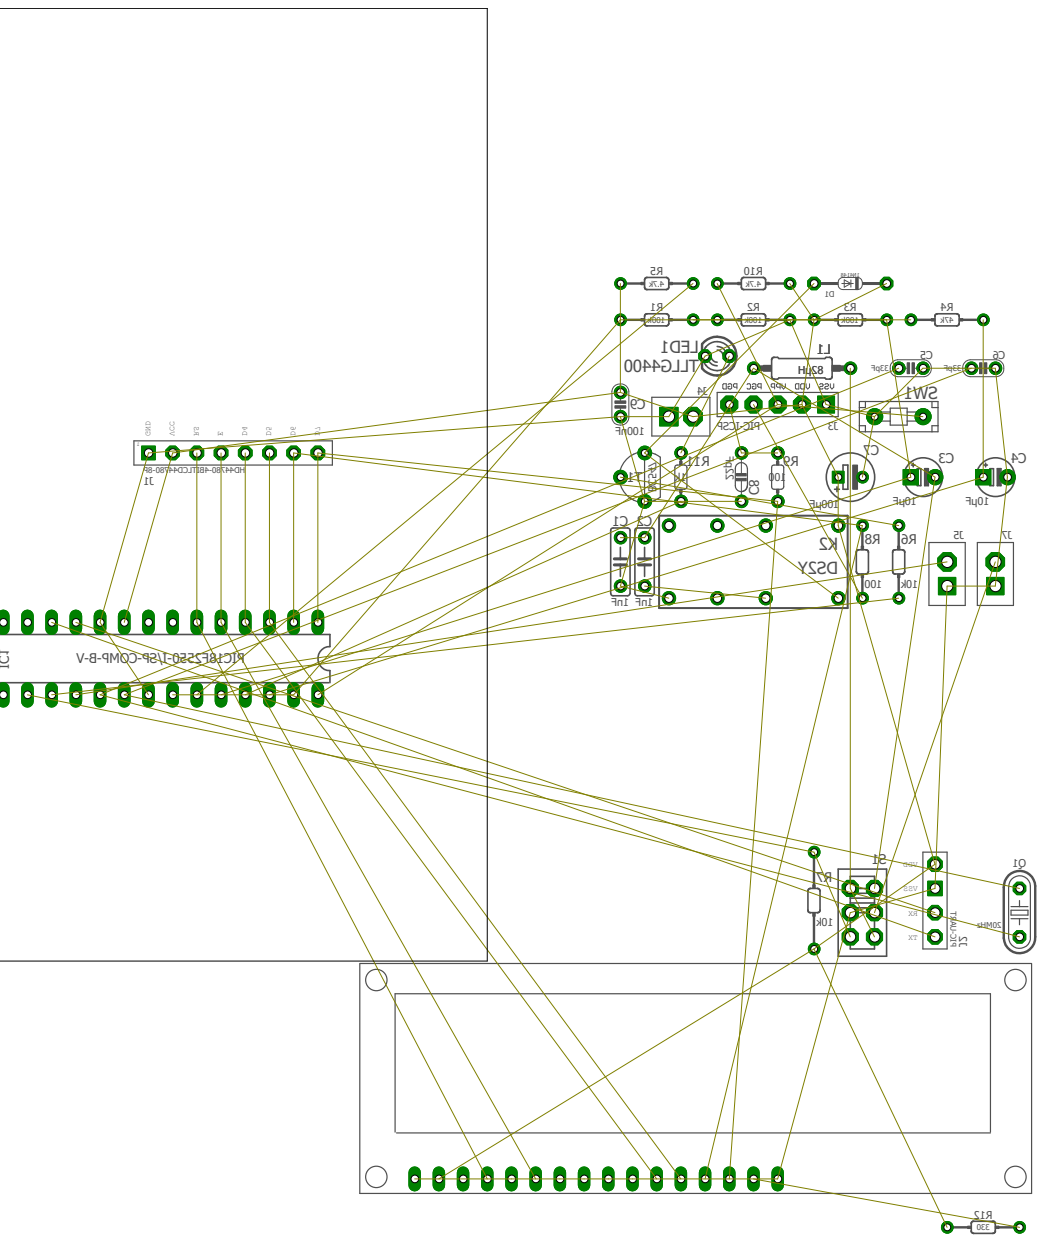
[picture p129: page 2]
