rsenn/lc-meter/doc/pdf/LCMeter-LCD4Bit-18F2550-CMP-board.pdf

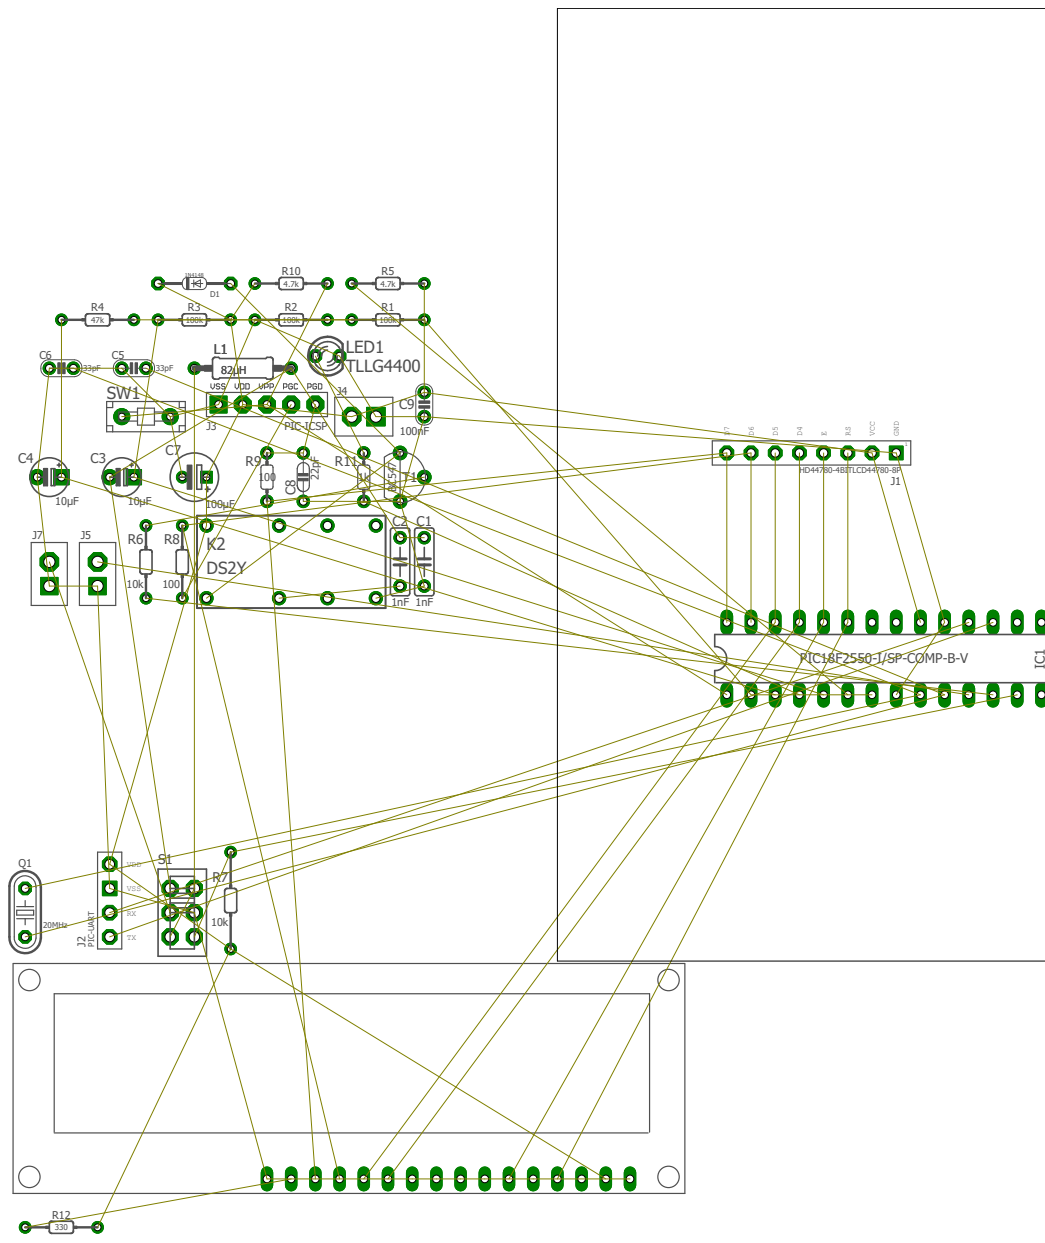
[picture p130: page 1]

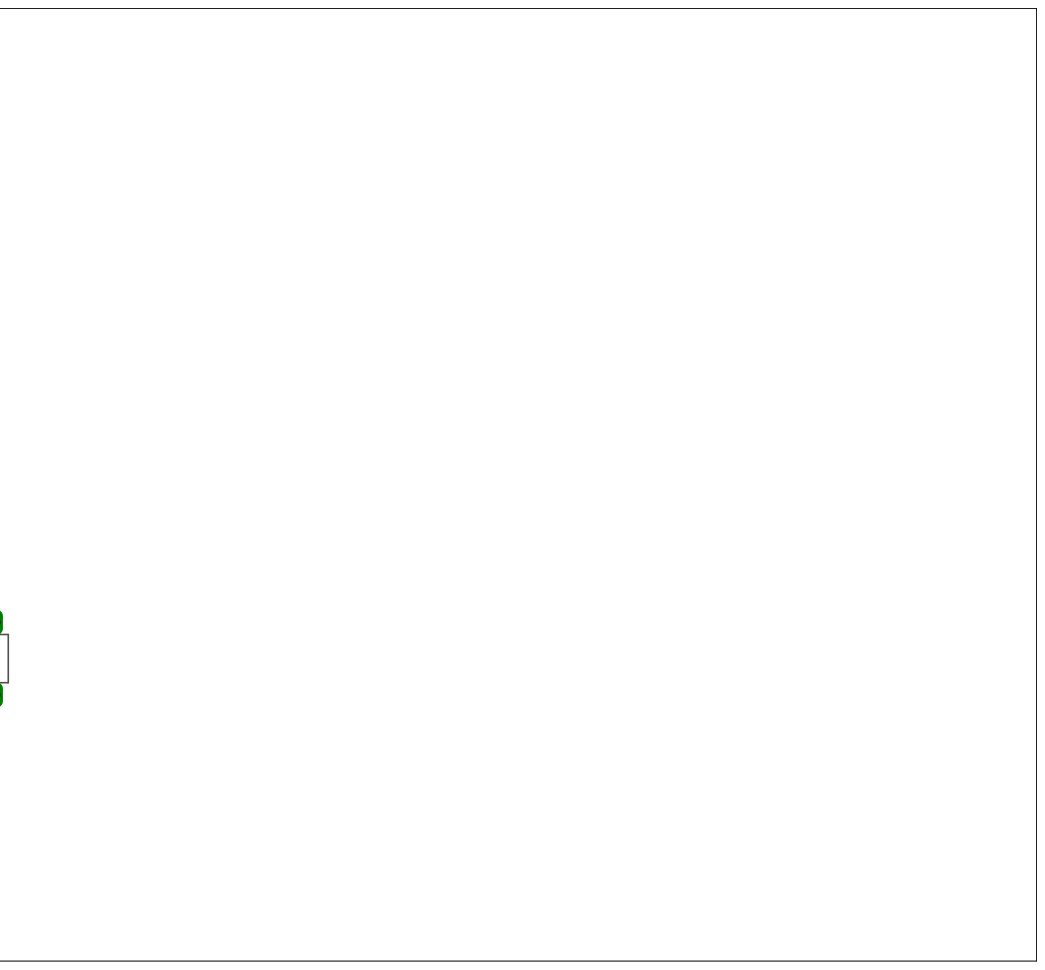
[picture p131: page 2]
