rsenn/lc-meter/doc/pdf/LCMeter-LCD4BitDirect-18F2550-CMP-board-mirrored.pdf

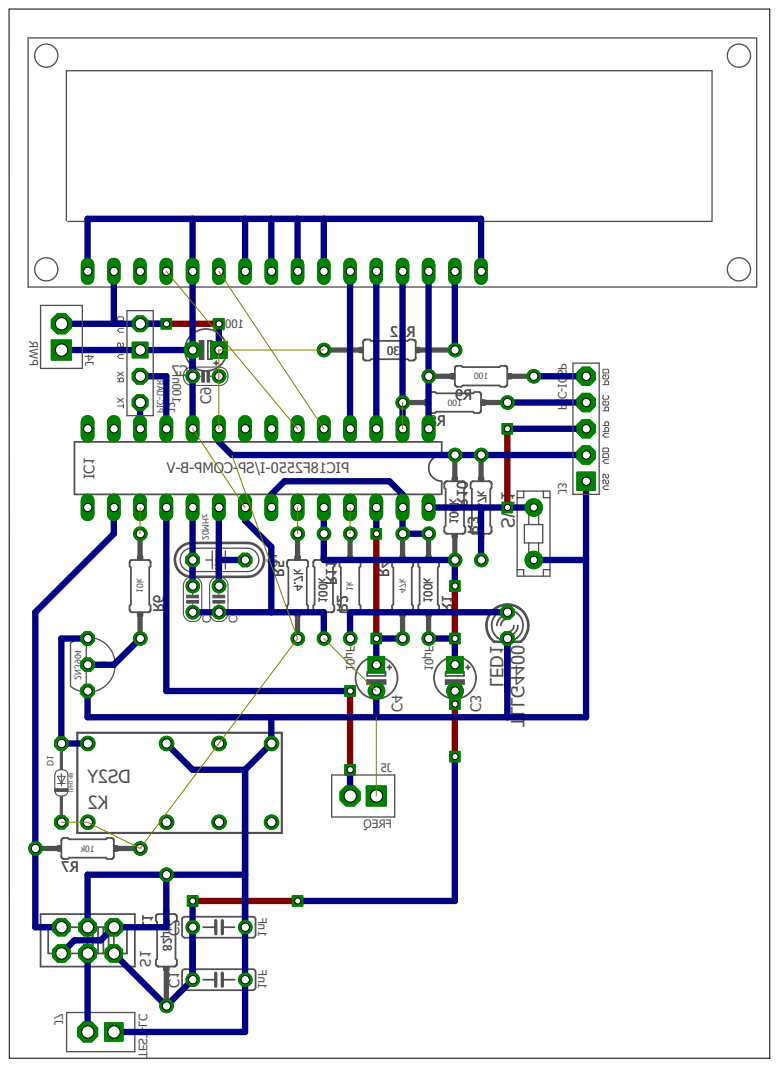
[picture p132: page 1]
