rsenn/lc-meter/doc/pdf/LCMeter-LCD4BitDirect-18F2550-CMP-board.pdf

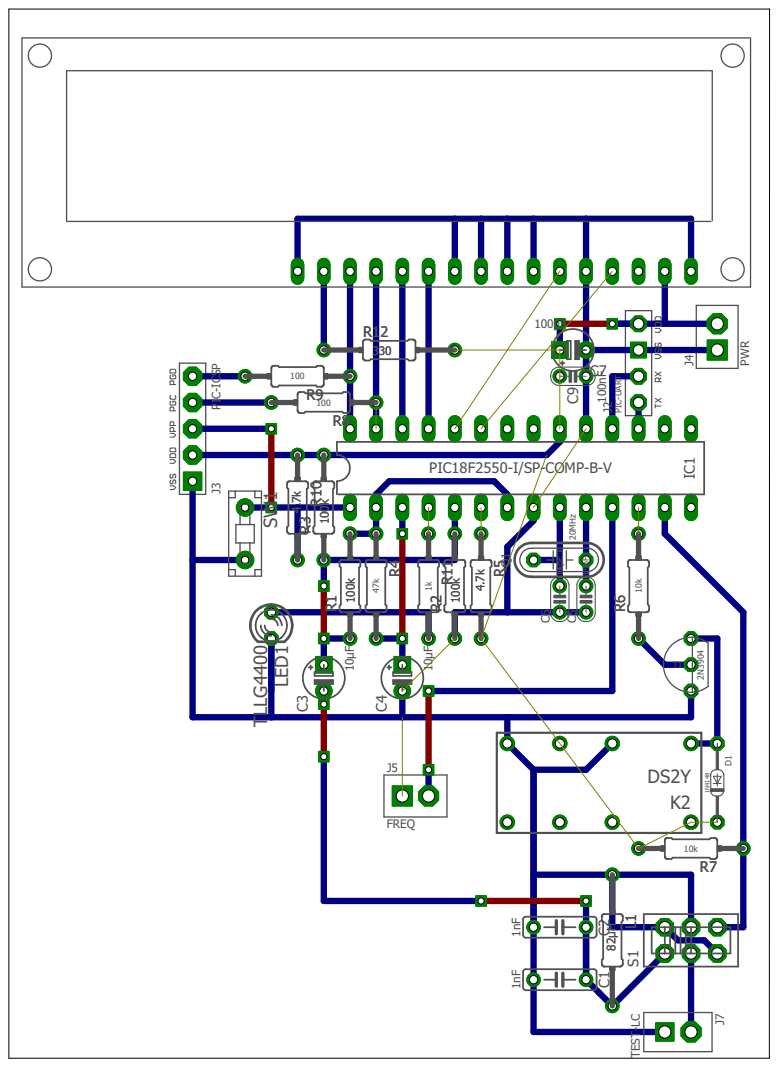
[picture p133: page 1]
