rsenn/lc-meter/doc/pdf/LCmeter0-LCD-8pinlcd-PIC18F2550-COMP-board.pdf

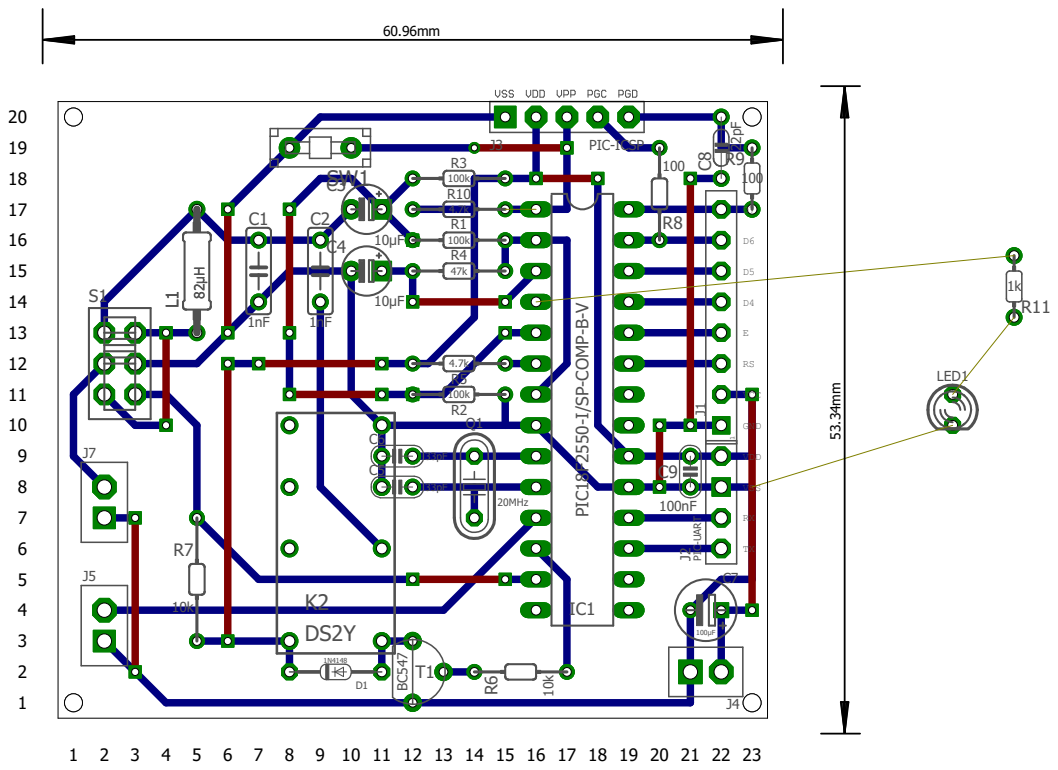
[picture p134: page 1]
