rsenn/lc-meter/doc/pdf/PIC18F2550-USB-HID-LC-Meter-board-mirrored.pdf

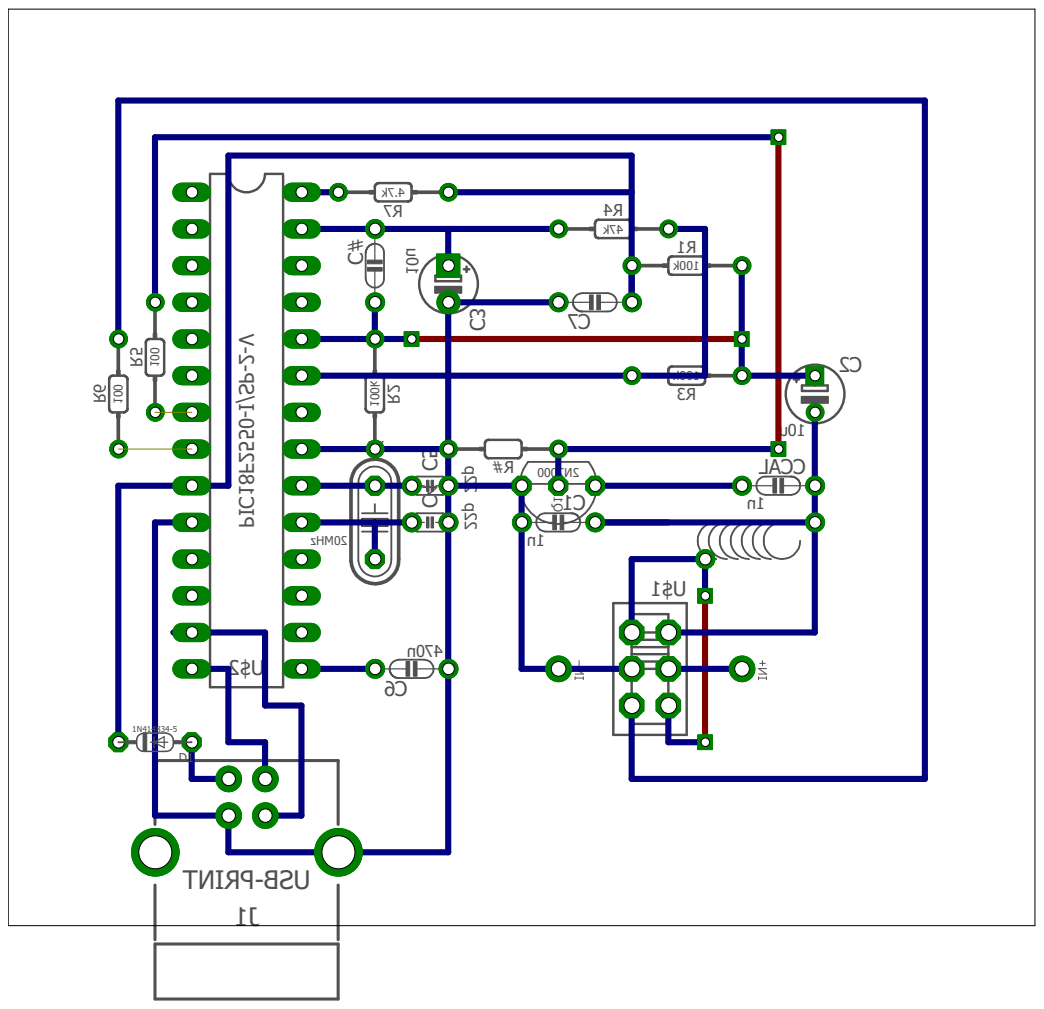
[picture p135: page 1]
