rsenn/lc-meter/doc/pdf/PIC18F2550-USB-HID-LC-Meter-board.pdf

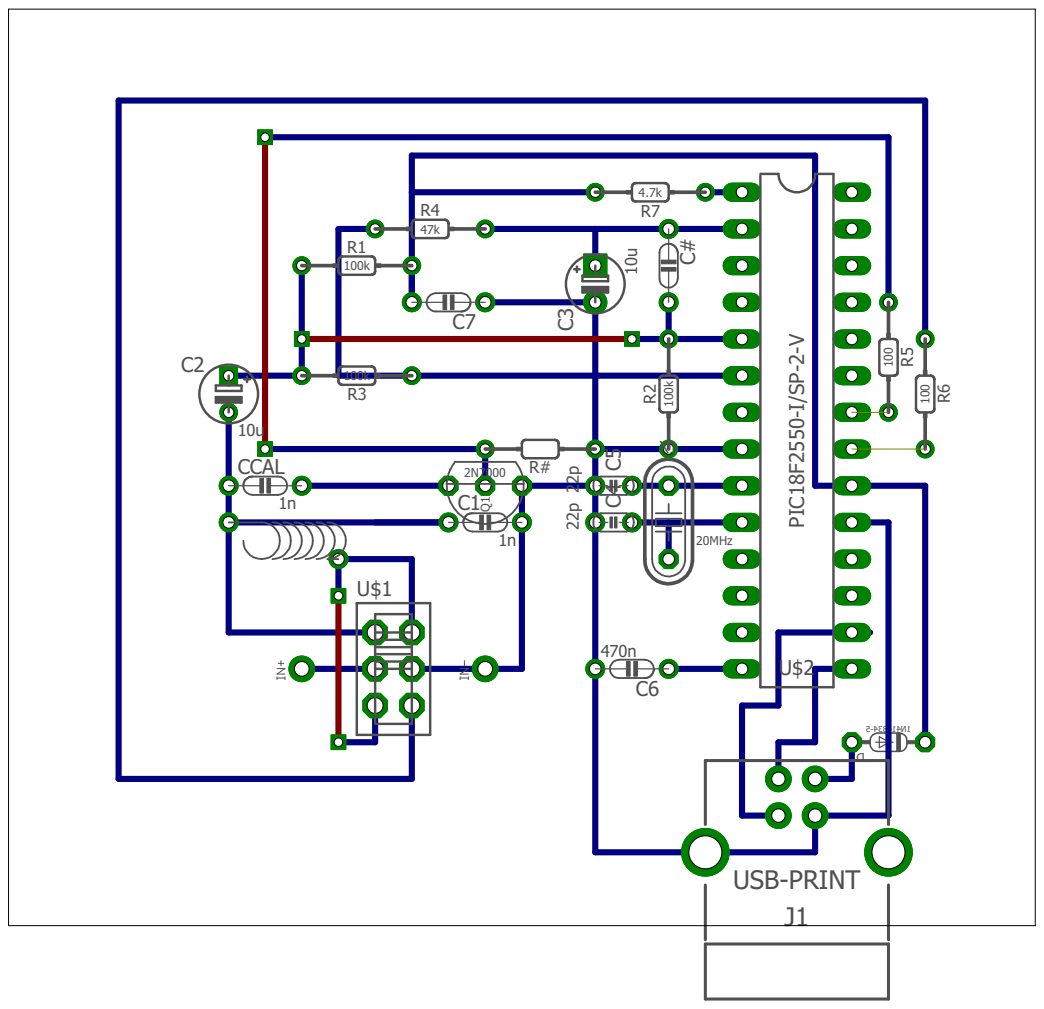
[picture p136: page 1]

C7 CCAL 100k R3 | 470n
