rsenn/lc-meter/(list of files, drawings)

Other design files:
protel/Backup of LCmeter0-LCD-8pinlcd-PIC_COMP.Pcb
protel/LCmeter0-LCD3310-8pinlcd-PIC-COMP.Pcb
protel/LCmeter0-LCD-8pinlcd-alt2.Pcb
protel/LCmeter0-LCD-8pinlcd-alt2_1.SchDoc
protel/LCmeter0-LCD-8pinlcd-alt.Pcb
protel/LCmeter0-LCD-8pinlcd-alt_1.SchDoc
protel/LCmeter0-LCD-8pinlcd-PIC_COM_2.Pcb
protel/LCmeter0-LCD-8pinlcd-PIC_COMP.Pcb
protel/LCmeter0-LCD-8pinlcd-PIC_COMP_1.SchDoc
protel/LCmeter0-LCD-8pinlcd.Pcb
protel/LCmeter0-LCD-8pinlcd_1.SchDoc
protel/LCmeter0-LCD-mounted-PIC-COMP.Pcb
proteus/CapMeter628a.DSN
proteus/CapMeter628a.pdsprj
proteus/Freqmeter18f252.DSN
proteus/Freqmeter876a.DSN
proteus/Freqmeter876a.pdsprj
proteus/LCmeter18f25k22.DSN
proteus/LCmeter18f25k22.pdsprj
proteus/LCmeter18f25k50.pdsprj
proteus/LCmeter18f2455.DSN
proteus/LCmeter18f2455.pdsprj
proteus/LCmeter18f2520.DSN
proteus/LCmeter18f2520.pdsprj
proteus/LCmeter18f2550.DSN
proteus/LCmeter18f2550.pdsprj
proteus/LCmeter876a-julznc-hex.DSN
proteus/LCmeter876a-julznc-hex.pdsprj
proteus/LCmeter876a-julznc.DSN
proteus/LCmeter876a-julznc.pdsprj
proteus/LCmeter876a-lcd3310.DSN
proteus/LCmeter876a-lcd3310.pdsprj
proteus/LCmeter876a-RC0-RC2-Freq.DSN
proteus/LCmeter876a-relais.DSN
proteus/LCmeter876a-relais.pdsprj
proteus/LCmeter876a.DSN
proteus/LCmeter876a.pdsprj
proteus/SelfClockingTest.DSN
proteus/SelfClockingTest.pdsprj
