rsenn/lc-meter/eagle/LCmeter0-LCD-8pinlcd-alt2.brd

## EAGLE design eagle/LCmeter0-LCD-8pinlcd-alt2.brd (2026-11-04)

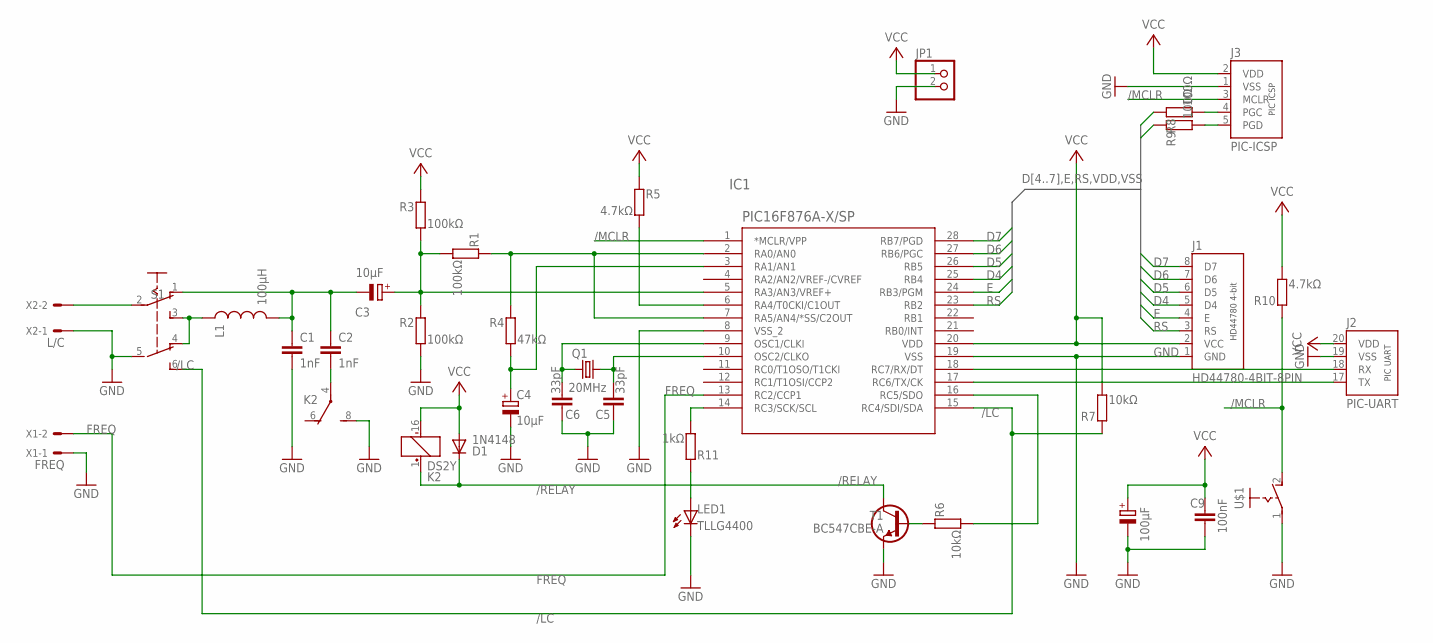
[picture p137: schematic LCmeter0-LCD-8pinlcd-alt2.sch]

Parts:
C1, C2: 1nF; C050-020X036
C3, C4: 10μF; E2,5-4
C5, C6: 33pF; C025-020X036
C7: 100μF; E2,5-6
C9: 100nF; C025-024X044
D1: 1N4148; DO34-7
IC1: PIC16F876A-X/SP; DIL28-3
J1: HD44780-4BIT-8PIN; CONN-8P
J2: PIC-UART
J3: PIC-ICSP; CONN-5P
JP1: PINHD-1X2; 1X02
K2: DS2Y
L1: 100μH; L-8R
LED1: TLLG4400; LED3MM
Q1: 20MHz; HC49
R1, R2, R3: 100kΩ; 0202/7
R4: 47kΩ; 0202/7
R5, R10: 4.7kΩ; 0202/7
R6: 10kΩ; 0202/7
R7: 10kΩ; 0202/10
R8, R9: 100Ω; 0202/5
R11: 1kΩ; 0202/5
S1: SL-SW-2P-2T; SLSW-2P2T
T1: BC547CBE-A; TO92-CBE-A
U$1: PB-1P-1T; PB-1P1T
X1: FREQ; 70543-02
X2: L/C; 70543-02

Connections:
/LC: IC1.15 (RC4/SDI/SDA), R7.2, S1.6 (S1)
/MCLR: IC1.1 (*MCLR/VPP), J3.3 (MCLR), R10.2, U$1.2 (S)
/RELAY: D1.C, K2.1 (+), T1.C
A0: IC1.2 (RA0/AN0), IC1.7 (RA5/AN4/*SS/C2OUT), R1.2, R4.2
A1: C4.+, IC1.3 (RA1/AN1), R4.1
A3: C3.+, IC1.5 (RA3/AN3/VREF+), R1.1, R2.2, R3.1
A4: IC1.6 (RA4/T0CKI/C1OUT), R5.1
C2_CON: C2.2, K2.4
D4: IC1.25 (RB4), J1.5 (D4)
D5: IC1.26 (RB5), J1.6 (D5)
D6: IC1.27 (RB6/PGC), J1.7 (D6), R9.2
D7: IC1.28 (RB7/PGD), J1.8 (D7), R8.2
E: IC1.24 (RB3/PGM), J1.4 (E)
FREQ: IC1.13 (RC2/CCP1), X1.2
GND: C1.2, C4.-, C5.1, C6.1, C7.-, C9.2, IC1.8 (VSS_2), IC1.19 (VSS), J1.1 (GND), J2.19 (VSS), J3.1 (VSS), JP1.2, K2.8 (S), LED1.K (C), R2.1, S1.5 (P1), T1.E, U$1.1, X1.1, X2.1
M+: S1.2, X2.2
unnamed: J3.4 (PGC), R8.1
unnamed: C1.1, C2.1, C3.-, L1.P$2 (2), S1.1 (O)
unnamed: J3.5 (PGD), R9.1
unnamed: IC1.14 (RC3/SCK/SCL), R11.1
unnamed: R6.2, T1.B
unnamed: LED1.A, R11.2
unnamed: L1.P$1 (1), S1.3 (S), S1.4 (O1)
unnamed: IC1.17 (RC6/TX/CK), J2.17 (TX)
OSC1: C6.2, IC1.9 (OSC1/CLKI), Q1.1
OSC2: C5.2, IC1.10 (OSC2/CLKO), Q1.2
RC5: IC1.16 (RC5/SDO), R6.1
RS: IC1.23 (RB2), J1.3 (RS)
RX: IC1.18 (RC7/RX/DT), J2.18 (RX)
VCC: C7.+, C9.1, D1.A, IC1.20 (VDD), J1.2 (VCC), J2.20 (VDD), J3.2 (VDD), JP1.1, K2.16 (-), R3.2, R5.2, R7.1, R10.1

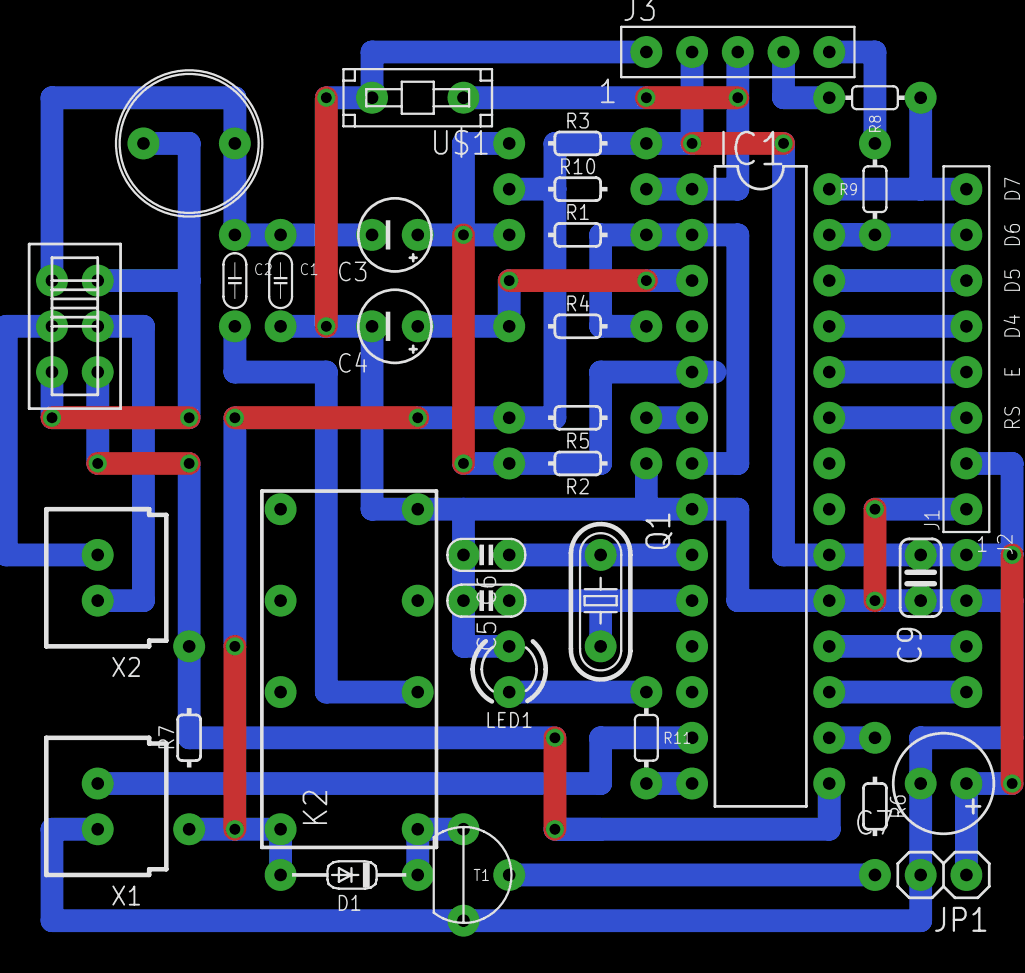
[picture p138: board LCmeter0-LCD-8pinlcd-alt2.brd from above]

Board: 2 copper layers, 34 parts (0 on the bottom side), 30 nets.
