rsenn/lc-meter/eagle/LCmeter0-LCD-8pinlcd-PIC_COMP.brd

## EAGLE design eagle/LCmeter0-LCD-8pinlcd-PIC_COMP.brd (2026-11-04)

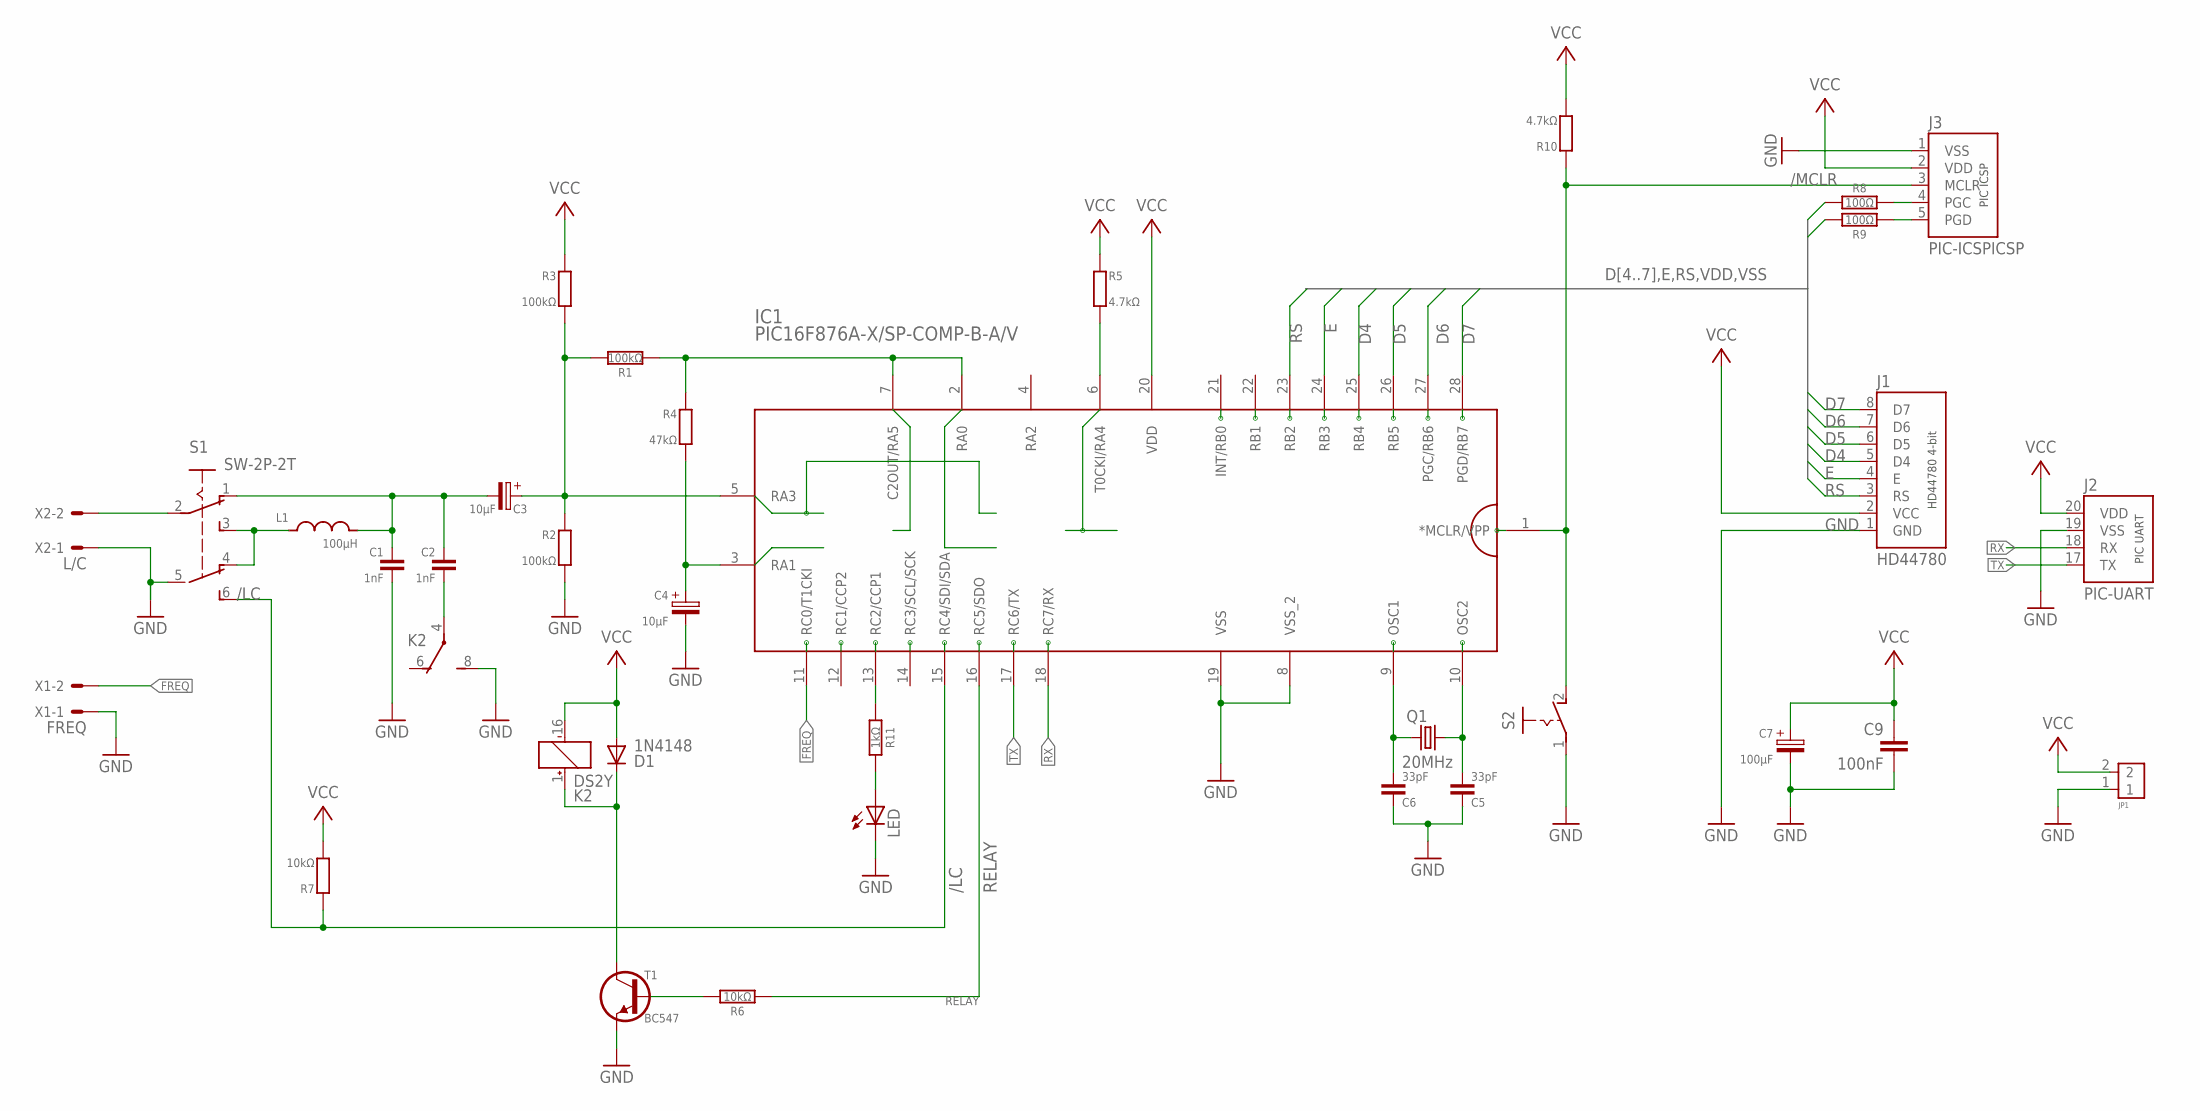
[picture p139: schematic LCmeter0-LCD-8pinlcd-PIC_COMP.sch]

Parts:
C1, C2: 1nF; C050-020X036
C3, C4: 10μF; E2,5-4
C5, C6: 33pF; C025-020X036
C7: 100μF; E2,5-5
C9: 100nF; C025-024X044
D1: 1N4148; DO34-7
IC1: PIC16F876A-X/SP-COMP-B-A/V; DIL28-3/V
J1: HD44780; CONN-8P
J2: PIC-UART
J3: PIC-ICSPICSP; PIC-ICSP
JP1: CONN-2P2P/V; CONN-2P-V
K2: DS2Y
L1: 100µH; L-02/5V
LED: TLLG4400; LED3MM
Q1: 20MHz; HC49
R1, R2, R3: 100kΩ; 0202/7
R4: 47kΩ; 0202/7
R5, R10: 4.7kΩ; 0202/7
R6: 10kΩ; 0202/7
R7: 10kΩ; 0202/10
R8, R9: 100Ω; 0202/5
R11: 1kΩ; 0202/5
S1: SW-2P-2T; SLSW-2P2T
S2: PB-1P-1T; PB-1P1T
T1: BC547; TO92-CBE-A
X1: FREQ; 70543-02
X2: L/C; 70543-02

Connections:
/LC: IC1.15 (RC4/SDI/SDA), R7.1, S1.6 (S1)
/MCLR: IC1.1 (*MCLR/VPP), J3.3 (MCLR), R10.1, S2.2 (S)
/RELAY: D1.C, K2.1 (+), T1.C
A0: IC1.2 (RA0), IC1.7 (C2OUT/RA5), R1.1, R4.1
A1: C4.+, IC1.3 (RA1), R4.2
A3: C3.+, IC1.5 (RA3), R1.2, R2.1, R3.2
A4: IC1.6 (T0CKI/RA4), R5.2
C2_CON: C2.2, K2.4
D4: IC1.25 (RB4), J1.5 (D4)
D5: IC1.26 (RB5), J1.6 (D5)
D6: IC1.27 (PGC/RB6), J1.7 (D6), R9.1
D7: IC1.28 (PGD/RB7), J1.8 (D7), R8.1
E: IC1.24 (RB3), J1.4 (E)
FREQ: IC1.11 (RC0/T1CKI), X1.2
GND: C1.2, C4.-, C5.1, C6.1, C7.-, C9.2, IC1.8 (VSS_2), IC1.19 (VSS), J1.1 (GND), J2.19 (VSS), J3.1 (VSS), JP1.1, K2.8 (S), LED.K (C), R2.2, S1.5 (P1), S2.1, T1.E, X1.1, X2.1
M+: S1.2, X2.2
unnamed: J3.4 (PGC), R8.2
unnamed: C1.1, C2.1, C3.-, L1.2, S1.1 (O)
unnamed: J3.5 (PGD), R9.2
unnamed: IC1.13 (RC2/CCP1), R11.2
unnamed: R6.1, T1.B
unnamed: LED.A, R11.1
unnamed: L1.1, S1.3 (S), S1.4 (O1)
OSC1: C6.2, IC1.9 (OSC1), Q1.1
OSC2: C5.2, IC1.10 (OSC2), Q1.2
RELAY: IC1.16 (RC5/SDO), R6.2
RS: IC1.23 (RB2), J1.3 (RS)
RX: IC1.18 (RC7/RX), J2.18 (RX)
TX: IC1.17 (RC6/TX), J2.17 (TX)
VCC: C7.+, C9.1, D1.A, IC1.20 (VDD), J1.2 (VCC), J2.20 (VDD), J3.2 (VDD), JP1.2, K2.16 (-), R3.1, R5.1, R7.2, R10.2

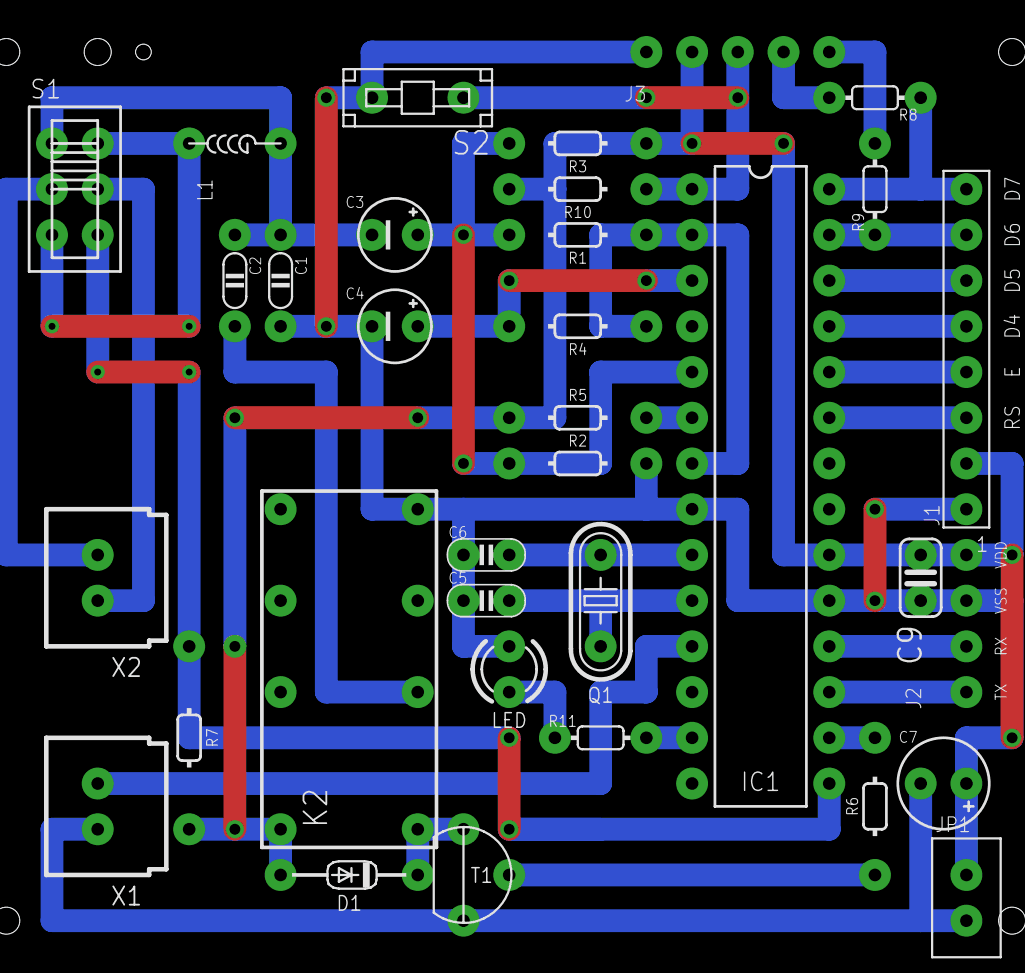
[picture p140: board LCmeter0-LCD-8pinlcd-PIC_COMP.brd from above]

Board: 2 copper layers, 34 parts (0 on the bottom side), 30 nets.
