rsenn/lc-meter/eagle/unrouted/LCMeter-LCD4BitDirect-18F2550-CMP-NoRelay.brd

## EAGLE design eagle/unrouted/LCMeter-LCD4BitDirect-18F2550-CMP-NoRelay.brd (2020-10-09)

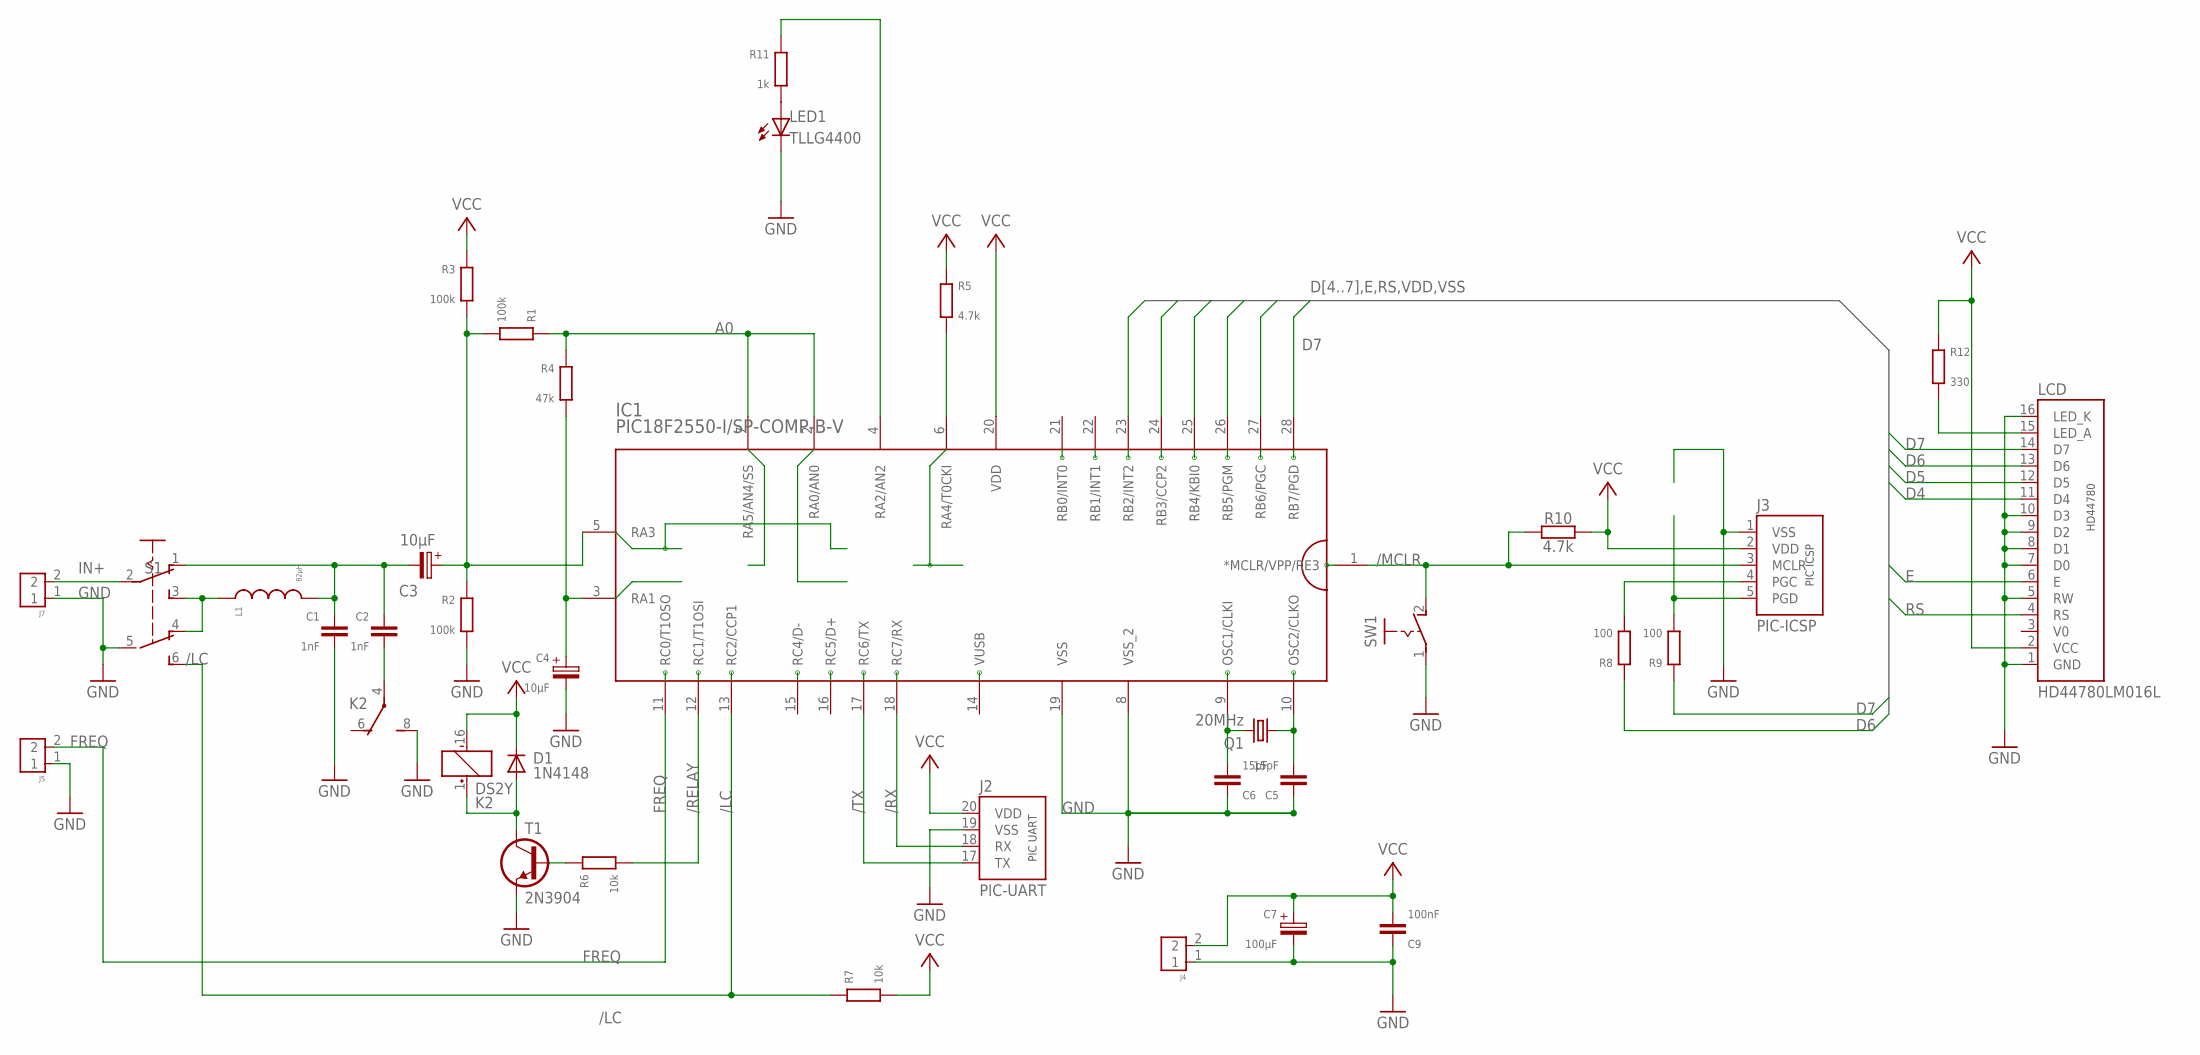
[picture p141: schematic LCMeter-LCD4BitDirect-18F2550-CMP-NoRelay.sch]

Parts:
C1, C2: 1nF; C050-025X060
C3, C4: 10μF; E2,5-4
C5, C6: 15pF; C025-020X036
C7: 100μF; E2,5-4
C9: 100nF; C025-020X036/V
D1: 1N4148; DO34-7
IC1: PIC18F2550-I/SP-COMP-B-V; DIL28-3/V
J2: PIC-UART
J3: PIC-ICSP
J4: PWR; CONN-2P
J5: FREQ; CONN-2P
J7: TEST-LC; CONN-2P-V
K2: DS2Y
L1: 82μH; 0204/12
LCD: HD44780LM016L; LM016L-HD44780
LED1: TLLG4400; LED3MM
Q1: 20MHz; HC49
R1, R2, R3: 100k; 0204/10
R4: 47k; 0204/10-V
R5, R10: 4.7k; 0204/10
R6, R7: 10k; 0204/10-V
R8, R9: 100; 0204/10-V
R11: 1k; 0204/10-V
R12: 330; 0204/12
S1: SL-SW-2P-2T; SLSW-2P2T
SW1: PB-1P-1T; PB-1P1T
T1: 2N3904; TO92

Connections:
/LC: IC1.13 (RC2/CCP1), R7.2, S1.6 (S1)
/MCLR: IC1.1 (*MCLR/VPP/RE3), J3.3 (MCLR), R10.2, SW1.2 (S)
/RELAY: IC1.12 (RC1/T1OSI), R6.1
/RX: IC1.18 (RC7/RX), J2.18 (RX)
/TX: IC1.17 (RC6/TX), J2.17 (TX)
A0: IC1.2 (RA0/AN0), IC1.7 (RA5/AN4/SS), R1.2, R4.2
A1: C4.+, IC1.3 (RA1), R4.1
A3: C3.+, IC1.5 (RA3), R1.1, R2.2, R3.1
A4: IC1.6 (RA4/T0CKI), R5.1
C2_CON: C2.2, K2.4
D4: IC1.25 (RB4/KBI0), LCD.11 (D4)
D5: IC1.26 (RB5/PGM), LCD.12 (D5)
D6: IC1.27 (RB6/PGC), LCD.13 (D6), R8.2
D7: IC1.28 (RB7/PGD), LCD.14 (D7), R9.2
E: IC1.24 (RB3/CCP2), LCD.6 (E)
FREQ: IC1.11 (RC0/T1OSO), J5.2
GND: C1.2, C4.-, C5.1, C6.1, C7.-, C9.1, IC1.8 (VSS_2), IC1.19 (VSS), J2.19 (VSS), J3.1 (VSS), J4.1, J5.1, J7.1, K2.8 (S), LCD.1 (GND), LCD.5 (RW), LCD.7 (D0), LCD.8 (D1), LCD.9 (D2), LCD.10 (D3), LCD.16 (LED_K), LED1.K (C), R2.1, S1.5 (P1), SW1.1, T1.1 (E)
IN+: J7.2, S1.2
unnamed: LED1.A, R11.1
unnamed: C1.1, C2.1, C3.-, L1.2, S1.1 (O)
unnamed: IC1.4 (RA2/AN2), R11.2
unnamed: LCD.15 (LED_A), R12.1
unnamed: R6.2, T1.2 (B)
unnamed: L1.1, S1.3 (S), S1.4 (O1)
unnamed: D1.A, K2.1 (+), T1.3 (C)
OSC1: C6.2, IC1.9 (OSC1/CLKI), Q1.2
OSC2: C5.2, IC1.10 (OSC2/CLKO), Q1.1
PGC: J3.4 (PGC), R8.1
PGD: J3.5 (PGD), R9.1
RS: IC1.23 (RB2/INT2), LCD.4 (RS)
VCC: C7.+, C9.2, D1.C, IC1.20 (VDD), J2.20 (VDD), J3.2 (VDD), J4.2, K2.16 (-), LCD.2 (VCC), R3.2, R5.2, R7.1, R10.1, R12.2

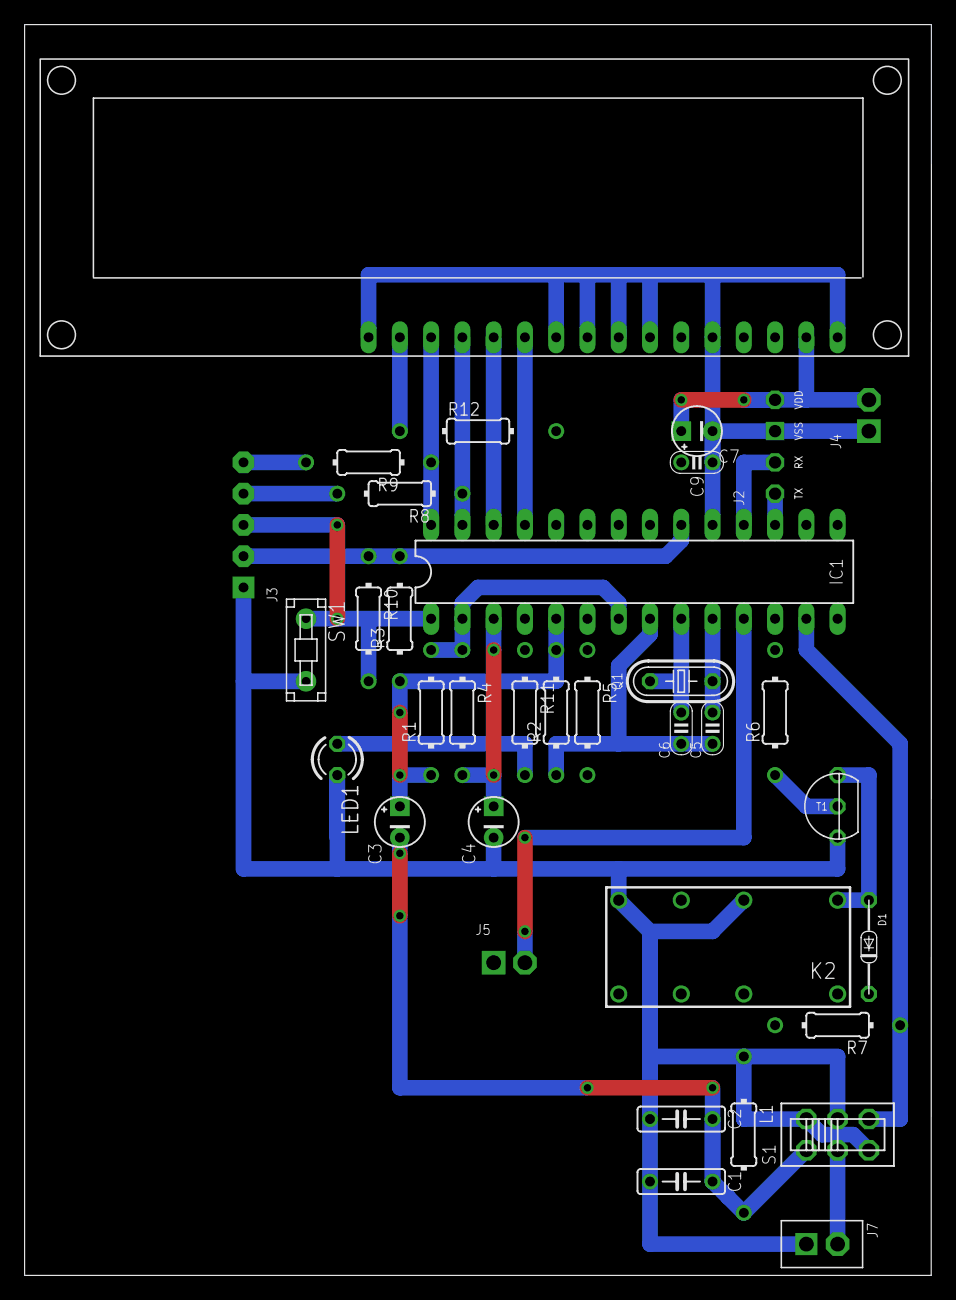
[picture p142: board LCMeter-LCD4BitDirect-18F2550-CMP-NoRelay.brd from above]

Board: 2 copper layers, 73.7 x 101.6 mm, 35 parts (0 on the bottom side), 31 nets.
