rsenn/lc-meter/eagle/unrouted/CapMeter-LCD-16F876A.brd

## EAGLE design eagle/unrouted/CapMeter-LCD-16F876A.brd (2020-10-09)

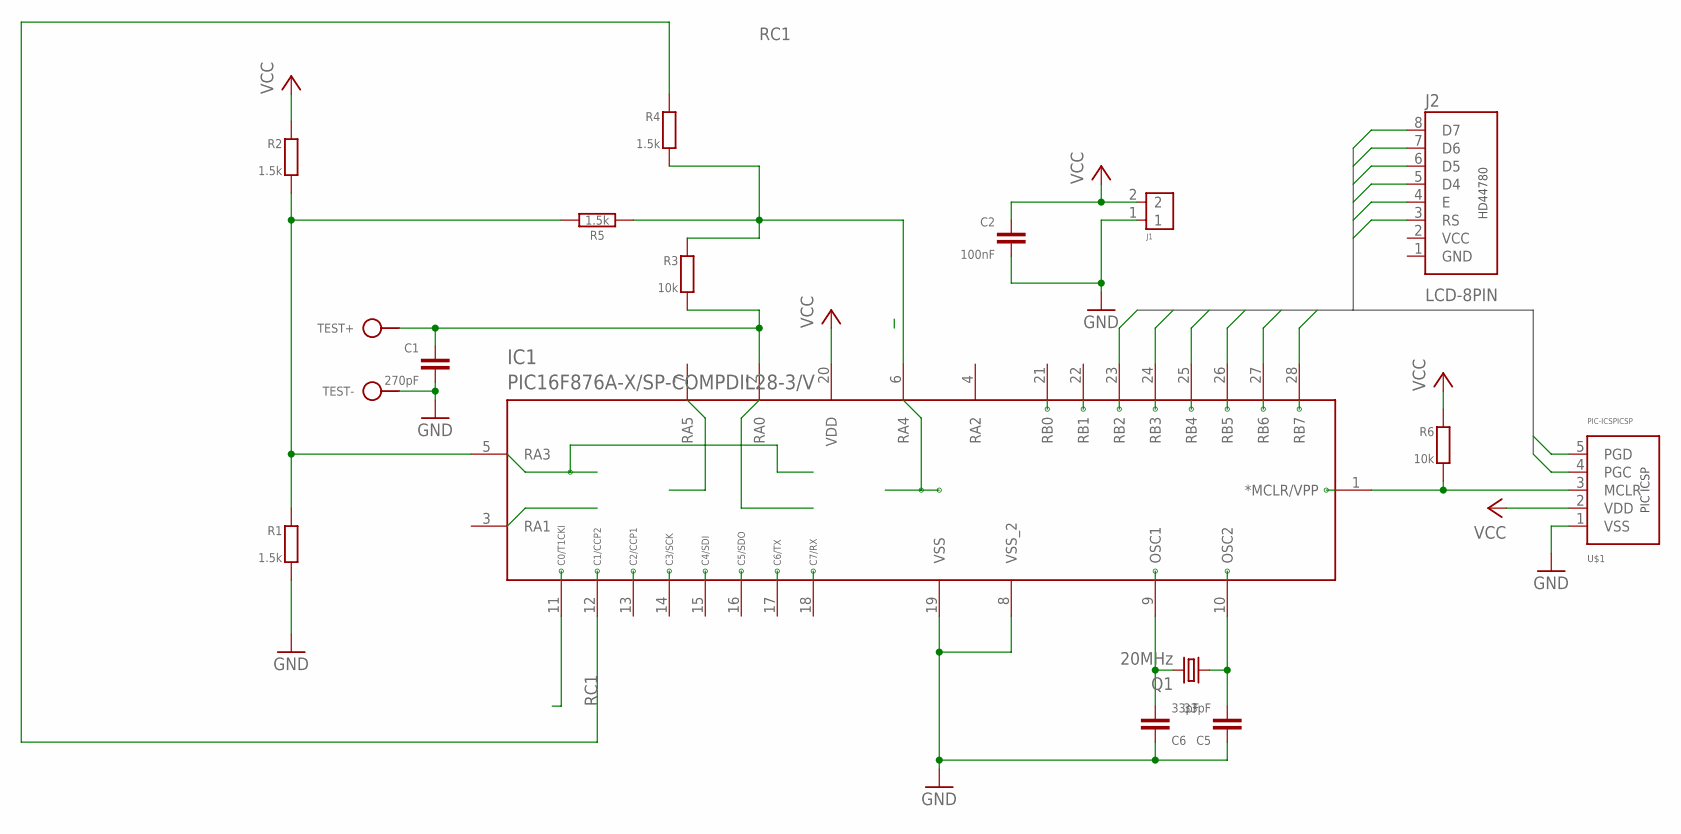
[picture p143: schematic CapMeter-LCD-16F876A.sch]

Parts:
C1: 270pF; C050-020X036
C2: 100nF; C025-020X036
C5, C6: 33pF; C025-020X036
IC1: PIC16F876A-X/SP-COMPDIL28-3/V; DIL28-3/V
J1: CONN-2P2P/H; CONN-2P
J2: LCD-8PIN; 1X8
Q1: 20MHz; HC49
R1, R2, R4: 1.5k; 0204/10
R3: 10k; 0204/10
R5: 1.5k; 0202/10
R6: 10k; 0204/10-V
TEST+: SPAD
TEST-: SPAD
U$1: PIC-ICSPICSP; PIC-ICSP

Connections:
D4: IC1.25 (RB4), J2.5 (D4)
D5: IC1.26 (RB5), J2.6 (D5)
D6: IC1.27 (RB6), J2.7 (D6), U$1.4 (PGC)
D7: IC1.28 (RB7), J2.8 (D7), U$1.5 (PGD)
E: IC1.24 (RB3), J2.4 (E)
GND: C1.2, C2.2, C5.1, C6.1, IC1.8 (VSS_2), IC1.19 (VSS), J1.1, R1.2, TEST-.1, U$1.1 (VSS)
unnamed: IC1.2 (RA0), R3.2, TEST+.1
unnamed: IC1.6 (RA4), R3.1, R4.2, R5.1
unnamed: IC1.5 (RA3), R1.1, R2.2, R5.2
unnamed: IC1.1 (*MCLR/VPP), R6.2, U$1.3 (MCLR)
OSC1: C6.2, IC1.9 (OSC1), Q1.2
OSC2: C5.2, IC1.10 (OSC2), Q1.1
RC1: IC1.12 (RC1), R4.1
RS: IC1.23 (RB2), J2.3 (RS)
VCC: C2.1, IC1.20 (VDD), J1.2, R2.1, R6.1, U$1.2 (VDD)

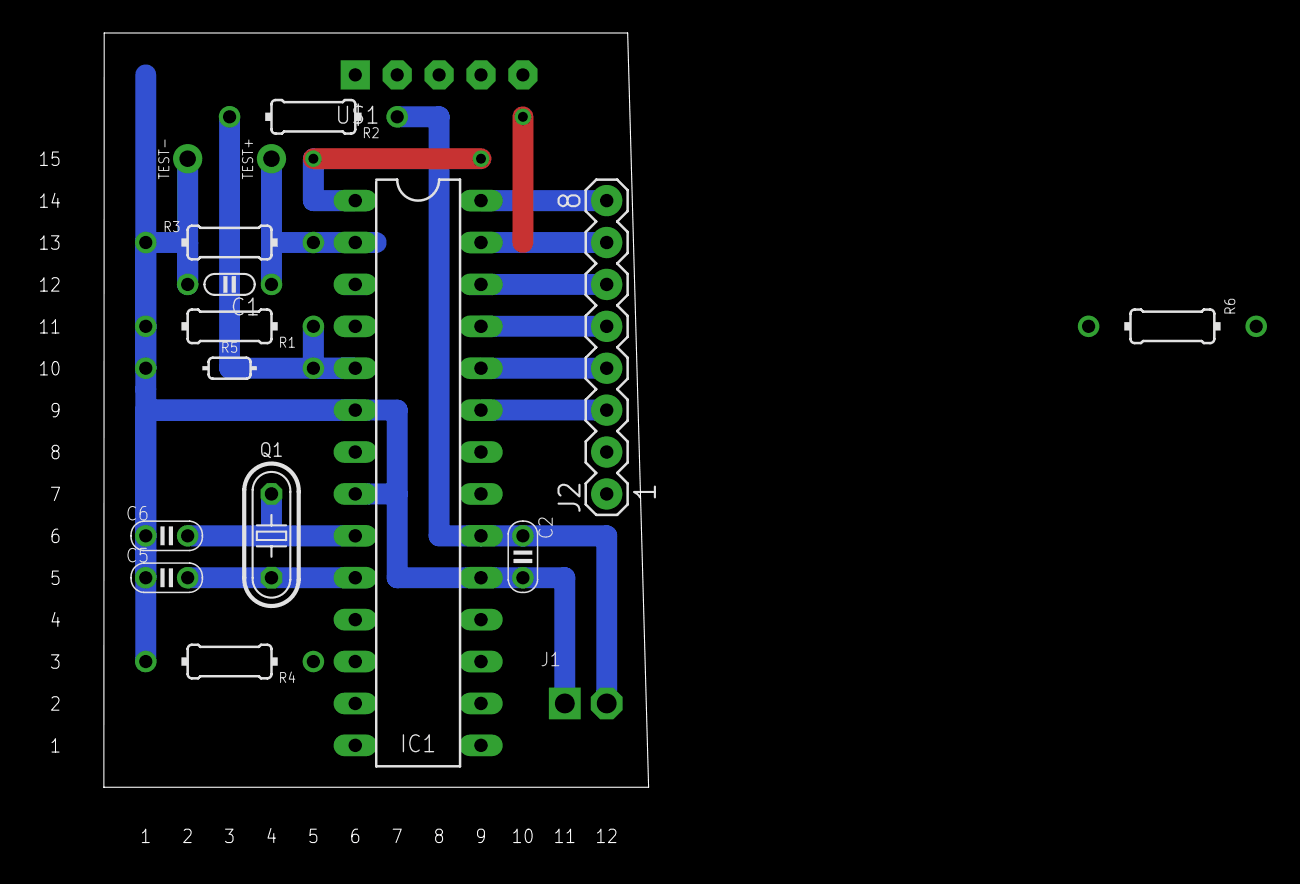
[picture p144: board CapMeter-LCD-16F876A.brd from above]

Board: 2 copper layers, 33.0 x 45.7 mm, 17 parts (0 on the bottom side), 15 nets.
