rsenn/lc-meter/eagle/attic/unrouted/LCmeter0-perfboard-norelay.brd

## EAGLE design eagle/attic/unrouted/LCmeter0-perfboard-norelay.brd (2018-07-12)

Board: 2 copper layers, 25 parts (0 on the bottom side), 24 nets.

Parts:
C1, C2: 1nF; C050-024X044
C3, C4: 10μF; E5-4
C5, C6: 33pF; C025-024X044
C7: 100μF; E2,5-6
C9: 100nF; C025-024X044
CLK: 1X02
IC1: PIC16F876A-X/SP; DIL28-3
JP1: 1X05
L1: 860u; 0204/5
LCD1: HD44780; MA08-1
Q1: 20MHz; HC49/S
Q2: BC548; TO92-EBC
R1, R2, R3: 100kΩ; 0204/7
R4: 47kΩ; 0204V
R5: 4.7kΩ; 0204/7
R6: 10kΩ; 0207/10
R10: 4.7kΩ; 0204V
SW1: SPST; PB-5-1
SW2: DPDT
UART: 1X03

Connections:
/LC: IC1.15, SW2.2-3
/MCLR: IC1.1, JP1.3, R10.1, SW1.4
A0: IC1.2, IC1.7, R1.2, R4.2
A1: C4.+, IC1.3, R4.1
A3: C3.+, IC1.5, R1.1, R2.2, R3.1
A4: IC1.6, R5.1
C2_CON: C2.2, Q2.C
CCAP: IC1.16, R6.1
D4: IC1.25, LCD1.5
D5: IC1.26, LCD1.6
D6: IC1.27, JP1.4, LCD1.7
D7: IC1.28, JP1.5, LCD1.8
E: IC1.24, LCD1.4
GND: C1.2, C4.-, C5.1, C6.1, C7.-, C9.2, CLK.1, IC1.8, IC1.19, JP1.1, LCD1.1, Q2.E, R2.1, SW1.2, UART.1
unnamed: CLK.2, IC1.11
unnamed: C1.1, C2.1, C3.-, L1.2, SW2.1-2
unnamed: Q2.B, R6.2
unnamed: L1.1, SW2.1-3, SW2.2-2
OSC1: C6.2, IC1.9, Q1.1
OSC2: C5.2, IC1.10, Q1.2
RS: IC1.23, LCD1.3
RX: IC1.18, UART.2
TX: IC1.17, UART.3
VCC: C7.+, C9.1, IC1.20, JP1.2, LCD1.2, R3.2, R5.2, R10.2
