rsenn/lc-meter/eagle/attic/unrouted/LCmeter0.brd

## EAGLE design eagle/attic/unrouted/LCmeter0.brd (2016-09-25)

Board: 2 copper layers, 25 parts (0 on the bottom side), 22 nets.

Parts:
C1, C2: 1nF; C050-025X075
C3: 10μF; E2,5-6
C4: 10μF; E5-6
C5, C6: 33pF; C050-025X075
C7: 100μF; E2,5-6
C8: 10μF; E2,5-5
C9: 100nF; C025-024X044
CON1: MA07-2
D1: 1N4148; DO35-7
IC1: PIC16F876A-X/SP; DIL28-3
K2: DS2Y
L1: 100μH; 0207/10
Q1: 20MHz; HC49U70
Q2: BC548; TO92-EBC
R1, R2: 100kΩ; 0207/10
R3: 100kΩ; 0204V
R4: 47kΩ; 0207/10
R5, R10: 4.7kΩ; 0204V
R6: 0207/10
S1: TL46PO; TL4XPO
SW1: SPST; PB-5

Connections:
/LC: IC1.15, S1.6
/MCLR: IC1.1, R10.1, SW1.3
/RELAY: D1.C, K2.1, Q2.C
A0: IC1.2, IC1.7, R1.2, R4.2
A1: C4.+, IC1.3, R4.1
A3: C3.+, IC1.5, R1.1, R2.2, R3.1
A4: IC1.6, R5.1
B2: CON1.4, IC1.23
B3: CON1.6, IC1.24
B4: CON1.11, IC1.25
B5: CON1.12, IC1.26
B6: CON1.13, IC1.27
B7: CON1.14, IC1.28
unnamed: C2.2, K2.13
unnamed: C1.1, C2.1, C3.-, L1.2, S1.1
unnamed: Q2.B, R6.2
unnamed: L1.1, S1.3, S1.4
OSC1: C6.2, IC1.9, Q1.1
OSC2: C5.2, IC1.10, Q1.2
RC5: IC1.16, R6.1
VDD: C7.+, C8.+, C9.1, IC1.20, R3.2, R5.2, R10.2
VSS: C1.2, C4.-, C5.1, C6.1, C7.-, C8.-, C9.2, CON1.1, CON1.5, D1.A, IC1.8, IC1.19, K2.9, K2.16, Q2.E, R2.1, SW1.1
