rsenn/lc-meter/eagle/attic/unrouted/LCmeter0-hd44780.brd

## EAGLE design eagle/attic/unrouted/LCmeter0-hd44780.brd (2016-09-25)

Board: 2 copper layers, 26 parts (0 on the bottom side), 24 nets.

Parts:
C1: 1nF; C050-025X075
C2: 10uF; E5-4
C3: 10uF; E5-5
C4: C025-024X044
C5: E2,5-6E
C6, C7: 22pF; C050-024X044
CCAL: 1nF; C050-025X075
D1: 1N4148; DO35-7
ICSP: FE05-1
J1: 22-27-2021-02; 6410-02
K1: DS2Y
L2: 100uH; 0204/7
LCD: FE08
Q1: HC49/S
R1, R2: 100k; 0204V
R3: 100k; 0204/7
R4: 47k; 0204V
R5: 4.7k; 0204/5
R11: 4.7k; 0204V
R12: 4.7k; 0207/10
S1: 9450-2
T1: TO92-CBE
U$2: PB-5-2; PB-5-1
U$3: PIC16F876A-X/SP-COMP-B; DIL28-3

Connections:
+5V: C4.1, C5.+, D1.C, ICSP.2, K1.1, LCD.2, R1.2, R5.2, R11.2, U$3.20
GND: C1.2, C3.-, C4.2, C5.-, C6.2, C7.2, ICSP.1, K1.4, R2.1, T1.E, U$2.2, U$3.8, U$3.19
L/C: S1.4, U$3.15
MCLR: ICSP.3, R11.1, U$2.4, U$3.1
unnamed: LCD.3, U$3.23
unnamed: LCD.4, U$3.24
unnamed: LCD.5, U$3.25
unnamed: LCD.6, U$3.26
unnamed: J1.1, S1.2
unnamed: R5.1, U$3.6
unnamed: J1.2, S1.5
unnamed: C7.1, Q1.2, U$3.10
unnamed: C6.1, Q1.1, U$3.9
unnamed: R3.1, R4.2, U$3.2, U$3.7
unnamed: R12.2, T1.B
unnamed: D1.A, K1.16, T1.C
unnamed: CCAL.2, K1.8
unnamed: C1.1, C2.+, CCAL.1, L2.2, S1.3
unnamed: L2.1, S1.1, S1.6
PGC: ICSP.4, LCD.7, U$3.27
PGD: ICSP.5, LCD.8, U$3.28
RA1: C3.+, R4.1, U$3.3
RA3: C2.-, R1.1, R2.2, R3.2, U$3.5
RELAY: R12.1, U$3.16
