rsenn/lc-meter/eagle/attic/unrouted/LCmeter0-nokia3310.brd

## EAGLE design eagle/attic/unrouted/LCmeter0-nokia3310.brd (2016-09-25)

Schematic: LCmeter0-nokia3310.sch

Parts:
C1, C5: 1nF; C050-025X075
C2, C3: 10uF; E2,5-5
C4: 220nF; C050-025X075
C6, C7: 22pF; C050-025X075
CCAL: 1nF; C050-025X075
K1: DS2Y
L2: 100uH; IR-2
R1, R3: 100k; 0204/7
R2: 100k; 0204V
R4: 47k; 0204V
R5, R12: 4.7k; 0204/7
R6, R7, R8, R9, R10: 3.3k; 0207/10
R11: 4.7k; 0204V
U$1: PB-SPST; PB-5
U$2: PIC16F876A-X/SP-COMP; DIL28-3
U$3: NOKIA-3310-64X64; 1X8
U$4: S-DPDT; DPDT

Connections:
+3V3: U$3.1 (VDD)
+5V: K1.1 (+), R1.2, R5.2, R11.2, U$2.20 (VDD); also elsewhere on the board
GND: C1.2, C3.-, C4.2, C5.2, C6.2, C7.2, K1.4, R2.1, U$1.4 (S1), U$2.8 (VSS_2), U$2.19 (VSS), U$3.6 (GND); also elsewhere on the board
L/C: U$2.21 (RB0/INT), U$4.2-3
unnamed: R6.1, U$2.12 (RC1)
unnamed: R7.1, U$2.13 (RC2)
unnamed: R8.1, U$2.14 (RC3)
unnamed: R9.1, U$2.15 (RC4)
unnamed: R10.1, U$2.16 (RC5)
unnamed: R5.1, U$2.6 (RA4)
unnamed: C5.1, R11.1, U$1.2 (P1), U$2.1 (*MCLR/VPP)
unnamed 11: C7.1, U$2.10 (OSC2); also elsewhere on the board
unnamed 12: C6.1, U$2.9 (OSC1); also elsewhere on the board
unnamed: R10.2, U$3.2 (SCK)
unnamed: R9.2, U$3.3 (SDIN)
unnamed: R8.2, U$3.4 (D_C)
unnamed: R7.2, U$3.5 (SCE)
unnamed: R6.2, U$3.8 (RES)
unnamed: C4.1, U$3.7 (VOUT)
unnamed: R3.1, R4.2, U$2.2 (RA0), U$2.7 (RA5)
unnamed 20: R12.2; also elsewhere on the board
unnamed 21: K1.16 (-); also elsewhere on the board
unnamed: CCAL.2, K1.8 (S)
unnamed: C1.1, C2.+, CCAL.1, L2.2, U$4.1-2
unnamed: L2.1, U$4.1-3, U$4.2-2
RA1: C3.+, R4.1, U$2.3 (RA1)
RA3: C2.-, R1.1, R2.2, R3.2, U$2.5 (RA3)
RELAY: R12.1, U$2.11 (RC0)

Board: 2 copper layers, 29 parts (0 on the bottom side), 27 nets.

Other parts of the board:
D1: 1N4148; DO35-7
Q1: HC49/S
T1: TO92-CBE

Their connections:
+5V: D1.C; also elsewhere on the board
GND: T1.E; also elsewhere on the board
unnamed 11: Q1.2; also elsewhere on the board
unnamed 12: Q1.1; also elsewhere on the board
unnamed 20: T1.B; also elsewhere on the board
unnamed 21: D1.A, T1.C; also elsewhere on the board
