rsenn/lc-meter/eagle/unrouted/PIC18F2550-USB-HID-LC-Meter.brd

## EAGLE design eagle/unrouted/PIC18F2550-USB-HID-LC-Meter.brd (2017-01-10)

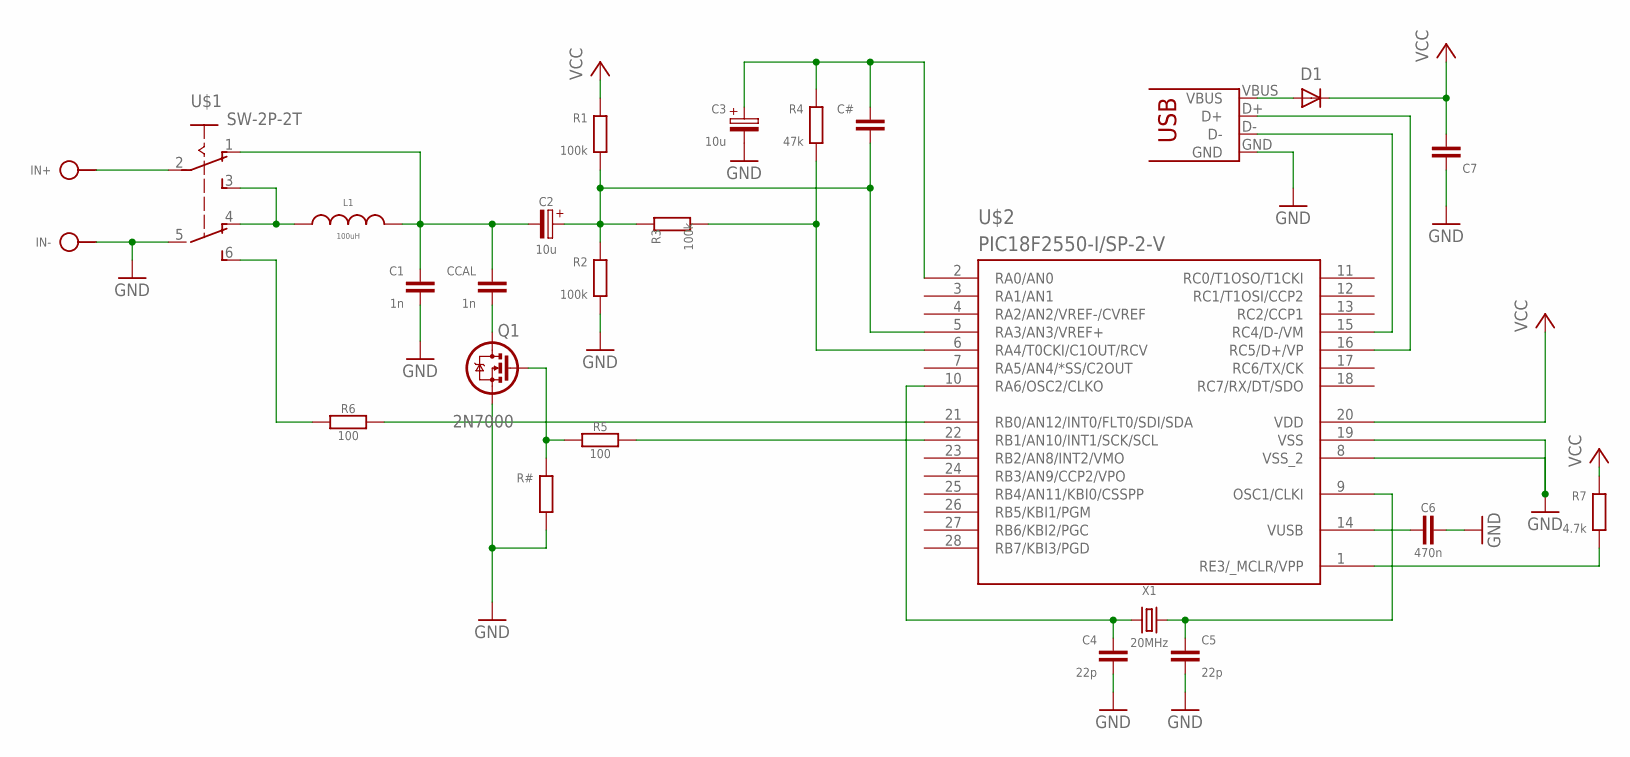
[picture p145: schematic PIC18F2550-USB-HID-LC-Meter.sch]

Parts:
C1: 1n; C050-020X036
C2: 10u; E2.5-4/V
C3: 10u; E2,5-4
C4, C5: 22p; C025-015X024/V
C6: 470n; C050-020X036
C7: C050-020X036
C#: C050-020X036
CCAL: 1n; C050-020X036
D1: 1N414834-5; DO34-5
IN+: SPAD
IN-: SPAD
J1: USB-PRINT; USB-B-PRINT
L1: 100uH; L-04/7-M
Q1: 2N7000; TO92
R1, R2, R3: 100k; 0202/7
R4: 47k; 0202/7
R5, R6: 100; 0202/7
R7: 4.7k; 0202/7
R#: R0202/7; 0202/7
U$1: SW-2P-2T; SLSW-2P2T
U$2: PIC18F2550-I/SP-2-V; DIL28-3/V
X1: 20MHz; HC49

Connections:
GND: C1.2, C3.-, C4.2, C5.2, C6.2, C7.1, IN-.1, J1.GND, Q1.1 (S), R2.1, R#.1, U$1.5 (P1), U$2.8 (VSS_2), U$2.19 (VSS)
unnamed: Q1.2 (G), R5.1, R#.2
unnamed: R7.1, U$2.1 (RE3/_MCLR/VPP)
unnamed: J1.D-, U$2.15 (RC4/D-/VM)
unnamed: J1.D+, U$2.16 (RC5/D+/VP)
unnamed: C2.+, C#.2, R1.1, R2.2, R3.2, U$2.5 (RA3/AN3/VREF+)
unnamed: C3.+, C#.1, R4.2, U$2.2 (RA0/AN0)
unnamed: R3.1, R4.1, U$2.6 (RA4/T0CKI/C1OUT/RCV)
unnamed: C1.1, C2.-, CCAL.1, L1.2, U$1.1 (O)
unnamed: R5.2, U$2.22 (RB1/AN10/INT1/SCK/SCL)
unnamed: CCAL.2, Q1.3 (D)
unnamed: C4.1, U$2.10 (RA6/OSC2/CLKO), X1.1
unnamed: C5.1, U$2.9 (OSC1/CLKI), X1.2
unnamed: C6.1, U$2.14 (VUSB)
unnamed: L1.1, U$1.3 (S), U$1.4 (O1)
unnamed: IN+.1, U$1.2
unnamed: R6.1, U$1.6 (S1)
unnamed: R6.2, U$2.21 (RB0/AN12/INT0/FLT0/SDI/SDA)
VCC: C7.2, D1.C, R1.2, R7.2, U$2.20 (VDD)
VDD: D1.A, J1.VBUS

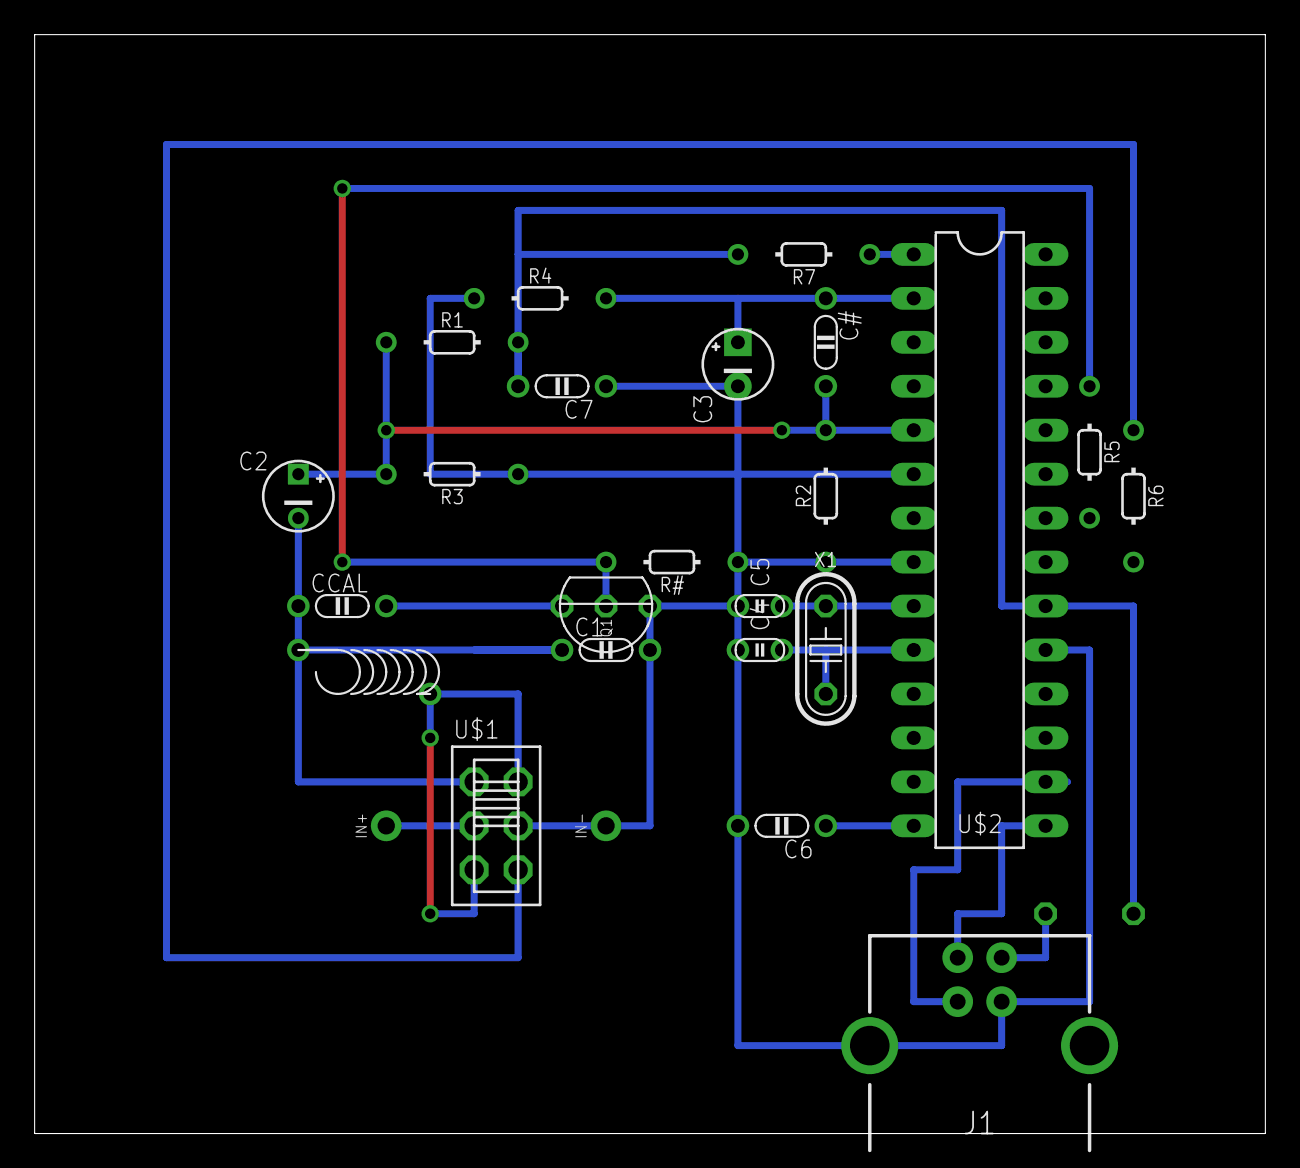
[picture p146: board PIC18F2550-USB-HID-LC-Meter.brd from above]

Board: 2 copper layers, 71.1 x 63.5 mm, 26 parts (1 on the bottom side), 20 nets.
