rsenn/lc-meter/eagle/unrouted/CapMeter-LCD-16F628A.brd

## EAGLE design eagle/unrouted/CapMeter-LCD-16F628A.brd (2017-05-13)

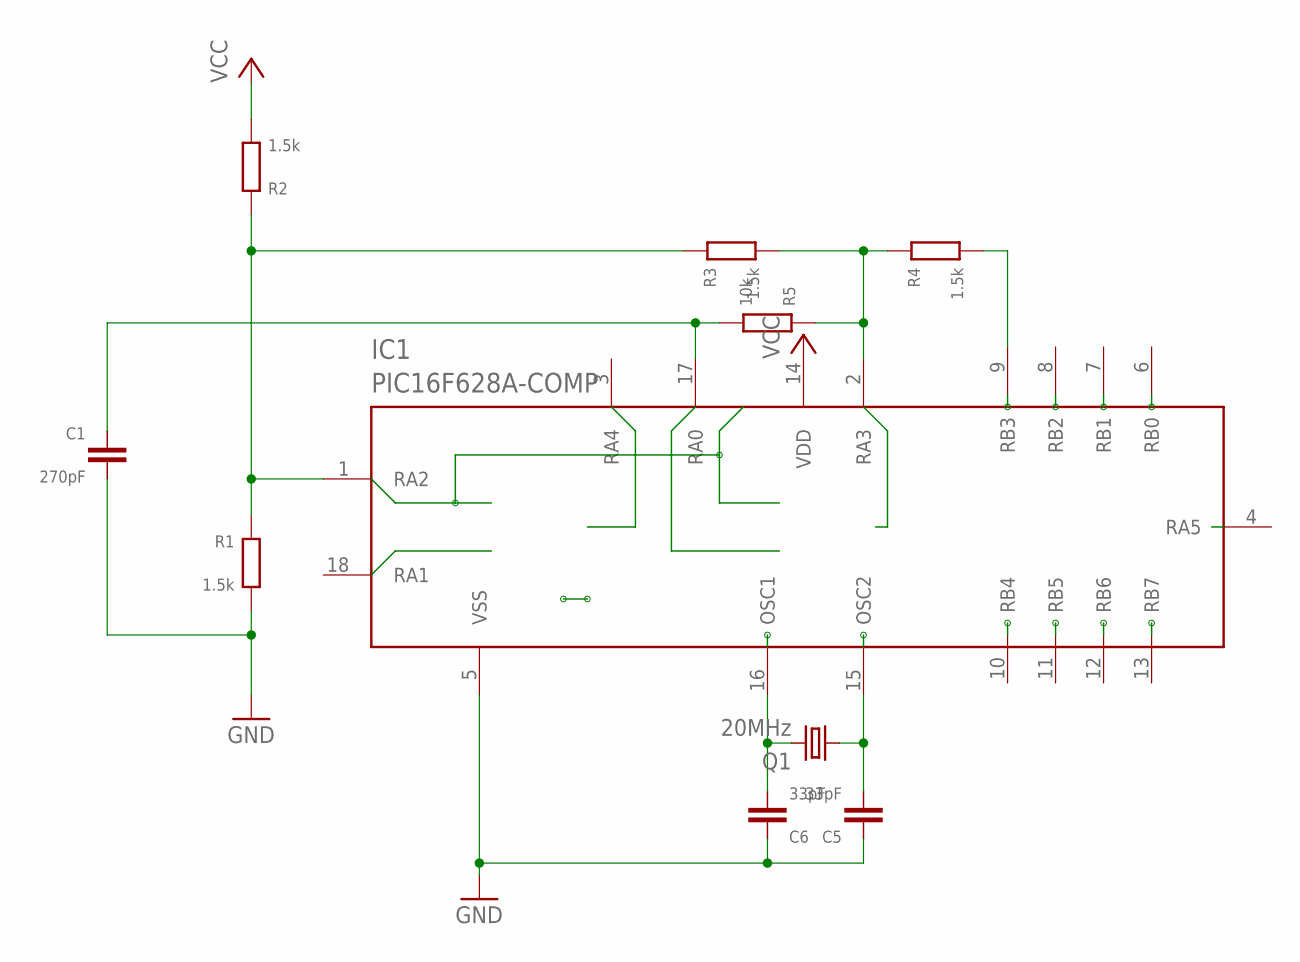
[picture p147: schematic CapMeter-LCD-16F628A.sch]

Parts:
C1: 270pF; C050-020X036
C5, C6: 33pF; C025-020X036
IC1: PIC16F628A-COMP; DIL18-3/V
Q1: 20MHz; HC49
R1, R2, R3, R4: 1.5k; 0204/10
R5: 10k; 0204/10

Connections:
GND: C1.2, C5.1, C6.1, IC1.5 (VSS), R1.1
unnamed: IC1.2 (RA3), R3.1, R4.2, R5.2
unnamed: IC1.9 (RB3), R4.1
unnamed: IC1.1 (RA2), R1.2, R2.2, R3.2
unnamed: C1.1, IC1.17 (RA0), R5.1
OSC1: C6.2, IC1.16 (OSC1), Q1.2
OSC2: C5.2, IC1.15 (OSC2), Q1.1
VCC: IC1.14 (VDD), R2.1

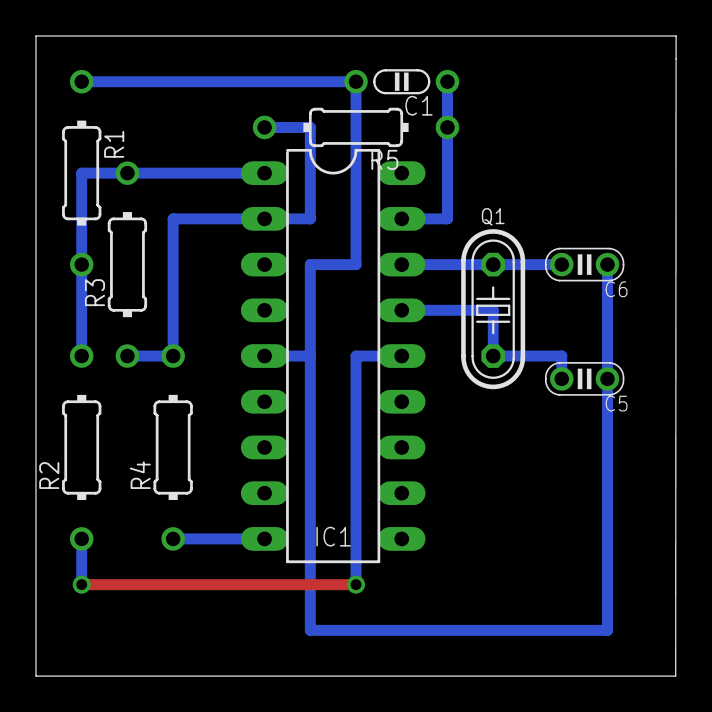
[picture p148: board CapMeter-LCD-16F628A.brd from above]

Board: 2 copper layers, 35.6 x 35.6 mm, 10 parts (0 on the bottom side), 8 nets.
