rsenn/lc-meter/807_lc_meter/eagle-sch-pcb/lcmeter.brd

## EAGLE design 807_lc_meter/eagle-sch-pcb/lcmeter.brd (2017-03-01)

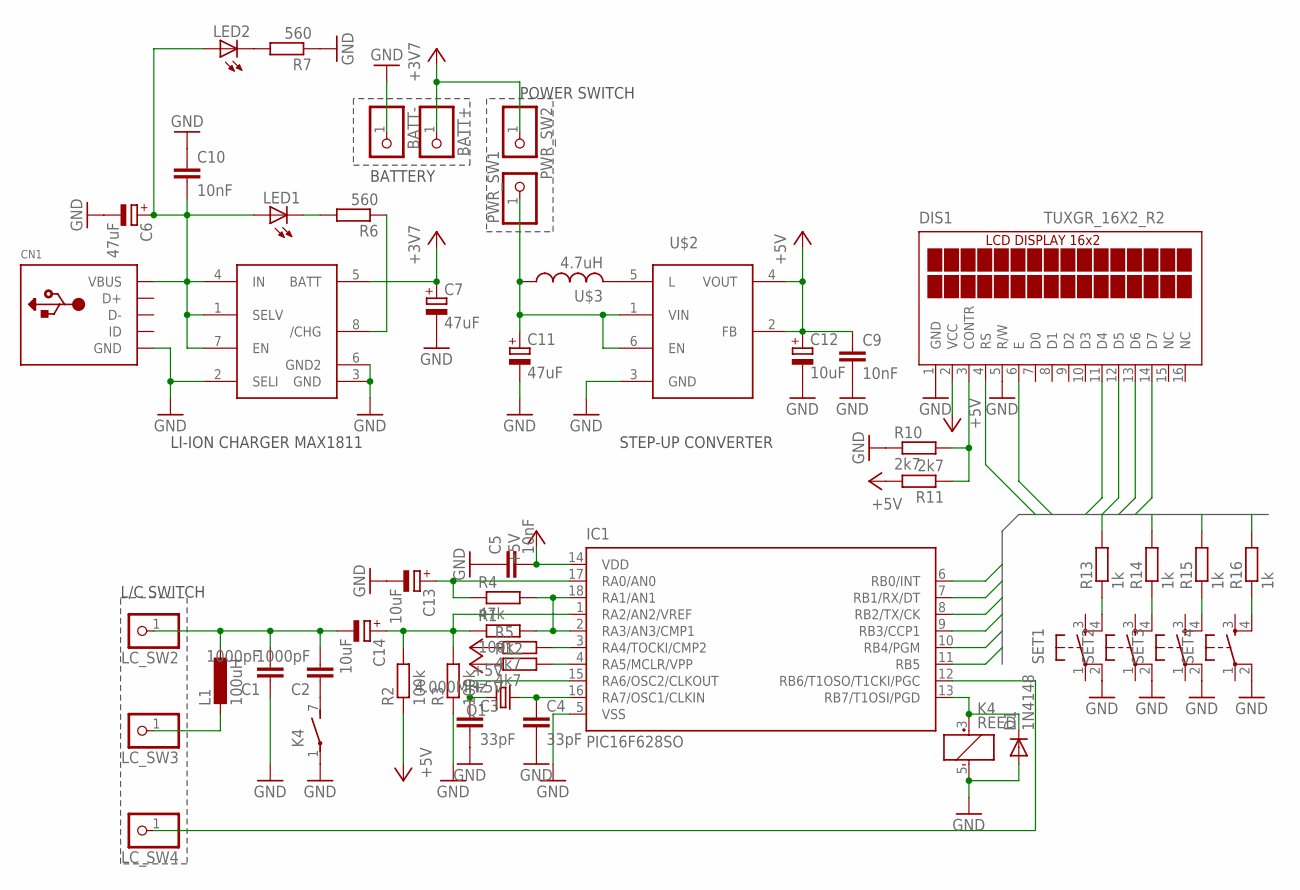
[picture p149: schematic lcmeter.sch]

Parts:
BATT+: PINHD-1X1; 1X01
BATT-: PINHD-1X1; 1X01
C1, C2: 1000pF; C0805
C3, C4: 33pF; C0805
C5, C9, C10: 10nF; C0805
C6, C7, C11: 47uF; B/3528-21W
C12, C13, C14: 10uF; B/3528-21W
CN1: USBMINIB; USB-MINIB
D1: 1N4148; MINIMELF
DIS1: TUXGR_16X2_R2
IC1: PIC16F628SO; SO-18W
K4: REED
L1: 100uH; 0204/5
LC_SW2, LC_SW3, LC_SW4: PINHD-1X1; 1X01
LED1, LED2: LED1206; LED-1206
PWR_SW1, PWR_SW2: PINHD-1X1; 1X01
Q1: 4.000MHz; CRYSTAL_SM49
R1, R2, R3: 100k; R0603
R4: 47k; R0603
R5, R12: 4k7; R0603
R6, R7: 560; R0603
R10, R11: 2k7; R0603
R13, R14, R15, R16: 1k; R0603
SET1, SET2, SET3, SET4: TAC_SWITCHPTH; TACTILE-PTH
U$1: MAX1811SO8; SO08
U$2: TPS6122XSOT-6; SOT23-6
U$3: 4.7uH; EPL3015

Connections:
+3V3: BATT+.1, C7.+, PWR_SW2.1, U$1.5 (BATT)
+5V: C5.2, C9.1, C12.+, DIS1.2 (VCC), IC1.14 (VDD), R2.1, R5.1, R11.2, R12.1, U$2.2 (FB), U$2.4 (VOUT)
GND: BATT-.1, C1.1, C3.2, C4.2, C5.1, C6.-, C7.-, C9.2, C10.1, C11.-, C12.-, C13.-, CN1.GND, D1.A, DIS1.1 (GND), DIS1.5 (R/W), IC1.5 (VSS), K4.1, K4.5 (-), R3.1, R7.1, R10.1, SET1.2, SET2.2, SET3.2, SET4.2, U$1.2 (SELI), U$1.3 (GND), U$1.6 (GND2), U$2.3 (GND)
LCDPIN0: DIS1.4 (RS), IC1.6 (RB0/INT)
LCDPIN1: DIS1.6 (E), IC1.7 (RB1/RX/DT)
LCDPIN2: DIS1.11 (D4), IC1.8 (RB2/TX/CK), R13.2
LCDPIN3: DIS1.12 (D5), IC1.9 (RB3/CCP1), R14.2
LCDPIN4: DIS1.13 (D6), IC1.11 (RB5), R15.2
LCDPIN5: DIS1.14 (D7), IC1.10 (RB4/PGM), R16.2
unnamed: C13.+, IC1.17 (RA0/AN0), R4.1
unnamed: IC1.2 (RA3/AN3/CMP1), IC1.18 (RA1/AN1), R1.2, R4.2
unnamed: C14.+, IC1.1 (RA2/AN2/VREF), R1.1, R2.2, R3.2
unnamed: C1.2, C2.2, C14.-, L1.1, LC_SW2.1
unnamed: DIS1.3 (CONTR), R10.2, R11.1
unnamed: C2.1, K4.7 (S)
unnamed: IC1.3 (RA4/TOCKI/CMP2), R5.2
unnamed: IC1.12 (RB6/T1OSO/T1CKI/PGC), LC_SW4.1
unnamed: C4.1, IC1.16 (RA7/OSC1/CLKIN), Q1.1
unnamed: C3.1, IC1.15 (RA6/OSC2/CLKOUT), Q1.2
unnamed: D1.C, IC1.13 (RB7/T1OSI/PGD), K4.3 (+)
unnamed: R13.1, SET1.4
unnamed: R14.1, SET2.4
unnamed: R15.1, SET3.4
unnamed: R16.1, SET4.4
unnamed: IC1.4 (RA5/MCLR/VPP), R12.2
unnamed: L1.2, LC_SW3.1
unnamed: C6.+, C10.2, CN1.VBUS, LED1.A, LED2.A, U$1.1 (SELV), U$1.4 (IN), U$1.7 (EN)
unnamed: U$2.5 (L), U$3.P$2 (2)
unnamed: LED1.C, R6.2
unnamed: R6.1, U$1.8 (/CHG)
unnamed: C11.+, PWR_SW1.1, U$2.1 (VIN), U$2.6 (EN), U$3.P$1 (1)
unnamed: LED2.C, R7.2

Notes on the sheet:
POWER SWITCH
BATTERY
L/C SWITCH
STEP-UP CONVERTER
LI-ION CHARGER MAX1811

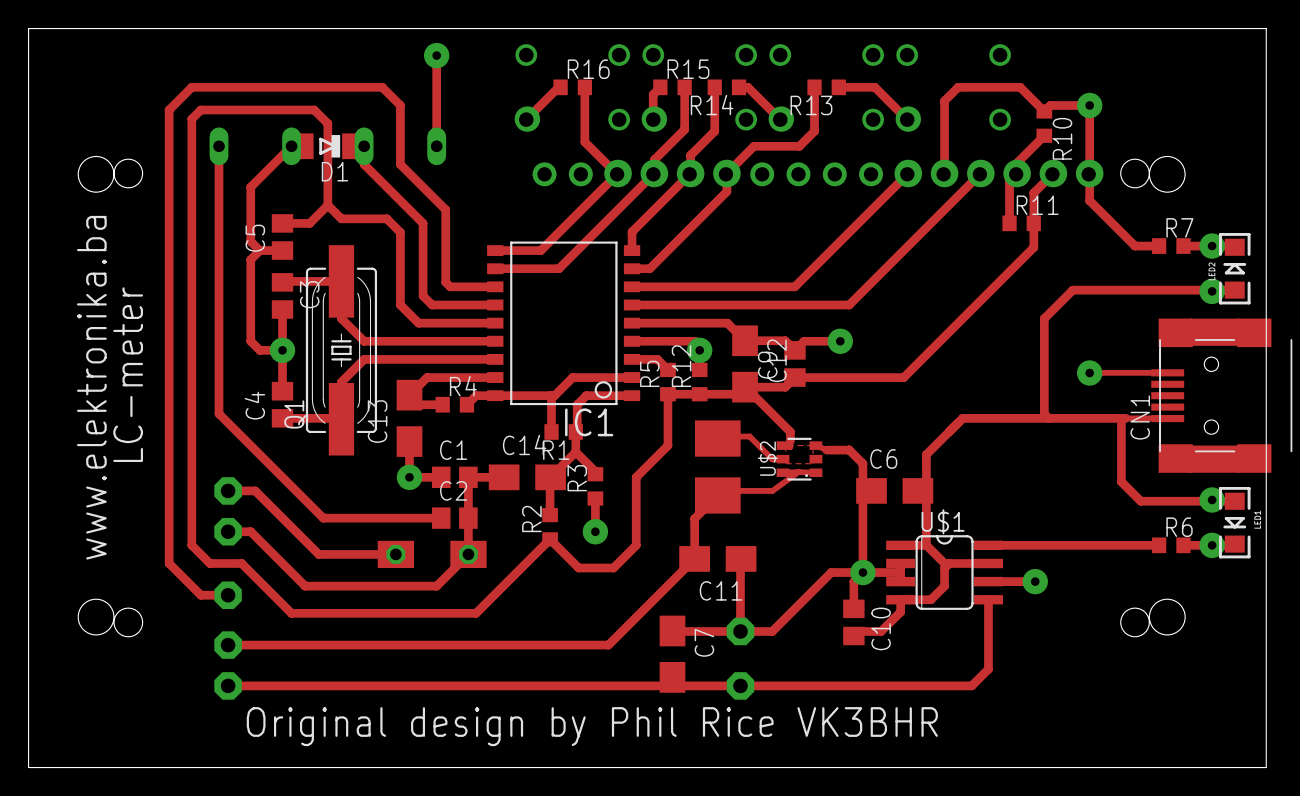
[picture p150: board lcmeter.brd from above]

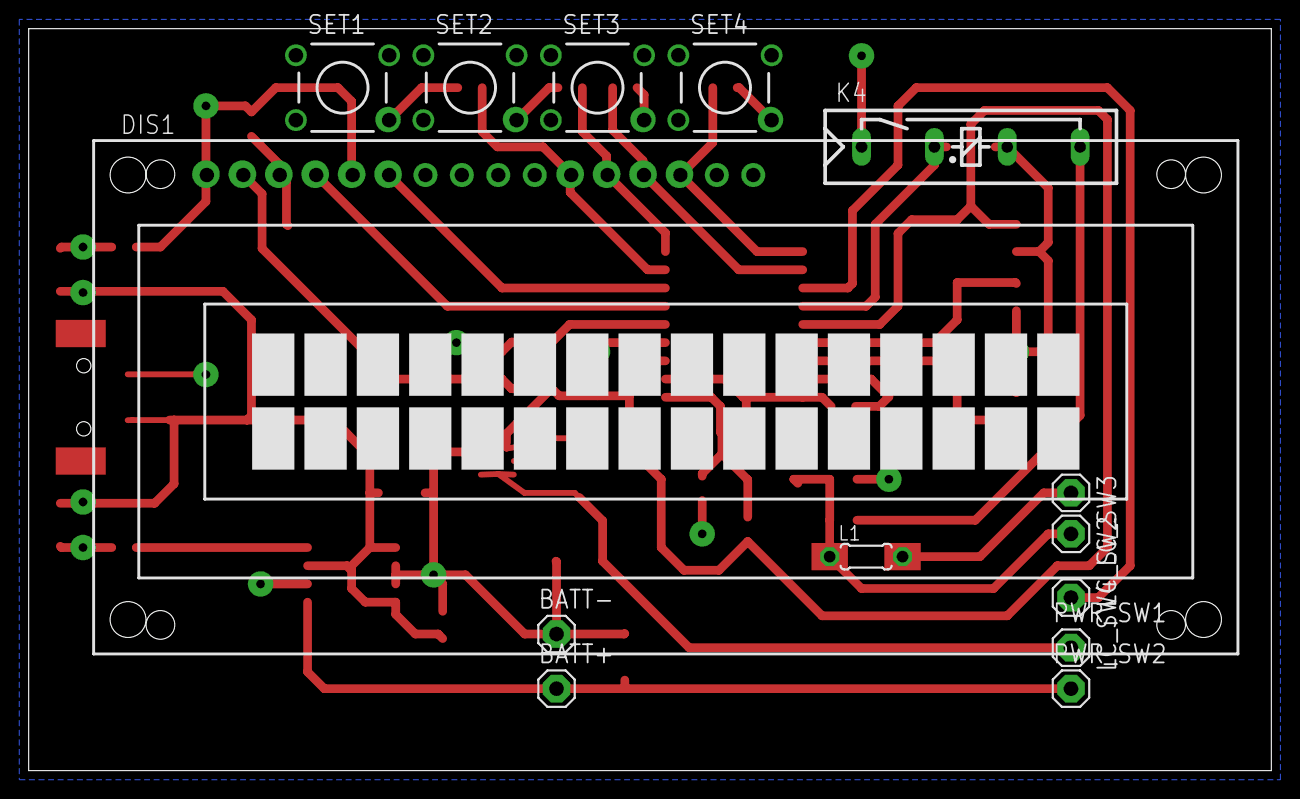
[picture p151: board lcmeter.brd from below]

Board: 2 copper layers, 86.7 x 51.7 mm, 50 parts (14 on the bottom side), 32 nets.
