rsenn/lc-meter/src/lcd_cfg.h

//------------------------------------------------------
/* File:       Library for HD44780 compatible displays  */
/* Version:	   v2.01  						 			*/
/* Author:     GrAnd/www.MakeSystem.net		 			*/
/* Tested on:  AVR, STM32F10X			 	 		 	*/
/* License:	   GNU LGPLv2.1		 		 	 			*/
//------------------------------------------------------
/* Copyright (C)2014 GrAnd. All right reserved 			*/
//------------------------------------------------------

/*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
Contact information :
                        mail@makesystem.net
                        http://makesystem.net/?page_id=2
*/

#ifndef LCD_CFG_H
#define LCD_CFG_H

/* Include here the header file of your microcontroller */
#include <pic.h>

/* SET LCD<->MCU CONNECTIONS */
/* E - Starts data read/write. */
#define LCD_E_OUT PORTA /* Output register */
#define LCD_E 1         /* Pin number */

/* RS - Selects registers.
 * 0:	Instruction register (for write)
 * 0:	Busy flag + address counter (for read)
 * 1:	Data register (for write and read) */
#define LCD_RS_OUT PORTA /* Output register */
#define LCD_RS 0         /* Pin number */

/* R/W - Selects read or write.
 * 0:	Write
 * 1:	Read */
#define LCD_RW_OUT PORTA /* Output register */
#define LCD_RW 6         /* Pin number */

/* DB4 to DB7 - Four high order bidirectional tristate data bus pins.
 * Used for data transfer and receive between the MPU and the HD44780U.
 * DB7 can be used as a busy flag. */
#define LCD_D7_OUT PORTA /* Output register */
#define LCD_D7_IN PORTA  /* Input register */
#define LCD_D7_IO TRISA  /* Input register */
#define LCD_D7 5         /* Pin number */

#define LCD_D6_OUT PORTA /* Output register */
#define LCD_D6 4         /* Pin number */

#define LCD_D5_OUT PORTA /* Output register */
#define LCD_D5 3         /* Pin number */

#define LCD_D4_OUT PORTA /* Output register */
#define LCD_D4 2         /* Pin number */

//-------------------------------
// DEFAULT CONFIGURATIONS
//-------------------------------
#define DEFAULT_DISPLAY_CONFIG DISPLAY_CONFIG_4bit_2L_5x8
#define DEFAULT_ENTRY_MODE ENTRY_MODE_INC_NO_SHIFT
#define DEFAULT_VIEW_MODE VIEW_MODE_DispOn_BlkOff_CrsOff
#define USE_BUSY_FLAG 0 /* 1 (1) or 0 (false) */

//-------------------------------
// SET MCU TIMINGS
//-------------------------------
#define MCU_FREQ_VALUE 16      /* MHz. Minimal value = 1 MHz */
#define BUSY_CYCLE_TIME 5      /* x 10us. See datasheet for minimal value. */
#define CLRSCR_CYCLE_TIME 200  /* x 10us. See datasheet for minimal value. */
#define RETHOME_CYCLE_TIME 200 /* x 10us. See datasheet for minimal value. */

//-------------------------------
// CONFIGURE LCD WITH 4 LINES
//-------------------------------
#define START_ADDRESS_3rd_LINE 0x10
#define START_ADDRESS_4th_LINE 0x50

//-------------------------------
// SET FORMATTED OUTPUT OPTIONS
//-------------------------------
#define USE_FORMATTED_OUTPUT 1 /* 1 (1) or 0 (false) */
#define TAB_SPACE 4            /* 1 .. 255 */

//-------------------------------
// PROGRESS BAR OPTIONS
//-------------------------------
#define USE_PROGRESS_BAR 1             /* 1 (1) or 0 (false) */
#define USE_REGRESS_BAR 1              /* 1 (1) or 0 (false) */
#define PROGRESS_BAR_LINE LCD_2nd_LINE /* Select lcd line: 1, 2, 3, 4, ... */
#define PROGRESS_BAR_HEIGHT 8          /* in pixel: 1(min), 2, 3, 4, 5, 6, 7, 8(max) */
#define PROGRESS_BAR_WIDTH 16          /* Number of chars in lcd line:  1, 2, .. , 8, 16, 20 */

//-------------------------------
// LCDlib CALLBACKS
//-------------------------------
#if(USE_BUSY_FLAG)

#define Set_D7_as_Input() LCD_D7_IO |= (1 << LCD_D7)
#define Set_D7_as_Outut() LCD_D7_IO &= ~(1 << LCD_D7)

#endif /* USE_BUSY_FLAG */

extern void gpio_init(void);
#define Set_All_pins_as_Outputs() gpio_init()

#endif /* LCD_CFG_H */

//-------------------------------
/* THE END */
//-------------------------------
