rsenn/lc-meter/doc/LC_meter_pic16f876A_(diagram_and_source_code)/lcd3310.c

/*
NOKIA 3310 LCD driver library
84x48 lcd display PCD8544
by Regulus Berdin

V1.0 11/23/04 	Created.
*/
//#include <pic.h>
#include <htc.h>
#include "lcd3310.h"
#ifndef _XTAL_FREQ
#define _XTAL_FREQ 20000000
#endif

static const char lcd_font[][5] = {
  {0x00, 0x00, 0x00, 0x00, 0x00}, // sp
  {0x00, 0x00, 0x2f, 0x00, 0x00}, // !
  {0x00, 0x07, 0x00, 0x07, 0x00}, // "
  {0x14, 0x7f, 0x14, 0x7f, 0x14}, // #
  {0x24, 0x2a, 0x7f, 0x2a, 0x12}, // $
  //	{ 0xc4, 0xc8, 0x10, 0x26, 0x46 },  // %
  {
    0b00100011,                    //%
    0b00010011,
    0b00001000,
    0b01100100,
    0b01100010
  },

  {0x36, 0x49, 0x55, 0x22, 0x50}, // &
  {0x00, 0x05, 0x03, 0x00, 0x00}, // '
  {0x00, 0x1c, 0x22, 0x41, 0x00}, // (
  {0x00, 0x41, 0x22, 0x1c, 0x00}, // )
  {0x14, 0x08, 0x3E, 0x08, 0x14}, // *
  {0x08, 0x08, 0x3E, 0x08, 0x08}, // +
  {0x00, 0x00, 0x50, 0x30, 0x00}, // ,
  {0x10, 0x10, 0x10, 0x10, 0x10}, // -
  {0x00, 0x60, 0x60, 0x00, 0x00}, // .
  {0x20, 0x10, 0x08, 0x04, 0x02}, // /
  {0x3E, 0x51, 0x49, 0x45, 0x3E}, // 0
  {0x00, 0x42, 0x7F, 0x40, 0x00}, // 1
  {0x42, 0x61, 0x51, 0x49, 0x46}, // 2
  {0x21, 0x41, 0x45, 0x4B, 0x31}, // 3
  {0x18, 0x14, 0x12, 0x7F, 0x10}, // 4
  {0x27, 0x45, 0x45, 0x45, 0x39}, // 5
  {0x3C, 0x4A, 0x49, 0x49, 0x30}, // 6
  {0x01, 0x71, 0x09, 0x05, 0x03}, // 7
  {0x36, 0x49, 0x49, 0x49, 0x36}, // 8
  {0x06, 0x49, 0x49, 0x29, 0x1E}, // 9
  {0x00, 0x36, 0x36, 0x00, 0x00}, // :
  {0x00, 0x56, 0x36, 0x00, 0x00}, // ;
  {0x08, 0x14, 0x22, 0x41, 0x00}, // <
  {0x14, 0x14, 0x14, 0x14, 0x14}, // =
  {0x00, 0x41, 0x22, 0x14, 0x08}, // >
  {0x02, 0x01, 0x51, 0x09, 0x06}, // ?
  {0x32, 0x49, 0x59, 0x51, 0x3E}, // @
  {0x7E, 0x11, 0x11, 0x11, 0x7E}, // A
  {0x7F, 0x49, 0x49, 0x49, 0x36}, // B
  {0x3E, 0x41, 0x41, 0x41, 0x22}, // C
  {0x7F, 0x41, 0x41, 0x22, 0x1C}, // D
  {0x7F, 0x49, 0x49, 0x49, 0x41}, // E
  {0x7F, 0x09, 0x09, 0x09, 0x01}, // F
  {0x3E, 0x41, 0x49, 0x49, 0x7A}, // G
  {0x7F, 0x08, 0x08, 0x08, 0x7F}, // H
  {0x00, 0x41, 0x7F, 0x41, 0x00}, // I
  {0x20, 0x40, 0x41, 0x3F, 0x01}, // J
  {0x7F, 0x08, 0x14, 0x22, 0x41}, // K
  {0x7F, 0x40, 0x40, 0x40, 0x40}, // L
  {0x7F, 0x02, 0x0C, 0x02, 0x7F}, // M
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
};

unsigned char
lcd_str_width(const char* c) {
  unsigned char i;

  i = 0;
  while(*c) {
    ++i;
    ++c;
  }
  //	return i;
  return ((i << 1) + i) << 1; // return i*6
}

#define CLK_IN(data, bitnum)                                                                                           \
  NOP();                                                                                                               \
  LCD_CLK = 0;                                                                                                         \
  NOP();                                                                                                               \
  LCD_DATA = 0;                                                                                                        \
  if((data) & (bitnum)) {                                                                                              \
    LCD_DATA = 1;                                                                                                      \
  }                                                                                                                    \
  NOP();                                                                                                               \
  LCD_CLK = 1

void
lcd_send(unsigned char a, unsigned char cmd) {
  // set if data or command byte
  LCD_DC = 1;
  if(cmd == LCD_TCMD) {
    LCD_DC = 0;
  }
  NOP();
  LCD_CE = 0;

  // clock in data in A
  CLK_IN(a, BIT7);
  CLK_IN(a, BIT6);
  CLK_IN(a, BIT5);
  CLK_IN(a, BIT4);
  CLK_IN(a, BIT3);
  CLK_IN(a, BIT2);
  CLK_IN(a, BIT1);
  CLK_IN(a, BIT0);

  NOP();
  LCD_CE = 1;
}

void
lcd_init(void) {
  LCD_TRIS();
  __delay_ms(20);
  // delay10ms(20);
  NOP();
  LCD_CLK = 0;
  NOP();
  LCD_DATA = 1;
  NOP();
  LCD_DC = 0;
  NOP();
  LCD_CE = 1;
  NOP();

  // reset LCD
  LCD_RESET = 0;
  __delay_ms(20);
  // delay10ms(20);
  LCD_RESET = 1;

#if 1

  lcd_send(0x21, LCD_TCMD); // extended commands
  lcd_send(0xC8, LCD_TCMD); // Vop (contrast)
  lcd_send(0x06, LCD_TCMD); // Temp coefficient
  lcd_send(0x13, LCD_TCMD); // LCD bias mode 1:48

  lcd_send(0x20, LCD_TCMD); // LCD standard, Horiz addressing

  lcd_send(0x0C, LCD_TCMD); // display control LCD normal mode
  //	lcd_send(0b00001101,LCD_TCMD);	//display control LCD invert mode
  //	lcd_send(0b00001001, LCD_TCMD);	//turn on all segments

#else

  lcd_send(0xA6, LCD_TCMD); // normal, 0xA7 negative
  lcd_send(0xA3, LCD_TCMD); // bias
  lcd_send(0xA1, LCD_TCMD); // addressing
  lcd_send(0xC0, LCD_TCMD); // direct, linear, normal

  lcd_send(0x22, LCD_TCMD); // V5 voltage
  lcd_send(0x81, LCD_TCMD); //(volume electric)
  lcd_send(0x2E, LCD_TCMD); // multiplier+stabilizer voltage
  lcd_send(0x2F, LCD_TCMD); // urmarire?
  lcd_send(0xE3, LCD_TCMD); // nop
  lcd_send(0x40, LCD_TCMD); // linear start address
  lcd_send(0xAF, LCD_TCMD); // lcd on, 0xAE lcd off

  lcd_send(0xA5, LCD_TCMD); // lcd all on, test?

#endif
}

void
lcd_test(void) {
  unsigned int i;

  lcd_gotoxy(0, 0);
  for(i = 0; i < 504; ++i) {
    lcd_send(i, LCD_TDATA);
  }
}

void
lcd_clear(void) {
  unsigned int i;

  lcd_gotoxy(0, 0);
  for(i = 0; i < 504; ++i) {
    lcd_send(0, LCD_TDATA);
  }
}

void
lcd_gotoxy(unsigned char x, unsigned y) {
  lcd_send(x | 0b10000000, LCD_TCMD);
  lcd_send((y & 0b00000111) | 0b01000000, LCD_TCMD);
}

void
lcd_putch(unsigned char c) {
  if(c > 'z' || c < 32) {
    return;
  }

  lcd_send(lcd_font[c - 32][0], LCD_TDATA);
  lcd_send(lcd_font[c - 32][1], LCD_TDATA);
  lcd_send(lcd_font[c - 32][2], LCD_TDATA);
  lcd_send(lcd_font[c - 32][3], LCD_TDATA);
  lcd_send(lcd_font[c - 32][4], LCD_TDATA);
  lcd_send(0, LCD_TDATA);
}

#if 1
void
lcd_puts(const char* s) {
  while(*s) {
    lcd_putch(*s);
    ++s;
  }
  // while(*s) {lcd_putch(*s++);}
}

void
lcd_center_puts(unsigned char y, const char* c) {
  lcd_gotoxy(41 - (lcd_str_width(c) / 2), y);
  lcd_puts(c);
}

#endif

void
lcd_puts2(char* s) {
  while(*s) {
    lcd_putch(*s);
    ++s;
  }
  // while(*s) {lcd_putch(*s++);}
}

void
lcd_clear_line(unsigned char y) {
  unsigned char k;
  lcd_gotoxy(0, y);
  for(k = 0; k < 83; ++k) {
    lcd_send(0, LCD_TDATA);
  }
}

void
lcd_center_puts2(unsigned char y, char* c, unsigned char len) {
  lcd_gotoxy(42 - (len << 1) - len, y);
  while(len) {
    lcd_putch(*c);
    ++c;
    --len;
  }
}

const char bat_symbol[] = {0b00111000,
                           0b11111110,
                           0b10000010,
                           0b10000010,
                           0b10000010,
                           0b10000010,
                           0b10000010,
                           0b10000010,
                           0b10000010,
                           0b10000010,
                           0b10000010,
                           0b10000010,
                           0b11111110
                          };

void
lcd_battery(unsigned char chg) {
  unsigned char i;

  chg = 12 - chg;
  lcd_gotoxy(71, 0);
  for(i = 0; i < 13; ++i) {
    if(i >= chg) {
      lcd_send(0b11111110, LCD_TDATA);
    } else {
      lcd_send(bat_symbol[i], LCD_TDATA);
    }
  }
}

#if 0
void lcd_bluetooth(void) {
  lcd_gotoxy(0, 0);
  lcd_send(0b00101000, LCD_TDATA);
  lcd_send(0b11111110, LCD_TDATA);
  lcd_send(0b10010010, LCD_TDATA);
  lcd_send(0b01101100, LCD_TDATA);
}
#endif

void
lcd_symbol(const char* sym) {
  unsigned char i, n;

  n = sym[0];
  for(i = 1; i <= n; ++i) {
    lcd_send(sym[i], LCD_TDATA);
  }
}
