rsenn/lc-meter/Attic/ser.c

/*
 * Distributed by www.microchipC.com - one of the web's largest
 * repositories of C source code for Microchip PIC micros.
 *
 * ser.c
 *
 * Interrupt Driven Serial Routines with Circular FIFO
 * Copyright (c) 2006, Regulus Berdin
 * All rights reserved.
 *
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
 */
#ifdef USE_SER
#define _SER_C_
#include "device.h"
#include "oscillator.h"
#include "ser.h"
#include "uart.h"
#include "const.h"

#ifndef SER_BRG
//# if HIGH_SPEED == 1
#define SER_BRG ((uint16_t)((double)(_XTAL_FREQ) / (16 * (double)(UART_BAUD))) - 1)
//# else
//#  define SER_BRG ((uint16_t)((double)(_XTAL_FREQ) / (64 * (double)(UART_BAUD))) - 1)
//# endif
#endif

uint8_t ser_brg = ((_XTAL_FREQ) / (16 * (UART_BAUD))) - 1;

uint8_t rxfifo[SER_BUFFER_SIZE];
volatile uint8_t rxiptr, rxoptr;
/*bank1*/ uint8_t txfifo[SER_BUFFER_SIZE];
volatile uint8_t txiptr, txoptr;
uint8_t ser_tmp;

bit
ser_isrx(void) {
  if(OERR) {
    CREN = 0;
    CREN = 1;
    return 0;
  }
  return (rxiptr != rxoptr);
}

uint8_t
ser_getch(void) {
  uint8_t c;

  while(ser_isrx() == 0) continue;

  GIE = 0;
  c = rxfifo[rxoptr];
  ++rxoptr;
  rxoptr &= SER_FIFO_MASK;
  GIE = 1;
  return c;
}

void
ser_putch(char c) {
  while(((txiptr + 1) & SER_FIFO_MASK) == txoptr) continue;
  GIE = 0;
  txfifo[txiptr] = c;
  txiptr = (txiptr + 1) & SER_FIFO_MASK;
  TXIE = 1;
  GIE = 1;
}

void
ser_puts(const char* s) {
  while(*s) ser_putch(*s++);
}
void
ser_put(const char* s, unsigned n) {
  while(n--) ser_putch(*s++);
}

void
ser_puts2(uint8_t* s) {
  while(*s) ser_putch(*s++);
}

void
ser_puthex(uint8_t v) {
  uint8_t c;

  c = v >> 4;
  if(c > 9) {
    ser_putch((char)('A' - 10 + c));
  } else {
    ser_putch((char)('0' + c));
  }

  c = v & 0x0F;
  if(c > 9) {
    ser_putch((char)('A' - 10 + c));
  } else {
    ser_putch((char)('0' + c));
  }
}

void
ser_init(void) {
  /*SER_TX_TRIS =  OUTPUT;
  SER_TX_PIN = LOW;*/
  SER_TX_TRIS = INPUT;
  SER_RX_PIN = INPUT;

  BRGH = 1; // high speed
  //	SPBRG=25;				//9,600 @ 4MHz, SPBRG = (4MHz/(16*BAUD_RATE))-1;
  //	SPBRG=12;				//19.2K @ 4MHz, SPBRG = (4MHz/(16*BAUD_RATE))-1;
  //	SPBRG=39;				//31.25K @ 20MHz, SPBRG = (20MHz/(16*BAUD_RATE))-1;
  //	SPBRG=64;				//19.2K @ 20MHz, SPBRG = (20MHz/(16*BAUD_RATE))-1;
  SPBRG = ser_brg; // 56.7K @ 20MHz, SPBRG = (20MHz/(16*BAUD_RATE))-1;
  //	SPBRG=10;				//115.2K @ 20MHz, SPBRG = (20MHz/(16*BAUD_RATE))-1;

  TX9 = 0; // 8 bits
  RX9 = 0; //

  SYNC = 0; // uart settings
  SPEN = 1;
  CREN = 1;
  TXIE = 0;
  //  RCIE = 1;
  TXEN = 1;
  PEIE = 1;

  rxiptr = rxoptr = txiptr = txoptr = 0;
}

#endif // USE_SER
