rsenn/lc-meter/(commit log)

2016-09-25 merged back libraries from pictest
    [LCmeter0-LCD-8pinlcd-PIC-COMP.brd, LCmeter0-LCD-8pinlcd-PIC-COMP.sch]
2016-11-22 switch changes
    [LCmeter0-LCD-8pinlcd-PIC-COMP.brd, LCmeter0-LCD-8pinlcd-PIC-COMP.sch]
2016-11-22 switch changes
    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
    [LCmeter0-LCD-8pinlcd-PIC-COMP.brd, LCmeter0-LCD-8pinlcd-PIC-COMP.sch]
2016-11-28 fixed config fuses for original code
    [main.h]
2026-08-28 Add tests/: three-way Thomson-formula verification harness
    double/fixed32/float24 implementations, each dual-target (host with
    printf + no-stdio MCU build). Host round-trip under gcc and tcc,
    simulator round-trips via MPLAB X mdb (XC8) and gpsim (SDCC+gputils),
    a code-size comparison across both compilers, and a writeup of a real
    SDCC pic14 RAM-bank-placement bug found along the way.
    Claude-Session: https://claude.ai/code/session_01RJHUxCZaW1Hva6hU7V761h
2026-08-28 Fix xc8 MATH_SOURCES build bug; wire up DEVICE_EMIT_CONFIG_WORD; add TODO/work docs
    - build/vars.mk: remove dead MATH_SOURCES (frexpf.c/log10f.c/logf.c)
    inclusion for xc8 builds - those files don't exist in the repo, and
    XC8's own runtime already provides them; this broke every xc8 build.
    - src/config-bits.h: define DEVICE_EMIT_CONFIG_WORD (see lib/device.h)
    - included only by main()-containing sources, so exactly one
    translation unit per link emits the SDCC __config_word section.
    - lib: bump submodule to pick up the matching device.h/interrupt.h/
    format.c portability fixes and the new fixedmath/float24 libraries.
    - TODO.md: full findings/plan for the float-to-fixed-point migration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
    [config-bits.h]
2026-11-04 Repair LC-meter: ground, comparator/Timer0 config, fixed point, display, docs
    Hardware: DUT- / S1 pole-2 common were not connected to GND in any
    schematic or board; GND flag added to all six .sch, M- merged into GND in the
    boards, EAGLE scripts for the schematic fix.
    Firmware: RA5 (C2OUT) must be an output (TRISA = 0b11001111), OPTION_REG no
    longer clears T0CS, Timer0 prescaler assigned to Timer0 (lib), fixed-point
    Thomson maths (USE_FIXED) for counts up to 65535 with uH fallback above
    42.9 mH, HD44780 output rewritten (label / reading / unit, micro sign),
    serial output independent of the LCD, 32-bit float flags at compile and link,
    fixedmath.c in both build files.
    Tests: tests/run_mdb_dis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
